zhaoxiaofeng44/robot_arm/README.md

# myArm — 3D打印肘关节机构 + 三节手指机构 + 整手机构（单指反根验证版）

仿人手臂/手指的双关节直线驱动机构：一台贴臂圆柱直线电机通过一根刚性连杆驱动一个转动关节。
所有关节均为**外购可拆肩螺栓（塞打螺丝）+ 平垫 + 尼龙自锁螺母**，全机一套内六角扳手即可反复拆装。

## 三个模型

| 模型 | 文件 | 构型 |
|---|---|---|
| **肘关节机构 v5** | `arm_mechanism_3d.html` | 上臂(300)固定 + 前臂(250)绕 O 转动 0–120°，电机 A=(28,213)，BD 连杆 85mm，行程 59.393mm |
| **掌+三节手指** | `finger_mechanism_3d.html` | **三个上述单元串联**：掌(300,固定,载电机0) →[关节0/MCP]→ P1 近节(300,载电机1) →[关节1/PIP]→ P2 中节(300,载电机2) →[关节2/DIP]→ P3 远节(250+指尖)；三个关节逐项同方案，安全包络 90°/90°/70° |
| **整手机构** | `hand_mechanism_3d.html` | **五指整手 = 15 个屈曲单元 + 掌fold对掌副**：五指各 3 屈曲关节（拇指与四指逐件同构）；掌骨板A 在拇指/食指之间分成两半——固定半（食指侧）+ 转动半 `thumbPalmFlap`（载拇指桥与整个拇指），掌侧锚定 1 台横向直线电机经 85mm BD 连杆折叠转动半，把拇指扫向掌心/食指侧（−12°..+5°）；四指另有指根展开/并拢副（±5°）；机构平面互相平行（指距 70mm）；**反根装配**、1:1 机构级概念尺度；15 屈曲电机 + 5 横向电机 / 20 连杆 / 100 打印件 + 1 掌fold转动半 |

浏览器打开 HTML 即可交互（滑杆调角度、播放动画、切换视图/标签/轨迹）。

## v8 扩展（第三个关节：掌指关节 + 掌的联动）

按「关节方式和现有两节一样」把关节数从 2 增到 3，插入点在最根部（掌 ↔ 近节）：

| 项 | 改动前 | 改动后 |
|---|---|---|
| 链条 | 掌件(P1 兼基节) ─O1─ P2 ─O2─ P3 | **掌(固定,载电机0) ─O0─ P1(载电机1) ─O1─ P2(载电机2) ─O2─ P3** |
| 单元 | 2 个（同构） | **3 个（同构）**：P1 与 P2 逐件同几何，打印件可互换 |
| 原有件 | 原 P1 = 基节；原 P2 = 中节 | 原 P1 → **掌段**（前缀 palm/m0/t0，肩螺栓 o0）：本体/指根方块/掌骨法兰/电机/叉耳逐件原样，仅去掉近端被驱动接口（袖套+毂+D侧板，掌为固定根不需要）；原 P2 → **P1 近节**（前缀 p1/m1/t1，肩螺栓 o1） |
| 新增件 | — | **P2 中节 = 原 P2 逐件同几何**（前缀 p2/m2/t2，肩螺栓 o2） |
| 实现 | 两段各自手写 | 抽出通用构造 buildDrivenPhalanx(parent,pfx,segLen,mPfx,tPfx)，P1/P2 各调一次；三个单元的运动学完全独立 |
| 运动学 | getJoints(a1,a2) | getJoints(a0,a1,a2)：P1 绕 O0、P2 绕 O1（相对 P1）、P3 绕 O2，逐级复合到世界系；闭合误差仍 4.3e-14mm |
| UI | 2 滑杆 | **3 滑杆**（θ0 MCP / θ1 PIP / θ2 DIP）+ 预设 0/0/0、45/45/35、90/90/70 + 三关节同比联动 |
| 臂展 | 掌→指尖 864mm | **1164mm**（多一节 300mm 指节；掌段长度由电机+连杆布局决定，与单元同长） |

**新增安全行程包络 90°/90°/70°**：三个关节各自能到 120°，但同时在末端大角度卷曲时指尖会卷回掌段躯体（真实手指同样卷不进掌心）。用 5° 三维网格（0..120° 全组合，15625 姿态）扫出边界后取安全盒，滑杆与演示动画均限制在包络内。

## v7 修正（连接物理性 + 校验器可信度）

本版把「连接是否物理成立」做成可独立审计的项（`verify_connections.cjs`，arm / finger / hand 三件分别出报告），
并修掉四处**会骗过校验**的问题：

| # | 问题 | 修正 |
|---|---|---|
| 1 | 电机前法兰画成 Ø38 圆盘，4×M4 孔却放在 r=20.6（**完全落在盘外**）→ earcut 生成自交碎片、工具通道射线被幽灵面挡住 | 三件模型统一改为 **38×37×4 方形法兰板**（4×Ø4.4 完整在板内 + 中心 Ø10 推杆孔）→ 肘·可拆装性恢复 **50/50** |
| 2 | `verify_finger.cjs` 把 2D 凸包点当 3D 用（`p[2]` 恒为 `undefined`）→ 投影全为 NaN，**碰撞检测与间距测量整体失效**（旧报告的"0 碰撞"是假通过） | 改为 `(p[2]\|\|0)`，与 `.verification/geom2d.cjs` 一致 |
| 3 | 投影修好后暴露真问题：P2 远端躯体一直伸到 O2，插进 P3 的 Ø20 袖套/毂（**实体重叠 127mm²**） | P2 远端躯体止于 `-300+13`，与手版对称让位（叉耳继续承担关节连接） |
| 4 | 手版反根链：P3 多出一套叉耳、P3 袖套被搬去 P1（落在 O1）、t2 连杆组被搬进 `p2Body` 后仍按世界坐标摆位（D 眼环漂移 ~1.5mm 扫入 P3 腰身） | 删重复叉耳、袖套留在 P3、连杆组挂世界系 |
| 5 | 两个校验器把**嵌套电机**判成所在指节（手版组名 `motor2Fixed`、手指版顺序在 phalanx 之后）→ 推杆/缸体同轴滑动副、电机前法兰与安装板的设计接触被当成"非配合零间距" | 分类器统一为「先电机后指节」+ 前缀匹配；安装板按 `p*FlangePlate` 命名匹配 |

## 核心设计（v5）

- **BD 连杆 = 等宽长条 100×15×8mm**（R7.5 圆弧端，孔壁 3.2mm）——不再有环眼凸台；
- **全部关节可拆**：O 用 Ø10×26、B 用 Ø8×18、D 用 Ø8×20 肩螺栓 + 自锁螺母，取代 v4 的永久镦铆钉；
- **B 叉头**为独立件：开放双耳 + M6 螺母沉龛夹持桥（螺母坐底板顶面、围壁防转），推杆端部螺纹旋入即完成连接；**拉力靠螺纹副+防转**、压力由底板承担；
- **D 叉耳**为贴前臂侧面的双侧板（位于连杆 z 带之外），消除 v4 跨连杆桥板的实体干涉；
- **电机安装**：前法兰承推（法兰 y[137,141] 顶面 **面接触**安装板底 y=141，4×M4 自下向上）+ 后部 300° 开口抱箍（独立件，**双侧耳板 z=±7..11**，2×M4 贯穿臂身），卸 4 颗螺栓即可轴向抽出电机；
- **轴向浮动 1.0mm/侧**，所有孔轴沿 Z（= 打印方向），抽销后连杆/轴套沿 Z 滑出；
- 手指版机械结构零改动：**同一机构实例化三次**（掌 + 三节指骨），每个被驱动段的近端是上一单元的前臂接口、远端是本单元下级关节的上臂接口，电机安装臂逐级向指尖一侧前移。

## 一键校验

```bash
node verify_all.cjs          # 完整模式（肘版碰撞 0.05° 步进，数分钟）
node verify_all.cjs --quick  # 快速自查（0.5° 步进）
```

当前结果：

| 校验 | 结果 |
|---|---|
| 肘·运动学与全行程碰撞（0.05°、2401 姿态、104 网格 3450 对） | 碰撞 **0**，非配合连续下限 **+0.651mm** |
| 肘·可拆装性 `verify_serviceability.cjs` | **50/50** |
| 肘·3D打印适配性 `verify_print_geometry.cjs` | **28/28** |
| 肘·STL 完整性 `check_stl.cjs` | 0 问题文件 |
| 手指·三关节碰撞与闭合 `verify_finger.cjs` | 安全包络内 2° 三维网格 76176 姿态 + 三关节各自 0.05° 细扫：碰撞 **0**（2912 候选对），非配合连续下限 **+0.738mm**（最小间隙 1.000mm），闭合误差 **4.3e-14mm**，可拆装/互换 **54/54** |
| 手指·打印与拆装 `verify_finger_print.cjs` | **148/148** |
| 整手·五指 15 单元碰撞与闭合 `verify_hand.cjs`（**反根装配**） | **扩展拇指为 3 关节后需重跑**：15 关节 0.05° 细扫 + 每指安全包络 5° 三维网格 + 整手抓握/极值/随机姿态；预期闭合误差仍为 1e-13mm 量级、肩螺栓 45 组、可拆装/互换 **100/100**（含 5 台展开/并拢副）；五指指尖 y 同位（拇指与四指同长） |
| 整手·展开/并拢副（新增第 6 自由度×5 指） | 铰链枢轴 = 掌骨安装件底面 **y=289mm**；**电机本体装到手指上**（随指根摆）：机体 Ø36×80、轴线指侧 z=+30、y∈[198,278]，推杆下端 B（y≈−96）经**水平外伸臂**把 85mm 连杆带到 **x=+30 机构平面**（电机体 x±18、手指 x≤13 之外，连杆全程不穿电机体）；连杆另一端拉**掌骨头固定 D 锚**：+x 叉耳→conn 悬臂→吊耳→Ø8 D 销（x∈[24,36]、y=−11、z=30；φ=0 时连杆竖直、力臂 30mm）；闭合 `|BD| ≡ 85.000mm`（φ=−12…12° 恒等，闭式二次解）；实体干涉 45 项全清；quick 复跑 **0 碰撞 / 最小间隙 1.000mm**、展开副逐指 12 项全绿、可拆装互换 **95/95** |
| 展开副连接物理性 `verify_spread.cjs` | 逐指 **12 项 / 全机 60 项全绿**：Ø10 铰链销轴线沿 x 且与叉耳孔 L/R + 毂孔三心同轴（Δ=0.00mm）、Ø8 D 销与**掌侧 D 双耳** + 连杆 D 端环同轴、B 销（外伸臂末端）与连杆 B 端环同轴、掌侧 D 锚链连续（叉耳→conn→臂→吊耳兜住 D 销）、φ=±12° 全程 `\|BD\| ≡ 85.000mm`（偏差 0.00e-6mm）、推杆不顶死 |
| 整手·100+1 打印件出档 `export_hand_stl.cjs` + `check_stl.cjs` | **101 件**（五指 5×19 + 骨架 6：掌板A分固定半+拇指转动半）按类型出 **17 个 STL**，最大件 208mm（适配 220mm 床），13 项外购 BOM |
| 连接物理性 `verify_connections_all.cjs`（arm / finger / 整手五指） | 三个目标、**整手逐指 5 条链**均「**全部连接物理上成立**」：销轴真穿孔 / 闭环与锚点距恒为 85mm / 无死点 / 抱箍双侧耳板 / 拼接螺栓通孔 / 螺母落位 / **掌骨板孔位与指根法兰 4×Ø4.2 + 4×Ø9 逐孔对位**（整手特有） |

## 文件索引

**模型与文档**
- `arm_mechanism_3d.html` / `finger_mechanism_3d.html` / `hand_mechanism_3d.html` — 可交互 3D 模型（唯一几何真源，校验器从中提取）
- `arm_design_spec.md` / `3d_print_optimization.md` — 肘版设计说明与打印优化
- `finger_design_spec.md` — 手指构型（掌+三关节）、关节衔接、**安全行程包络**、打印件清单、校验结论
- `hand_design_spec.md` — **五指整手**构型（**反根装配** + **掌fold拇指对掌**：掌板A分半+掌侧横向电机折叠）、15 个屈曲关节 + 5 个横向电机、掌体骨架接口与螺钉避让、安全包络、101 件打印清单、尺度与设计取舍
- `assembly_guide.md` / `finger_assembly_guide.md` / `hand_assembly_guide.md` — 装配/拆解顺序、力矩表、打印注意

**校验器**
| 文件 | 作用 |
|---|---|
| `verify_all.cjs` | 一键跑全部校验并输出总表 |
| `verify_near_joint.cjs` | 肘版运动学闭合 + 全行程碰撞扫描（配合区=孔半径+0.6mm） |
| `verify_serviceability.cjs` | 肘版工具/抽销通道、轴向浮动、等宽长条、无永久连接 |
| `verify_print_geometry.cjs` | 肘版孔/倒角/壁厚/连通性/幅面 |
| `verify_finger.cjs` | 手指三关节闭合 + 三关节细扫 + 安全包络内三维网格碰撞扫描（含三单元互换性） |
| `verify_finger_print.cjs` | 手指 STL 幅面/落地/关键孔 + 三单元可互换 + 拆装通道 |
| `verify_hand.cjs` | **整手五指 15 单元**闭合/行程/传动角 + 逐关节 0.05° 细扫（按**反根**链条取逐关节运动子树算间隙允差）+ 每指安全包络 5° 三维网格 + 整手姿态（等比抓握/单指极值/随机 400 组）碰撞扫描（2.5D 判据 + 3D 实体求交复核）+ 骨架—指根螺钉避让 + 可拆装/互换性动态统计（含反根链条父子关系） |
| `verify_connections_all.cjs` / `verify_connections.cjs` | **连接物理性审计**：逐关节检查「谁绕谁转」「谁跟着谁动」「缺件/重复件/销轴是否真穿过两件」，arm / finger / hand 三件分别出报告 |
| `check_stl.cjs` | STL 可切片性（法线/退化三角面等） |

**出档与预览**
- `export_print_stl.cjs` → `stl/`（肘版 7 打印件 + 11 项外购 BOM）
- `export_finger_stl.cjs` → `stl_finger/`（手指 19 打印件 + 12 项外购 BOM）
- `export_hand_stl.cjs` → `stl_hand/`（整手 **100 打印件**按类型出 16 个 STL + 13 项外购 BOM；同规格件几何逐件相同，故按类型出档并标注数量）
- `render_print_preview.cjs` / `render_finger_preview.cjs` / `render_hand_preview.cjs` → `preview/`（软件渲染多视角 PNG，无 GPU 依赖）
- `arm_near_joint_params.json` / `finger_verify_report.json` / `finger_print_report.json` / `serviceability_report.json` / `hand_verify_report.json` — 校验报告
- `connections_verify_report_{arm,finger,hand}.txt`（+ `connections_audit_*.log` 逐条审计流水）— `verify_connections.cjs` 三件各自的连接物理性报告

## 打印与选型

- 工艺：FDM 0.4mm 喷嘴、层高 0.2mm；孔轴全部沿 Z 竖直免支撑；关节/连杆 100% 填充，臂身 25–40%。
- 材料：指节/叉头/抱箍 PETG 或 PLA+；连杆 PETG/PA-CF；紧固件外购 304 不锈钢。
- 幅面：最大打印件 45° 斜排 ≤ 220mm（手指版最差件 palm_proximal / p1_distal / p2_distal）。
- **执行器选型**：需缸体 ≤80mm、行程 ≥60mm 的紧凑型直线推杆电机（肘版 1 台，手指版 3 台）；整手版按 0.5× 换算为 **Ø20×40mm、行程 ≥30mm、带位置反馈，共 10 只**。
- 连杆为名义刚性概念设计：5kg@250mm 时峰值拉力约 618N，实物需按实际工况重做强度/屈曲/疲劳校核。

## 五指整手的安全行程（目标设计；当前单指模型未启用）

10 只 Ø20×40 电机 + 5 根长指无法在 0–120° 全交叉积上做到零接触，因此整手声明并校验了一个**安全行程包络**：

| 指 | 上限 | 原因 |
|---|---|---|
| 食指 / 中指 / 小指 | **120°** | 全程无干涉 |
| 无名指 | **70°** | 再大时 t2 连杆摆到掌体指根座（首次接触 68°） |
| 拇指 | **45°** | 再大时 P3 远节扫入中指/无名指近节区（首次接触 48°） |

> **上表是旧「0.5× × Z 分层」五指方案的逐指约束，已被现行平行布局取代**：现版五指机构平面平行、间距 70mm（零件 z 向半宽 ≤18mm，相邻指间隙 ≥34mm），`verify_hand.cjs` 三维扫描证实**指间无需额外限位**，五指统一 90°/90°/70°。详见 `hand_design_spec.md`「安全行程包络」。

## 局域网访问（手机 / 平板 / 其它电脑看 3D 模型）

页面是纯静态 HTML + 本地 `vendor/`，不需要联网 CDN，直接用 HTTP 静态服务发布即可：

```bash
./serve_lan.sh status   # 查看状态与局域网地址
./serve_lan.sh start    # 启动（默认端口 8123，绑定 0.0.0.0）
./serve_lan.sh stop     # 停止
```

服务由 macOS launchd 用户代理 `com.myarm.robotarm.http` 托管（`~/Library/LaunchAgents/`），
登录后自动启动、进程掉线自动拉起，不依赖任何终端窗口；日志 `/tmp/myarm-http-8123.log`。

访问地址：`http://<本机局域网IP>:8123/`（当前为 `http://192.168.1.20:8123/`），
三个页面分别是 `/arm_mechanism_3d.html`、`/finger_mechanism_3d.html`、`/hand_mechanism_3d.html`。
换端口/换目录改 plist 里 `ProgramArguments` 后 `./serve_lan.sh start` 重启即可。

> 说明：肘版、手指版、整手版均为 **1:1 机构级几何模型**（`P.scale` 只影响场景显示，不影响 mm 参数）。整手是把同一肘关节单元串成 5 指（五指各 3 关节 = 15 单元）的开放桁架概念模型，不是人体尺度可穿戴假肢；校验脚本不含绝对尺寸假设，整体等比缩放机构参数即可换尺度。
