zhaoxiaofeng44/robot_arm/hand_design_spec.md

# 五指整手机构（`hand_mechanism_3d.html`）— 五指×3 = 15 个同构关节单元

> 唯一几何真源 = `hand_mechanism_3d.html`；本文数值全部实测自模型与 `hand_verify_report.json`。
> 整手 = 五指（各 3 关节）= **15 个「直线电机 + BD 长条连杆」关节单元**，
> 单元几何与肘版 v5 / 手指版 v7 **逐件相同**（同一套参数化代码），只多出掌体骨架与五指布局。
> **本轮改动**：拇指由 2 关节扩为 3 关节（新增中节 P2 与 PIP 关节），与其他手指逐件同构，
> 使拇指能像四指一样向掌心卷曲完成对捏；并在拇指根部新增横向对掌电机，把拇指拉向掌心/食指侧完成对捏。

## 构型

| 手指 | key | 关节数 | 基节 z (mm) | 段长 (mm) | 安全包络 |
|---|---|---|---|---|---|
| 食指 | `index` | 3 | −90 | 掌段300 + 300 + 300 + 末节250 | 90° / 90° / 70° |
| 中指 | `middle` | 3 | −20 | 同上 | 90° / 90° / 70° |
| 无名指 | `ring` | 3 | +50 | 同上 | 90° / 90° / 70° |
| 小指 | `pinky` | 3 | +120 | 同上 | 90° / 90° / 70° |
| 拇指 | `thumb` | 3 | −220 | 掌段300 + 300 + 300 + 末节250 | 90° / 90° / 70° |

- **尺度 = 1:1 与手指版同尺寸**（`P.scale=0.35`，mm 参数原样）：整手伸直全长 1250mm，五指同长（拇指 1250mm），
  指尖 y≈−864mm（全五指），腕板顶 y=352mm；这不是人体尺度，而是**机构级概念模型**（见文末「设计取舍」）。
- **布局（反根装配，本轮）**：每个指头都**把「指尖那一端」接到手掌** —— 接掌固定段 = 原末端段 Pn，
  它固定不动，其远端面外 26mm 挂掌骨安装法兰（法兰面 y=326 与掌骨板共面，孔位/让位孔与旧版逐点相同）；
  自由端 = 原指根端的**掌段**，带 Ø24 圆头 + 防滑抓握垫 —— 这就是**现在的指尖**
  （指尖 y≈−864 全五指，与旧版四指同位）。五指机构平面共面（`fan=spin=0`），MCP 关节 O0 随自由端摆动。
  掌骨板 66(x)×10(y) 横跨 z∈[−253,153]（406mm），指距 `HAND.spacing=70mm`。
- **五个机构平面互相平行**（`fan=0, spin=0`）：五指同为 XY 平面机构，整手是「五片平行机构 + 一片掌骨板」的开放桁架。
- 每关节单元 = 1 台 Ø36×80 圆柱直线电机 + 1 条 BD 等宽长条连杆（100×15×8）+ 1 组可拆肩螺栓副；
  整手合计 **15 台电机 / 15 条连杆 / 45 组肩螺栓**（O、B、D 各 15 组）。

## 关节衔接（15 个关节逐项相同，与肘版 v5 一致）

| 关节 | 销轴 | 配合 | 轴向浮动 |
|---|---|---|---|
| O（转动副） | Ø10 h9 肩螺栓 + 平垫 + M8 尼龙自锁螺母 | 叉耳内档 16 − 袖套 14 | 1mm/侧 |
| D（连杆端） | Ø8 h9×20 肩螺栓（含 1mm 凸台）+ 平垫 + M6 自锁螺母 | 耳内档 10 − 连杆 8 | 1mm/侧 |
| B（推杆端） | Ø8 h9×18 肩螺栓，M6 螺母沉入 B 叉头沉龛 | 同上 | 1mm/侧 |

运动归属（**反根：每节电机驱动自身**）：**电机 k 固定在段 k 上**，推杆 B 端经 BD 长条连杆把
**段 k 绕它自己的远端关节 Ok 转动** —— 与单指版 v7 的「反根」装配同一套关系：
链条 `groups = [掌段, P1, …, Pn]` 中 **Pn 是接掌固定段**（远端挂掌骨安装法兰 + 指根方块），
**掌段是自由末端**（载电机 0，带指尖圆头/防滑垫）；段 j 经一层关节组挂在段 j+1 上，
每帧 `joints[j].rotation.z = −θj`（五指 n=3）。
**相对转角与正向完全相同**，只是父段换到远端侧；整链再绕 Z 镜像 180° 落到掌面另一侧
（镜像面 y=M，纯旋转 det=+1、不产生镜像件），故闭合/行程/传动角方程无需重推。

## 运动学（每单元独立，与肘版/手指版完全一致）

- 以各自关节为原点：A=(28, 213)（电机轴心）；D=(14cosθ+31sinθ, 14sinθ−31cosθ)；
  BD 中心距 `tendonLinkLen=85mm`；单关节行程 `strokeMax=59.393mm`；`s_extended=136.7mm`；
- 三个关节各自独立一套 A/B/D（相对自身关节），角度→行程用 `angleToStroke`，行程→角度用二分反解；
- 传动角在安全包络内 33.8°–89.7°（`verify_hand.cjs` 实测）。

## 掌体骨架（5 个打印件 / 13 个网格）

| 件 | 尺寸 | 作用 |
|---|---|---|
| `palmPlateA` | 66×10×(z −150…−55) | 掌骨板A·**固定半**：食指指根接口 + 顶部拼接条/腕块螺栓孔；分缝 z=−150 装掌fold铰链 |
| `thumbPalmFlap` | 66×10×(z −253…−150) | 拇指掌板·**转动半**：拇指指根接口 + 拇指桥；掌侧横向电机折叠，带动整个拇指对掌 |
| `palmPlateB` | 66×10×(z −55…153) | 掌骨板B：中指 + 无名指 + 小指指根接口 |
| `palmSpliceTop` | 66×6×(z −80…−30) | 顶部拼接条：4×M5 **自下而上**穿板旋入条体，把 A/B 拉成一体 |
| `wristBlock` |  80×32×(z −140…58)，含 4×Ø14×6 凸台 | 腕拼接块：4×M5 旋入掌骨板 + Ø40 走线孔 + 4×Ø9 腕接口 |
| `thumbBridge` | 66×10×(z −252…−145)，含 4×Ø14×10 凸台 | 拇指桥：2×M5 旋入板A + 4×M5 锁住拇指法兰 |

**指根接口**（反根后挂在**末端段 Pn 的远端面外 26mm**，位置与旧版逐点相同；每指一组，随 spin 滚转，本设计 spin=0）：
4×Ø4.2（掌骨板侧 M5 螺纹底孔，与法兰外圈 4×Ø5.5 对位，孔距 44×44）
+ 4×Ø9（让开指根方块顶面的 M4 螺栓头，与 `rootBoltXZ` ±8/±7 同心）
+ Ø9 中心走线孔。法兰 M5 自法兰下方往上旋入板内，M4 螺栓头正好落进 Ø9 让位孔。

**分缝与紧固件避让**：掌骨板在 z=−55 断开（198/208mm，均小于 220mm 打印床）。该分缝落在
「无指根法兰」的 z 空档 (−62…−48) 内；骨架全部紧固件都布置在这类空档：
拼接条 4×M5（z=−58/−52）、腕块 4×M5（z=−135 落在宽空档 −192…−118、z=+15 落在空档 8…22）、
拇指桥 2×M5（z=−165）。因此**没有任何骨架螺钉或螺母落在指根法兰足迹内**，可用套筒从下方装配。

## 安全行程包络（`verify_hand.cjs` 三维姿态扫描确定，本轮）

五指 90°/90°/70° —— 与手指版一致：五指机构平面间距 70mm，
各指零件 z 向半宽 ≤18mm，相邻指间隙 ≥34mm；扫描证实**在 1:1 平行布局下五指互不干涉**，指间无需额外限位。
相对旧「0.5× × Z 分层 ±40/±13.3mm」的五指方案，本版取消了分层与分指角，改为平行共面布局。

## 校验（`node verify_hand.cjs`，本轮结果见 `hand_verify_report.json`）

- 逐关节细扫（STEP=0.05°，各关节独立 + 其余归零）：求**连续间隙下限**（扣除步长允差）；
- 每指安全包络内三维网格（GRID=5°）：单指自干涉 + 与骨架/邻指干涉；
- 整手姿态：五指等比抓握 u=0→1（11 档）/ 单指极值 / 拇指-食指组合 / 400 组随机姿态；
- 2.5D（XY 投影 + z 区间）判据 + **3D 实体求交复核**（用于任何自转手指的跨件配对）；
- 配合区半径 = 销轴孔半径 + 0.6mm（O: 5.9mm；B/D: 4.9mm），区内重叠视为销轴设计配合；
- 闭合误差（B–D 中心距 vs 连杆长）、行程一致性、传动角；
- 可拆装性与互换性（数量动态统计，15 单元 × 3 关节 × 5 件紧固件齐套）：无铆接、**反根链条父子关系**
  （Pn(固定·接掌) → 关节组 n−1 → P{n−1} → … → 关节组 0 → 掌段(自由·指尖)）、
  以及**剥掉指名前缀后逐件比对局部顶点集**（拇指 P1/P2/P3 ≡ 四指 P1/P2/P3；近节 P1 ≡ 中节 P2 等）。

### 本轮实测结果（`node verify_hand.cjs` 完整模式，STEP=0.05° / GRID=5°）

> ⚠️ 拇指扩为 3 关节后，本表数值需要重新运行 `node verify_hand.cjs`（完整模式）回填；
> 下表保留上次 14 单元构型的测量值供参考。结构性数量已更新：15 关节 / 45 组肩螺栓 / 100 打印件。

| 项 | 结果（14 单元旧构型） |
|---|---|
| 扫描姿态 | **45584**（14 关节细扫 + 5 指包络网格 + 整手抓握/极值/随机 400 组；逐关节按**反根**运动子树取允差） |
| 候选配对 | **14679**（其中配合区配对 2963，按 5.9 / 4.9mm 半径归属销轴）；2.5D 判据被 3D 实体求交否决 **0** |
| 配合区之外碰撞 | **0** |
| 非配合最小间隙 | **1.000mm**（掌段 D 端拼接垫/本体 与 电机0 前法兰的既有 1mm 设计间隙） |
| 连续间隙下限 | **+0.192mm**（= 1.000 − 0.808 步长允差；反根后最大运动半径 926mm 落在食指 O2） |
| 闭合误差 \|BD\|−85 | **8.5e-14 mm** |
| 行程一致性 | 最大偏差 **2.53mm**（13 单元，全行程） |
| 传动角范围 | **33.8° – 89.7°** |
| 可拆装性 / 互换性 | **85/85** |
| 连接物理性（逐指 5 条链） | 全部成立：销轴真穿孔、锚点距恒 85mm、无死点、掌骨板孔位逐孔对位（反根装配后法兰—板接口逐孔复核） |
| STL 出档（旧构型） | 95 打印件 → 16 个 STL，问题文件 **0**；新构型为 **100 打印件 → 16 个 STL** |

## 打印件与出档（`node export_hand_stl.cjs` → `stl_hand/`）

**101 个打印件** = 五指 5×19 + 掌体骨架 6（掌板A固定半 + 拇指掌板转动半 + 掌板B + 顶部拼接条 + 腕块 + 拇指桥；掌fold对掌副另含 1 台掌侧横向电机与铰链件）。
由于同规格件几何逐件相同，按类型输出 **17 个 STL**，每个文件在 `index.json` 中标注打印数量与用处：

| STL | 数量 | 说明 |
|---|---|---|
| `finger_palm_proximal` / `finger_palm_distal` | 5 / 5 | 掌段两件（自由端：含 Ø24 圆头+半球垫+电机0安装板 / 含叉耳） |
| `finger_phalanx_proximal` / `finger_phalanx_distal` | 10 / 10 | 近节≡中节（五指各 2，共 10 节，同件） |
| `finger_terminal_proximal` / `finger_terminal_distal` | 5 / 5 | 末节（五指 P3 同件；**接掌固定段**，远端段含指根方块） |
| `finger_motor_collar` / `finger_b_clevis` / `finger_bd_link` | 15 / 15 / 15 | 每屈曲关节一套，全手通用 |
| `finger_palm_mount` / `finger_grip_pad` | 5 / 5 | 掌骨法兰（挂末端段远端）/ 指尖抓握垫（随掌段自由端） |
| `chassis_palmPlateA`（固定半） / `chassis_thumbFlap`（拇指转动半） / `palmPlateB` / `palmSpliceTop` / `wristBlock` / `thumbBridge` | 各 1 | 掌体骨架 6 件（掌fold：固定半+转动半经 Ø10 铰链 + 掌侧横向电机相连） |

外购标准件 13 项（45 组肩螺栓 + 自锁螺母/平垫 + 抱箍/法兰/拼接/骨架螺钉），见 `index.json` 的 `purchased_parts_bom`。
所有 STL 已按打印姿态落地（销轴孔轴 = Z 竖直，z=0 落床），最大件 208mm，全部适配 220mm 打印床。

## 预览图（`preview/hand_*.png`，`node render_hand_preview.cjs` 重新生成）

伸直等轴 / **指距（沿 +x，五指并列、70mm 间距、五指掌骨法兰共面）** / **单指机构平面正视（沿 +z，只留食指，
看「电机—推杆—BD 连杆—销轴」共面关系）** / 抓握 u=0.6 / 满握 u=1.0 / 拇指-食指捏合 / 掌体骨架单独 /
掌指关节特写 / 指尖抓握垫特写 / 腕接口特写，共 10 张。

取景朝向有自检：模型长轴 = y（掌骨板/腕在 +y，指尖朝 −y），所有主视图以 **+y 为画面“上”**，
脚本逐张断言「掌骨板上沿 screenY < 中指尖 screenY」并打印，确保**接掌固定端在上、指尖在下**
（抓握 u=0.6 与满握 u=1.0 两图例外：自由端按设计卷向掌侧，故单独标注）。

## 设计取舍（重要，勿再走回头路）

1. **尺度诚实**：1:1 下整手 1250mm 长、406mm 宽的掌骨板 —— 这是**开放桁架式概念模型**，用来把
   「同一肘关节单元能否串成多指手」验证干净，而不是可戴在手上的假肢。旧文档「10 台电机放不进人手掌」
   的结论在 1:1 条件下不再适用（本设计根本不试图塞进手掌）。
2. **拇指对掌 = 掌fold（掌板分半），不做整指 spin 滚转**：曾采用 `spin=−30°` 让拇指屈曲平面与四指成 30°，
   三维扫描证实末节屈曲约 36° 即扫入食指机构平面 → 已回退 `spin=0`；也曾把横向副装在拇指根部（指根毂铰链），
   用户确认改为**掌板分半**方案：掌骨板A 在拇指/食指之间（z=−150）分成固定半与转动半 `thumbPalmFlap`，
   转动半载拇指桥 + 指根法兰 + 整个拇指，掌侧锚定横向直线电机（x=40 机构平面）经 85mm BD 连杆拉曲柄，
   绕掌板厚度中线（y=331）的 Ø10 铰链折叠 −12°..+5°，拇指随之扫向掌心/食指侧；屈曲关节仍为 3 个，与其他手指同构。
3. **骨架是平板不是掌骨**：掌骨板 + 拼接条 + 腕块 + 拇指桥仅提供「五指共面安装基准 + 腕接口」，
   不含腕骨关节、不含走线槽（仅有 Ø9 走线孔）、不含蒙皮/限位挡块。
4. **手指版关系**：`finger_mechanism_3d.html`（单指三关节，v7 反根）仍是关节单元的设计母本；整手的关节、拼接、
   电机、指尖几何与其**逐件相同**，因此两个模型的校验器（`verify_finger.cjs` 与 `verify_hand.cjs`）结论可互相印证。
   整手本轮同样改为**反根**装配：端点归属（谁接掌、谁当指尖）与单指版 v7 一致，
   段内相对几何、电机驱动关系、闭合/行程/传动角逐项相同，故校验中只有**运动件归属**随之改写
   （逐关节运动子树、链条父子行）。
   `verify_connections.cjs` 的 hand 目标同样覆盖整手连接物理性。

---

## 展开/并拢副（第 15–19 台直线电机，每指 1 台，绕 x 轴外展/内收）

**为什么加在这里**：外展/内收（分指/并指）在解剖上对应掌指关节的侧向摆动，枢轴必须落在
"手指与手掌的交界"。反根装配后这个交界就是**指根方块（24×22×17）+ 56×56 掌骨法兰**与
**接掌段 Pn 段体**之间的那道缝 —— 因此新增铰链的轴线就取这条缝，且 `y = 289mm`（= 毂心）。

**必须同步改的一件事**：方块经 4×M4 锁在法兰上、法兰经 4×M5 锁在掌骨板上（孔组一字未动），
物理上不能随指根摆 —— 于是把这整组**从转动链搬到固定侧**（`MountAsm` 挂到 `<指>_root`，
世界位姿用矩阵分解原地保持），方块厚度 20→17（底面抬到 y=303）给摆动让位。

| 件 | 位置/尺寸 | 作用 |
|---|---|---|
| 叉耳 ×2 | x=±10.5、4 厚、y∈[275,305] | 固定侧铰链座（与方块一体，随安装件不动） |
| Ø10 肩螺栓 | 轴线沿 x，过叉耳 + 毂 | 铰链销（与 15 个关节同规格肩螺栓） |
| 毂 | Ø22×13、Ø10 孔，R11 | 转动侧，与接掌段同一打印件（固连） |
| **掌侧 D 锚**（conn+悬臂+吊耳） | conn x∈[11.5,13.5]/y∈[−4,4]/z∈[9,33]；臂 x∈[12,26]/y∈[−3,4]/z=30；吊耳 x∈[24,36]/y∈[−11,−3]/z=30 | **固定锚**：从 +x 叉耳越头顶到 x=24–36 的悬臂+吊耳，兜住 Ø8 D 销（整条在电机体 x≤18 之外/之上，随指根摆动最坏余量 ≥3.2mm） |
| D 双耳 + Ø8 销 | x∈[24,36]、y=−11、z=30（沿 x） | 与 BD 连杆 D 端环配合（同型件）——**锚在手掌侧、固定** |
| 电机（**装在手指上**） | Ø36×80，轴线沿 y，落在指根局部 **(x=0, z=+30)**，机身 y∈[198,278]（随指根摆） | 与外展关节同原理的"电机在可动件上"，另一端拉固定锚 |
| 抱箍 2×M4 + 安装板 4×M4 | 安装板 y∈[148,156] | 电机固定 |
| **B 外伸臂** | 横梁 x∈[−2,38]、y≈−96（推杆下端）、z=30 ±3，末端 B 双耳 + Ø8 B 销（x∈[24,36]） | 推杆末端把连杆 B 端环带到 **x=+30 机构平面**（在电机体 x±18 与手指 x≤13 之外，连杆不穿任何件） |
| BD 连杆 | 85mm 同型件，机构平面 **x=+30** | 推杆（B，手指侧）→ 掌侧 D 锚（固定），与手指单元同一根连杆 |

**闭合关系（解析闭式，无需迭代）**：B 在指根局部系（推杆末端）为 `(0, t, 30)`，随指根绕 x 转 φ 后
`B(φ) = (t cosφ − 30 sinφ, t sinφ + 30 cosφ)`；D 锚固定在掌骨头局部 `(dY, dZ) = (−11, 30)`；
解 `|B(φ) − D| ≡ L = 85mm` 得 `t(φ)`（一元二次闭式，取展开支；φ=0 时 t = −96）⇒ 恒等闭合（φ=±12° 实测偏差 0.00e-6 mm）。
力臂 = 铰链到连杆作用线的距离 ≈ 30mm（φ=0 连杆竖直、过轴线 z=30）；φ=±12° 推杆只用 ±5.4mm（59mm 全行程的 9%），
故后续可直换成 Ø20×40 小型电机。

**安全包络（实测，`verify_hand.cjs` 同判据的三维扫描）**
- 对称扇开（index +u / middle 0 / ring −u / pinky −2u / thumb +2u）：**u ≤ 12°，间隙全程 > 0**（各指互相远离）。
- 单指单独摆动：**≤ 1.5°**（指距 70mm，Ø36 电机相邻间隙 34mm；2° 即接触）。
- 预设按钮「分开」取 u=6°（最外指 12°），「并拢」取 u=0.75°，均在包络内。

**新增件数**：电机 +5（共 19）、BD 连杆 +5（共 19）、肩螺栓组 +10（Ø10 铰链 ×5 + Ø8 D 销 ×5，共 52 组）、
掌侧 D 锚（conn/悬臂/吊耳 ×5，随叉耳/安装件同件打印）、B 外伸臂（横梁+双耳 ×5，随推杆/毂同件打印）——取消原吊架/指根 D 叉耳，
故 **STL 仍为 100 件 / 16 个文件**（拇指扩为 3 关节后打印件 +5：中节近/远段 + 电机2抱箍 + B叉头 + 连杆；全部与四指同规格件互换）。

**机构平面偏移（x=+30）的必要性**：若坚持与原方案同面（x=0，与电机轴线共面），推杆末端 B 到指外 D 锚的直连杆
必然横穿 Ø36 电机实体（电机体 x±18 包住整条直线段），且随指根摆动时电机扫过 x∈[−18,18]/z∈[12,48] 会撞任何 z≥12 的固定件。
因此把连杆机构平面整体偏到 x=+30：B 端经推杆下端的**水平外伸臂**送到 x=30（横梁在电机体下方 y≈−96，不穿电机），
D 锚经叉耳→悬臂→吊耳送到 x=24..36（在电机体 x≤18 之外，随摆最坏余量 ≥3.2mm）；x 坐标不受绕 x 摆影响，全程净空恒定。

**校验**：`verify_hand.cjs` 新增逐指 2 行（展开副齐套、枢轴位置）+ 全机 0 碰撞（quick 1745 网格 / 8039 姿态 / 0 碰撞 / 最小间隙 1.000mm）、实体干涉 45 项全清、
可拆装互换 **95/95**；`verify_all.cjs --quick` **10/10 PASS**。
