zhaoxiaofeng44/robot_arm/finger_design_spec.md

# 掌 + 三节手指机构（finger_mechanism_3d.html）— 三个肘关节单元的串联设计

> **设计原则：机械结构不变、第三个关节与已有两节用同一套关节方案。** 手指 = 掌（固定基节）+ 三个 v5 可拆肘关节单元串联；每个单元的几何（叉耳/袖套/长条连杆/电机安装/全部紧固件）与已验证的 `arm_mechanism_3d.html` 完全一致，仅按单元实例化（前缀 m0/m1/m2、palm/p1/p2/p3 命名）。**P1 与 P2 段逐件同几何（同长同构）**，连同连杆/抱箍/叉头/紧固件全部通用可互换。

## 构型

```
掌(300, 固定基节) ─[关节0/MCP]─ P1 近节(300) ─[关节1/PIP]─ P2 中节(300) ─[关节2/DIP]─ P3 远节(250+指尖)
电机0·安装板·叉耳      袖套+D侧板 │ 电机1·安装板·叉耳   袖套+D侧板 │ 电机2·安装板·叉耳   袖套+D侧板 │ 指尖圆头
(单元0的上臂)        (单元0的前臂) (单元1的上臂)     (单元1的前臂) (单元2的上臂)      (单元2的前臂)
        └─ 顶端 4×M5 掌骨安装法兰接真实手掌（外圈 Ø5.5 对掌侧）
```

- **掌 + 三节指骨、三个关节、三台电机**：电机k 安装在本单元的**上级段**上并随其运动，推杆经 BD 连杆驱动下一级段绕 Ok 转动——单元0：掌载电机0 驱动 P1（掌指关节 MCP）；单元1：P1 载电机1 驱动 P2（近指关节 PIP）；单元2：P2 载电机2 驱动 P3（远指关节 DIP）。电机安装臂逐级向指尖一侧前移。
- **三个单元逐件同构**：单元1 与单元2 的两段（p1/p2）几何**完全相同**（同长 300、同拼接缝 −170、同远端让位 −300+13），只有命名前缀不同 → 任一打印件可互换；单元0 的上级段就是掌段（另加指根方块 + 掌骨安装法兰）。
- **P1/P2 是拼接关键件**：其近端 = 上一单元的接前臂接口（Ø20×14 袖套 + 毂 + D 侧板叉耳 + Ø8×20 销，含 ±5.5 收窄腰身让开连杆扫掠）；其远端 = 本单元下级关节的接上臂接口（叉耳 + 电机安装板 + 抱箍螺栓孔）。两套接口在同一打印件的两端，互不干扰。**远端躯体止于 −300+13**，避开下一级 Ø20 袖套/毂（v7：否则整块躯体插进轴套 127mm²），关节连接由叉耳承担。
- **P3 远节**：只有被动接口（袖套 + D 侧板），末端为 Ø24 圆柱 + 半球指尖垫；不携带电机。

## 关节衔接（三个关节逐项相同，与肘版一致）

| 接口 | 堆叠 | 浮动 | 紧固 |
|---|---|---|---|
| 关节0/1/2 转动副 | 叉耳5 + **1.0** + 袖套14 + **1.0** + 叉耳5 = 26 | 1.0mm/侧 | 3×Ø10×26 肩螺栓 + 平垫 + M8 自锁螺母 |
| 关节0/1/2 连杆副（B） | 叉耳板4 + **1.0** + 连杆8 + **1.0** + 叉耳板4 = 18 | 1.0mm/侧 | 3×Ø8×18 肩螺栓 + 平垫 + M6 自锁螺母 |
| 关节0/1/2 连杆副（D） | 板4+凸台1+**1.0**+连杆8+**1.0**+凸台1+板4 = 20 | 1.0mm/侧 | 3×Ø8×20 肩螺栓 + 平垫 + M6 自锁螺母 |
| 推杆↔叉头 | M6 螺纹旋入沉龛螺母：螺母坐底板顶面[+2,+7]、四周围壁包住六角面防转（**拉力**由螺纹副+防转传递，**压力**由底板承担） | — | M6 螺母 ×3 |
| 掌部安装 | 指根方块顶面 y=320 ↔ 56×56×6 法兰板：内圈 4×M4 穿板旋入方块 Ø3.4 底孔；外圈 4×Ø5.5 对掌侧 | — | 4×M4×16 + 4×M5×16 |

装配方向全部沿 Z：抽销 → 连杆/指节沿 Z 滑出。三个单元的零件同名同规格（连杆、袖套、叉头、抱箍、紧固件全部通用备件）。

## 电机在各级段上的布局（逐级相同）

关节k 位于本单元上级段局部 y = 0（掌）/ −300（P1）/ −300（P2）；A=(28,213) 相对自身关节、缸体 y[137,217]、前端面 y=137、安装板 [141,149]、后抱箍 [175,217]（耳板螺栓孔位 y=184 / 209 开在本段跟部）。拼接缝：掌段 y=140、P1/P2 段 y=−170、P3 y=−125——P1/P2 的拼接凸台与电机抱箍（局部 −125..−83）之间留 15mm，与近端 D 侧板区（0..−46）相距 94mm。

## 运动学

三个单元各自独立、几何相同：每单元 A=(28,213) 相对自身关节、BD=85、D=(14,−31)、行程 59.393mm、0～120°（机构能力）。总自由度 3（θ0 MCP、θ1 PIP、θ2 DIP），由三台电机独立控制，**运动学零改动**：复用同一套 `angleToStroke/D(θ)/B(θ)` 解算器三次。`getJoints(a0,a1,a2)` 输出三个单元全部关节中心（含世界系复合），闭合误差 < 4.3e-14 mm（`verify_finger.cjs`）。

## 安全行程包络 90°/90°/70°（本轮确定）

三个关节各自可以到 120°，但**同时**大角度卷曲时指尖会卷回掌段躯体（`p3BodyDistal`/`p3FingerTip` 撞 `palmBodyProximal`），这与真实手指无法卷进掌心是同一回事。用 5° 三维网格（0..120° 全组合，15625 姿态）扫出碰撞边界后取安全盒：

| 关节 | 机构能力 | 安全上限 | 依据 |
|---|---|---|---|
| θ0 掌指 MCP | 120° | **90°** | θ1/θ2 达上限时 90° 仍有 ≥5° 余量 |
| θ1 近指 PIP | 120° | **90°** | 受 θ0+θ2 组合限制（θ0=90、θ2=70 时上限≈95°） |
| θ2 远指 DIP | 120° | **70°** | 与人类 DIP 量程一致 |

包络内用 2° 三维网格（76176 姿态）+ 三关节各自 0.05° 细扫复核：**0 碰撞**、非配合面连续下限 **0.738mm**、最小非配合间隙 **1.000mm**。滑杆、预设按钮与演示动画均限制在该包络内。

## 校验（verify_finger.cjs，全绿）

- **闭合**：三个单元 |BD|−85 < 4.3e-14 mm（10 组姿态）。
- **碰撞扫描**：①θ0/θ1/θ2 各自 0.05° 细扫（其余归零）②安全包络内 2° 三维网格（46×46×36 = 76176 姿态）——**0 碰撞**；非配合连续下限 0.738mm（步长允差 0.262mm，按最远点半径 300mm 计算）。
- **配合区**：与肘版相同收紧到孔半径+0.6mm（O0/O1/O2=5.9、B/D=4.9mm）。
- **可拆装性/互换性 54/54**：无铆接、三单元 5 件套紧固件齐套（m0b/m1b/m2b、o0/o1/o2、p1d/p2d/p3d）、沉龛螺母×3、三电机三连杆齐套、掌骨法兰4×M4、轴向浮动 1.0mm/侧、**P1 与 P2 单元逐件同几何（可互换）**、链条父子关系与局部偏置正确。

## 打印件与出档（`node export_finger_stl.cjs` → `stl_finger/`）

**19 个打印件 + 12 项外购标准件**（三单元通用件可互换）：

| 打印件 | 打印姿态 | 尺寸(mm) |
|---|---|---|
| palm_proximal 掌·法兰端段（指根方块+电机0安装板） | 绕X翻转180° | 59×182×37 |
| palm_distal 掌·关节0段（叉耳） | 平躺 | 22×158.2×26 |
| p1_proximal 近节关节0端段（袖套+D侧板） | 绕X翻转180° | 32×188.2×20 |
| p1_distal 近节关节1段（叉耳+电机1安装板） | 平躺 | 58×159×37 |
| p2_proximal 中节关节1端段（袖套+D侧板，与近节同件） | 绕X翻转180° | 32×188.2×20 |
| p2_distal 中节关节2段（叉耳+电机2安装板，与近节同件） | 平躺 | 58×159×37 |
| p3_proximal 远节关节2端段（袖套+D侧板） | 绕X翻转180° | 32×143.2×20 |
| p3_distal 远节指尖段 | 平躺 | 24×153×28 |
| motor0/1/2_collar 抱箍 ×3 | 绕X转90°（孔轴竖直） | 51.2×42.4×42 |
| b_clevis_0/1/2 推杆叉头 ×3 | 平躺 | 18×24.5×18 |
| link_0/1/2 长条连杆 ×3 | 平躺（长轴已摆正） | **15×100×8**（腹板 3×Ø6 减重孔） |
| palm_mount 掌骨安装法兰 | 板面落床（rotX90） | 56×56×6 |
| grip_pad 指尖防滑抓握垫 | 绕X翻转180° | 22×25.5×5.6 |

- 全部与肘版同工艺（孔轴沿 Z、平躺/翻转打印、抱箍孔轴竖直）；STL 已落地 z=0。
- 幅面：最差 palm_proximal / p1_distal / p2_distal 45°斜排 ≤220mm。
- 外购件：Ø10×26 肩螺栓×3、Ø8×18×3、Ø8×20×3、M6 沉龛螺母×3、M8/M6 自锁螺母 3/6、M4×22×6、M4×16×16、M4×36×6、M5×16×4。

## v6 手指完善

- **掌部安装法兰**（`palm_mount` 独立打印件）：56×56×6 R8 圆角方板，**板底坐在指根方块顶面 y=320（零间隙）**；内圈 4×M4×16 穿板旋入方块 Ø3.4 底孔，外圈 4×Ø5.5 与手掌球窝对接，Ø9 中心孔走线——手指与手掌的连接从方块假想件变为真实可装接口。
- **指尖防滑抓握垫**（`grip_pad` 独立打印件）：远节掌侧 22×18 垫板 + 3 条横向防滑棱，可换 TPU95A 柔性版。
- **BD 连杆减重**：连杆腹板各开 3×Ø6 减重通孔（孔边距端孔壁 4.9mm、距杆侧 4.5mm），等宽长条外形与配合尺寸零变化。

## v7 连接物理性修正

用独立审计脚本 `verify_connections.cjs` 逐件复核图上是否真的有连接，修正 5 类**物理上不成立**的连接（此前碰撞/打印校验收不到）：

| # | 症状（修正前） | 修正 |
|---|---|---|
| 1 | 电机前法兰与安装板**悬空 2mm**、螺钉头也夹空 2mm | 法兰移到 y[137,141]、安装板移到 y[141,149] → **面接触**；螺钉头顶住法兰底面 |
| 2 | 抱箍只有 **+z 单侧**耳板，M4×22 光杆 22 vs 实际夹持 18 → 另一侧螺母悬空锁不住 | 每根螺栓补 **−z 镜像耳板**（z=±7..11），夹持=4+14+4=22 = 光杆长 |
| 3 | 拼接 M4 螺栓**穿过臂身实体**（本体没开孔） | 各段本体在拼接处开 2×Ø4.4 通孔 |
| 4 | 沉龛里 M6 螺母**陷进底板 2mm**；龛内档比螺母对角 11.55 还小 | 螺母坐底板顶面；龛内档改 X±5.4 / Z±6.2、围壁完整包住六角面防转 |
| 5 | `palm_mount` 悬空 5mm，4×M5 全部落在指根方块轮廓之外 → 掌侧连接不存在 | 法兰板落到方块顶面；方块开 4×Ø3.4 底孔，加 4×M4×16 真正把法兰拧在掌段上；M5 改为沿 Y 的掌侧接口 |

## v8 第三关节（掌指关节）扩展（本轮）

按**与现有两节完全相同的关节方案**把关节数从 2 增到 3，插入点在最根部（掌 ↔ 近节）：

| 项 | 改动前 | 改动后 |
|---|---|---|
| 链条 | 掌件(P1 兼基节) ─O1─ P2 ─O2─ P3 | **掌(固定,载电机0) ─O0─ P1(载电机1) ─O1─ P2(载电机2) ─O2─ P3** |
| 单元 | 2 个（几何同构） | **3 个（几何同构）**，P1 与 P2 逐件同几何 |
| 原 P1 | 基节：近端被驱动接口(袖套+毂+D侧板) + 本体 + 指根方块 + 掌骨法兰 + 电机1 + O1 叉耳 | 改名**掌段**（前缀 palm/m0/t0，肩螺栓改 o0）：本体/方块/法兰/电机/叉耳**逐件原样**；仅**去掉近端被驱动接口**（掌是固定根，不绕任何轴转，该接口由 P1 自己承担） |
| 原 P2 | 单元1 的被驱动段 | 改名 **P1 近节**（原样保留，前缀 p1/m1/t1，肩螺栓 o1） |
| P2 中节 | — | **新增**：与原 P2 逐件同几何（前缀 p2/m2/t2，肩螺栓 o2） |
| 运动学 | getJoints(a1,a2)、2 个旋转组 | `getJoints(a0,a1,a2)`、3 个旋转组（p1Group 绕 O0、p2Group 绕 O1、p3Group 绕 O2，逐级复合到世界系） |
| UI | 2 个滑杆 | **3 个滑杆**（θ0 MCP / θ1 PIP / θ2 DIP）+ 预设 0/0/0、45/45/35、90/90/70 + 三关节同比联动演示 |
| 臂展 | 掌→指尖 864mm | 掌→指尖 **1164mm**（多一节 300mm 指节；掌段长度由电机+连杆布局决定，与单元同长）|

实现方式：把被驱动段抽成 `buildDrivenPhalanx(parent,pfx,segLen,mPfx,tPfx)`（近端袖套+D侧板、远端叉耳+安装板+电机+连杆+肩螺栓），P1/P2 各调一次；固定基节（掌）沿用原 P1 代码。三段各自的电机/连杆/肩螺栓命名与所在段绑定，因此每段的运动学完全独立——**关节方式与现有两节逐项相同**。

## 打印/拆装综合校验（`verify_finger_print.cjs`，**148/148 通过**）

- **幅面与姿态**：19 件全部落地、45°斜排 ≤220mm。
- **关键孔（三个单元各一套）**：关节0/1/2 叉耳 Ø10.6 通孔+孔径实测+壁厚；三轴套 Ø10.6 通孔+孔径+45°倒角+壁厚；D0/D1/D2 凸台、B0/B1/B2 叉耳板 Ø8.6 通孔+壁厚；连杆两端孔通孔+45°倒角+壁厚。
- **等宽长条**：t0/t1/t2 杆身=端环=15.00mm。
- **可互换性**：p1≡p2、t1≡t2、m1≡m2 的段体/轴套/叉耳/安装板/连杆/抱箍/侧板几何签名一致；palm 叉耳 ≡ p1 叉耳（原基节几何未变）。
- **拆装通道**：0°/45°/90° × 三单元共 27 项螺母侧工具通道全部畅通；三电机轴向抽出通道 Ø31 畅通。
- **无永久连接**：294 个实体网格中无铆接/胶接；三单元紧固件（含沉龛螺母）齐套。
- 装配顺序：掌段 + P1 拼接 → 装电机0 → 关节0 装配（P1 袖套入掌叉耳 + 连杆0 + 三销）→ P1 上装电机1 → 关节1 同法 → P2 上装电机2 → 关节2 同法 → 指尖。
- 选型：与肘版相同，需缸体 ≤80mm、行程 ≥60mm 的紧凑直线执行器 ×3。

## 预览图（preview/，`node render_finger_preview.cjs`）
## 预览图（preview/，`node render_finger_preview.cjs` 生成）

卷曲演示姿态 θ0/θ1/θ2 = 75°/75°/55°（安全包络内）。

| 文件 | 视角 | 说明 |
|---|---|---|
| finger_01_iso_curl.png | 等轴（右前上） | 卷曲态全貌 |
| finger_02_main_curl.png | 沿Z（销孔轴正对） | 卷曲形态主视图，看双剪耳片/铰链 |
| finger_03_iso2_curl.png | 等轴（左前上） | 另一侧全貌 |
| finger_04_joint0_mcp.png | 特写 | 关节0(MCP)：掌段叉耳 + P1 袖套 + 连杆0 |
| finger_05_joint1_pip.png | 特写 | 关节1(PIP)：P1 叉耳 + P2 袖套 |
| finger_06_joint2_tip.png | 特写 | 关节2(DIP)：P2 叉耳 + P3 袖套 + 指尖 |
| finger_07_link.png | 特写 | BD 等宽长条连杆 + B 叉头 + D 侧板 |
| finger_08_motor0_mount.png | 特写 | 电机0 安装（掌段）：法兰安装板 + 300° 开口抱箍 |
| finger_09_motor1_mount.png | 特写 | 电机1 安装（P1 段，随 P1 旋转） |
| finger_10_palm_mount.png | 特写 | 掌骨安装法兰：板面贴合/内圈4×M4/外圈4×Ø5.5/Ø9走线孔 |
| finger_11_grip_tip.png | 特写 | 指尖防滑抓握垫与 3 条防滑棱 |
| finger_12_straight_iso.png | 等轴 | 伸直态 θ0=θ1=θ2=0（掌至指尖 1164mm） |
| finger_13_envelope_iso.png | 等轴 | 安全包络极限 90°/90°/70° |
