zhaoxiaofeng44/robot_arm/arm_design_spec.md

# 手臂机构：可拆肩螺栓关节与等宽长条连杆（v5 可拆化重构版）

> **本轮（v5）主题：关键连接可拆解、逻辑成组件。** v4 的三处"单件肩铆钉"是永久连接（现场镦尾，不可拆）；v5 全部更换为**外购可拆肩螺栓（塞打螺丝）+ 平垫 + 尼龙自锁螺母**，并重构了三处关节与电机安装的几何，使每个组件可以**只用内六角扳手**反复装拆：
> - **BD 连杆 → 100×15×8mm 等宽长条**（v4 为 8×8 杆身 + Ø17 环眼的狗骨形），平躺打印，无环眼凸台；
> - **B 叉头**改为独立开放双耳 + 螺母沉龛夹持桥：电机推杆端部 M6 螺纹旋入沉龛内的 M6 螺母即完成叉头-推杆连接，B 销轴抽出后连杆**沿 Z 落入/滑出**；
> - **D 叉耳**改为贴在前臂侧面的双侧板（位于连杆 z 带 |z|≤4 之外），取消 v4 跨越连杆的桥板（v4 中桥板与连杆眼实体干涉）；
> - **电机**改为前法兰承推（安装板与上臂一体）+ 后部 300° 开口抱箍（独立件，2×M4 锁臂侧）：卸 4×M4 即可向上抽出电机；
> - **电机缸体 90 → 80mm**：v4 中屈臂 120° 时 B 点距电机前端面仅 10.77mm，任何"先避让连杆端部（R7.5）再连接推杆"的叉头都必然伸入电机内部——即 v4 的叉头桥只能长在连杆扫掠圆内（实体干涉的根因）。缩短缸体后该距离变为 24.77mm，叉头获得完整装拆空间。**行程（59.393mm）、A 点、BD=85、D(θ)、力曲线全部不变。**
>
> 自动校验：`verify_near_joint.cjs`（0.05° 步进 2401 姿态，0 碰撞，非配合连续下限 **0.59mm**，配合区半径收紧至孔半径+0.6mm）、`verify_serviceability.cjs`（**50/50**，工具通道/抽销通道/轴向浮动/等宽长条/无永久连接）、`verify_print_geometry.cjs`（**28/28**）、`check_stl.cjs`（0 问题文件）。

保持仿生映射和单自由度构型：上臂固定、前臂绕 O 轴转动 0～120°、直线电机平行上臂且回缩屈臂、仅一根 BD 刚性连杆传力。运动学零改动。

**结果：Ø36×80mm 圆柱电机，前端面 y=137mm（后端面越过行程基准 A 点 4mm），A=(28,213,0)mm，A–O=214.83mm；BD=85mm，D=(14,-31,0)mm；工作行程 59.393mm。0～120° 全行程名义包络无碰撞。最小传动角 30.19°，5kg 理想静态峰值拉力约 618N。推杆外露长度 24.77～84.16mm。**

## 结构方案

### O 肘关节（组件：上臂叉耳 / 前臂轴套 / Ø10×26 肩螺栓副）

- 上臂端**一体化叉耳**（耳座+叉桥+Ø20 凸台与臂身一体打印）不变，耳内档 16mm。
- 前臂根部**肘轴套** Ø20/Ø10.6×14mm（v4 为 Ø22×15）：Ø20 使等宽长条连杆在伸直位（θ=0）距轴套回转圆仍有 **1.4mm**（v4 的窄杆身 + Ø22 只有 0.9mm 裕度）；轴套内加 **Ø19 内毂**（与臂身熔合），轴套磨损后可整体沿 Z 抽出更换。
- 前臂顶端绕 O 开 **R5.4 半圆缺口**：Ø10 销轴直接贴臂身穿过，消除 v4 中销轴嵌入臂身端部 5mm 的隐性干涉。
- 紧固：**Ø10 h9×26 肩螺栓**（光杆穿满耳-浮动-轴套-浮动-耳 = 26mm），螺母侧平垫 + **M8 尼龙自锁螺母**。轴向每侧浮动 **1.0mm**（v4 为 0.5）。

### B 电机端关节（组件：rodClevis 独立打印件 / 长条连杆 B 端 / Ø8×18 肩螺栓副 / M6 沉龛螺母）

- 叉头为独立打印件：两块耳板（z=±5..9，完全在连杆 z 带之外）+ 夹持桥（B 点上方 y=9..16，距连杆端部 R7.5 扫掠圆 **≥1.5mm**）。v4 的桥板位于连杆眼内部，属实体干涉。
- **推杆连接**：电机推杆端部 M6 螺纹（外露段末 12mm）+ 沉龛内 **M6 六角螺母**（对边 10 / 对角 11.55；龛内档 10.8×12.4、围壁完整包住螺母六角面防转；螺母坐底板顶面 B+11..B+16，底板带 2 道加劲肋）。屈指（受拉）时靠**螺纹副 + 螺母防转**把拉力传给叉头，伸指（受压）时螺母底面直接压底板；拆时旋退螺母整体取下。
- 连杆 B 端沿 Z 落入两耳之间（耳内档 10，浮动 1.0mm/侧），**Ø8 h9×18 肩螺栓** + 平垫 + M6 自锁螺母锁紧。
- 桥顶 10mm 平面为打印桥接（切片器默认可桥），无需支撑。

### D 前臂端关节（组件：前臂上段（含双侧板叉耳一体打印）/ 长条连杆 D 端 / Ø8×20 肩螺栓副）

- 双侧板（z=±6..10，18×10mm）贴臂身侧面熔合，**完全在连杆 z 带之外**——连杆可在两板之间全行程扫掠零干涉；内侧各一只 **1mm 定位凸台**（Ø16）设定轴向浮动。
- 光杆堆叠 = 板4+凸台1+浮动1+连杆8+浮动1+凸台1+板4 = **20mm** → **Ø8 h9×20 肩螺栓**（B/D 光杆仅差 2mm，头部/螺母/垫圈通用）。
- 前臂杆身在该区收窄至 **±5.5mm**（y=0..−46），使连杆端部 R7.5 扫掠圆与臂身保持 **1.0mm**；跟部恢复 ±7 至拼接线。

### BD 机械连杆（组件：linkBD 单一打印件）

- **100×15×8mm 等宽长条**：中心距 85mm + 两端 R7.5 圆弧端；端部为 Ø15 环（外径=杆宽，轮廓无凸台），Ø8.6 通孔带 45°×1.0 导入倒角，孔壁 3.2mm。
- 平躺打印、100% 填充；拉伸 618N 应力约 5.2MPa，压缩屈曲安全系数 ≈2.5（PETG）。
- 等宽性由 `verify_serviceability.cjs` / `verify_print_geometry.cjs` 实测断言（杆身=端环=15.00mm）。

### 贴臂圆柱直线电机（组件：电机本体 / motorCollar 后抱箍 / 上臂近端段含安装板 / 4×M4 + 2×M4）

- **前法兰承推**：电机前端 Ø38 法兰占 y[137,141]，其顶面与**与上臂近端段一体**的安装板底面 y=141 **面接触**；4×M4 自下向上旋入（建议热熔黄铜螺母）。注意模型取值：法兰中心=y_flange+2、安装板中心=(y0+T/2)，这样法兰 137..141 / 板 141..149 / 螺钉头 133..137 三者才真正贴合。安装板含 Ø36.4 导向孔；宽板 x=9..47 避开拼接凸台（x=±8），颈部 z=±7 贴臂身。
- **后部开口抱箍**（独立打印件）：300° 包角、60° 开口朝臂侧、内径 Ø36.4（夹持间隙 0.2mm）、y=175..217，**±z 双侧耳板各 2 片（z=±7..11）**，2×M4×22 贯穿上臂侧面（y=184/209，避开拼接凸台 y≤170）：夹持 = 耳板4 + 臂身14 + 耳板4 = 22 = 光杆长，两侧都夹实。缸体**轴向装入**，不靠开口弹性撑开。
- 拆电机：卸 4×M4 → 上抽缸体穿过抱箍 → （可选）卸抱箍 2×M4。全过程不动臂身。
- 缸体缩短至 80mm 的代价：选型时须确认所购直线执行器**缸体长度 ≤80mm 且行程 ≥60mm**（紧凑型推杆电机常见规格）。

### 拼接（沿用 v4；v7 修正）

上臂 y=140、前臂 y=−125 处两段打印；搭接凸台长在臂身上，2×M4 竖向贯穿（孔轴沿 Z），自锁螺母紧固——v5 将 v4 的普通螺母统一为尼龙自锁螺母（防松且可拆）。**v7 修正：臂身本体补开 2×Ø4.4 通孔**（原来螺栓在 z=±7..15 处穿过实体，实物装不进去）；孔位由 ±5.0 收到 **±4.5**，使 Ø4.4 孔完整落在 ±7 半宽内（5.0 时孔壁切到侧边、三角化会吃掉半个孔）。

## 可拆装性（assembly 逻辑）

所有关节孔轴均沿 Z，因此**一套内六角扳手完成整机拆解**：
1. O/B/D 旋下自锁螺母 → 抽出肩螺栓；
2. BD 连杆沿 Z 从 B/D 双耳间滑出；前臂轴套沿 Z 从 O 叉内滑出；
3. B 叉头旋退沉龛内 M6 螺母后与推杆分离；
4. 电机：卸 4×M4 法兰螺栓上抽缸体；抱箍 2×M4 独立可拆；
5. 拼接凸台 6×M4 分段拆解臂身。

每个组件（叉耳、轴套、连杆、叉头、抱箍、两段臂身×4）均可独立更换。自动校验见 `verify_serviceability.cjs`（50/50）：三关节在 0°/60°/120° 三姿态下螺母扳手通道（Ø14–17）、抽销通道（Ø7.2–9.2）、电机抽出通道（Ø31）与法兰螺栓通道全部畅通。

## 载荷与校核边界

- 5kg @ 250mm 理想静态峰值连杆拉力 618N（未计自重/摩擦/冲击/效率）。
- 连杆拉应力 5.2MPa、销轴双剪 ≤12.4MPa、叉头螺母承推底板（带肋）弯曲应力约 30MPa——概念设计量级，实物需按工况重校。
- 未建真实螺纹、止推游隙与载荷变形；全配对名义包络核验不等于制造或承载认证。
