zhaoxiaofeng44/robot_arm/preview/browser_screenshot.png

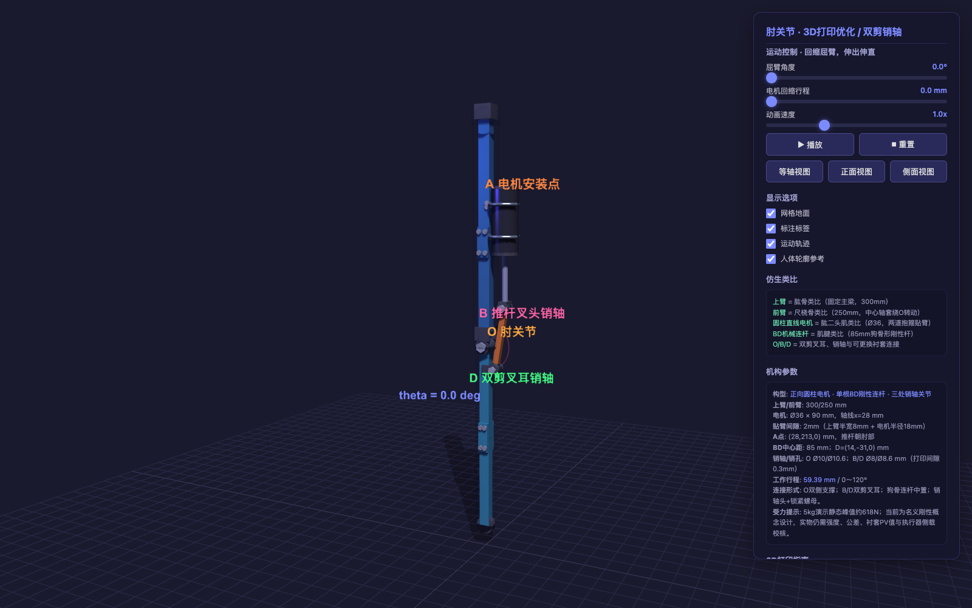
preview/browser_screenshot.png
