zhaoxiaofeng44/robot_arm/preview/finger_01_iso_curl.png

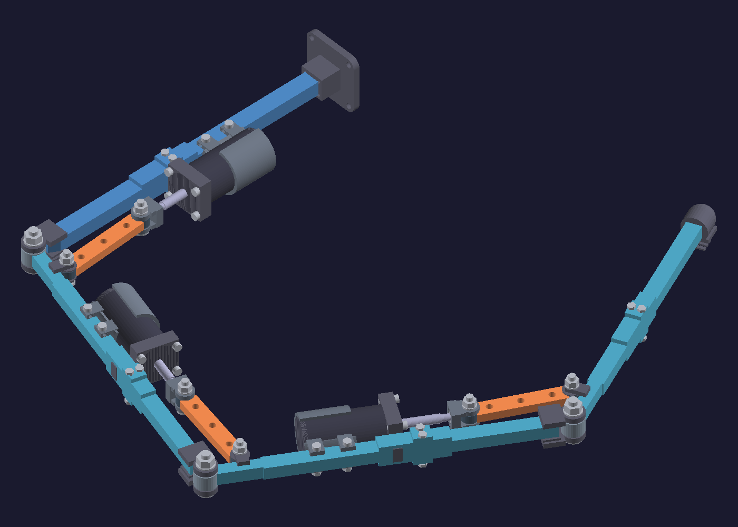
preview/finger_01_iso_curl.png
