zhaoxiaofeng44/robot_arm/preview/finger_02_main_curl.png

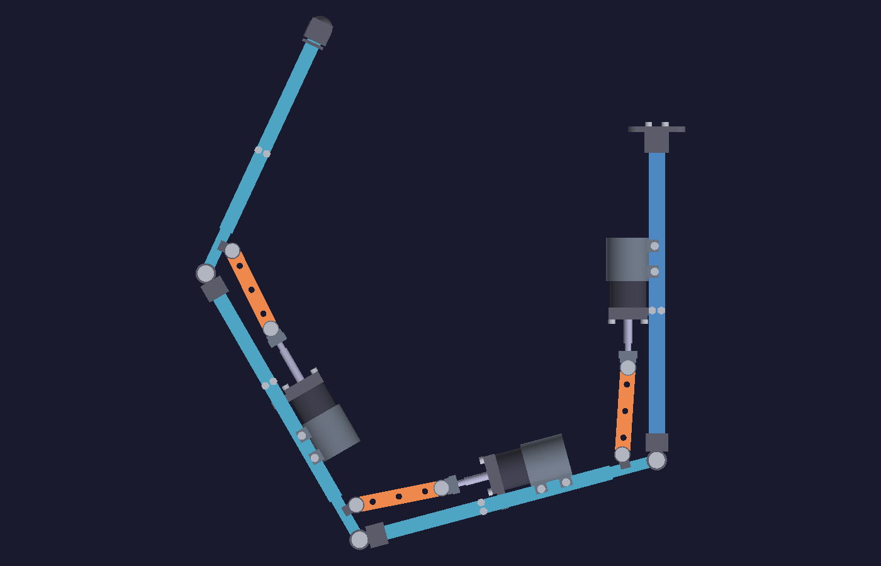
preview/finger_02_main_curl.png
