zhaoxiaofeng44/robot_arm/preview/finger_03_iso2_curl.png

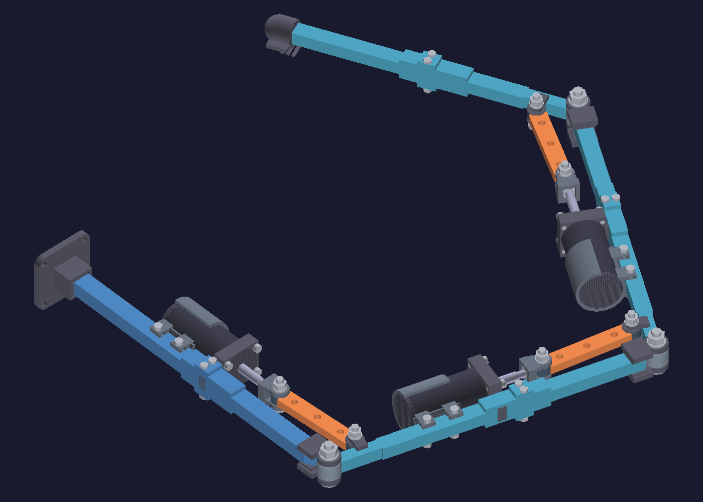
preview/finger_03_iso2_curl.png
