zhaoxiaofeng44/robot_arm/preview/finger_04_joint0_mcp.png

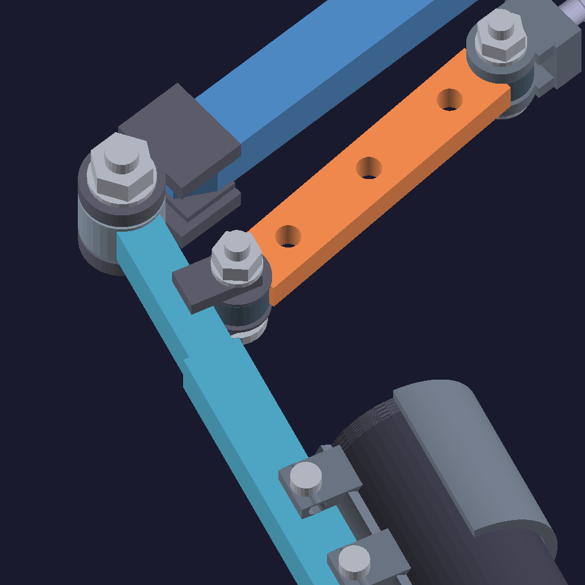
preview/finger_04_joint0_mcp.png
