zhaoxiaofeng44/robot_arm/preview/finger_04_joint1.png

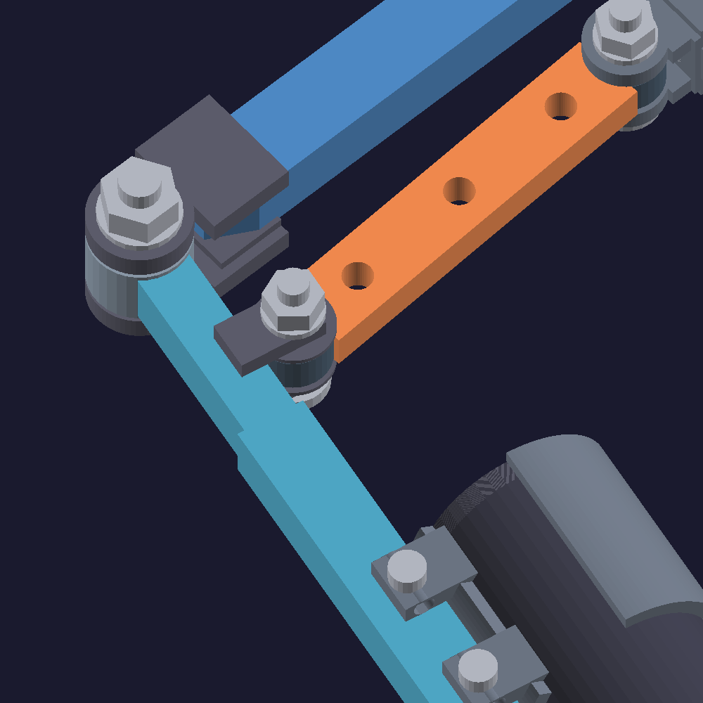
preview/finger_04_joint1.png
