zhaoxiaofeng44/robot_arm/preview/finger_05_joint1_pip.png

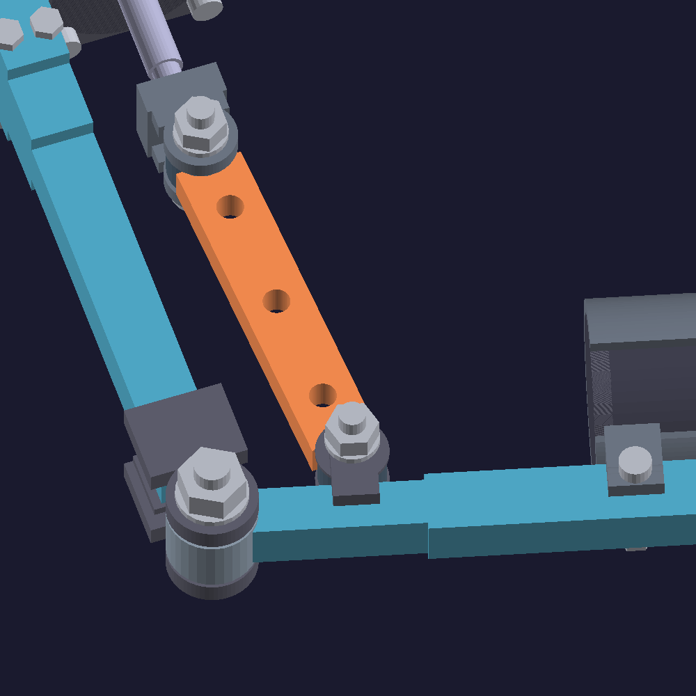
preview/finger_05_joint1_pip.png
