zhaoxiaofeng44/robot_arm/preview/finger_05_joint2_tip.png

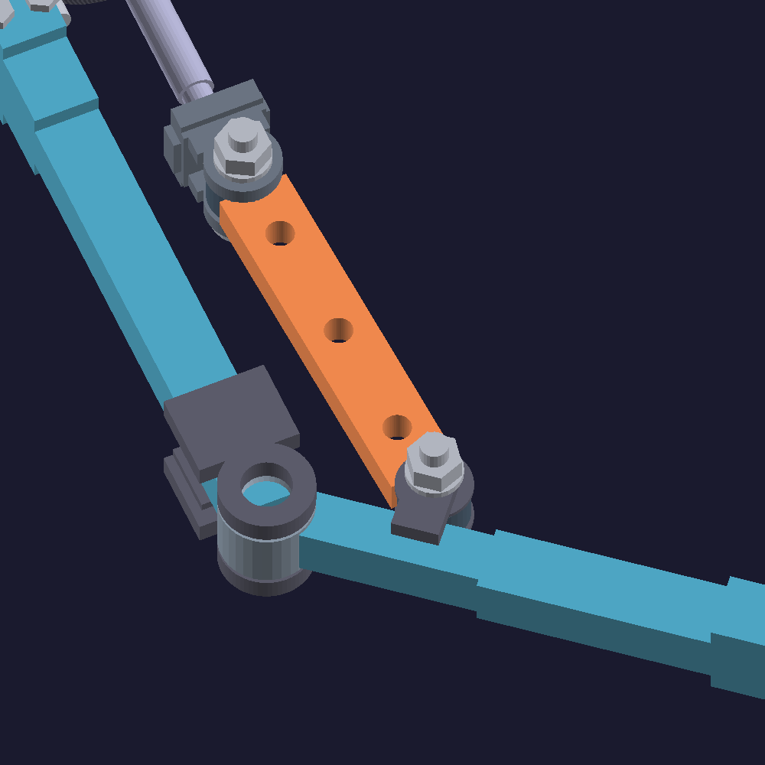
preview/finger_05_joint2_tip.png
