zhaoxiaofeng44/robot_arm/preview/finger_06_joint2_tip.png

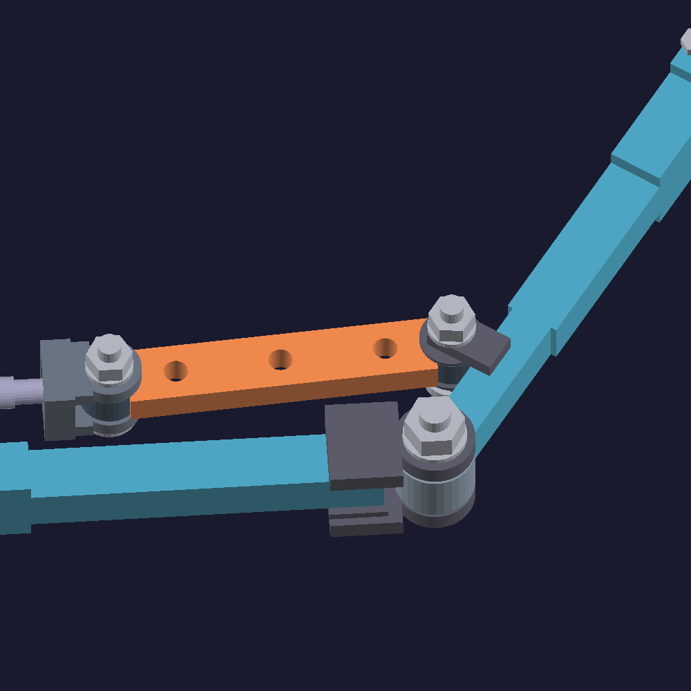
preview/finger_06_joint2_tip.png
