zhaoxiaofeng44/robot_arm/preview/finger_06_link.png

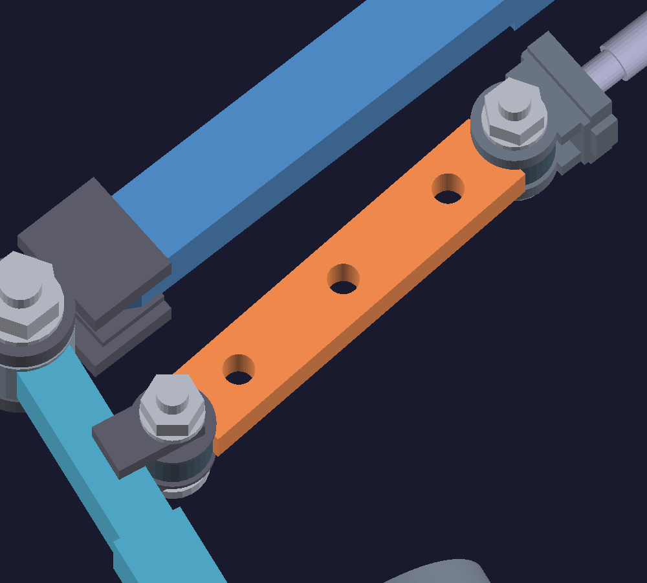
preview/finger_06_link.png
