zhaoxiaofeng44/robot_arm/preview/finger_07_motor_mount.png

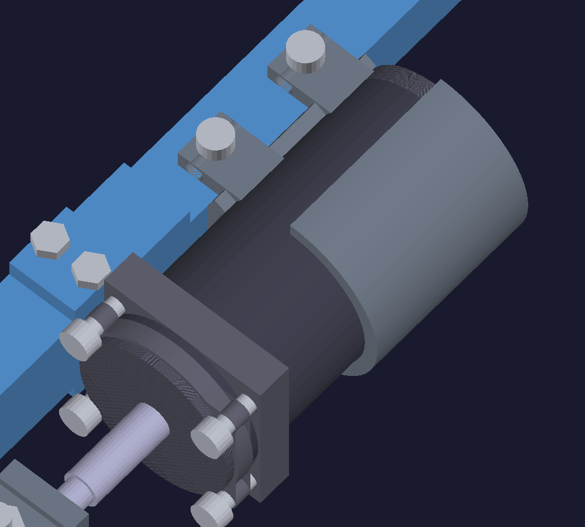
preview/finger_07_motor_mount.png
