zhaoxiaofeng44/robot_arm/preview/finger_08_motor2_mount.png

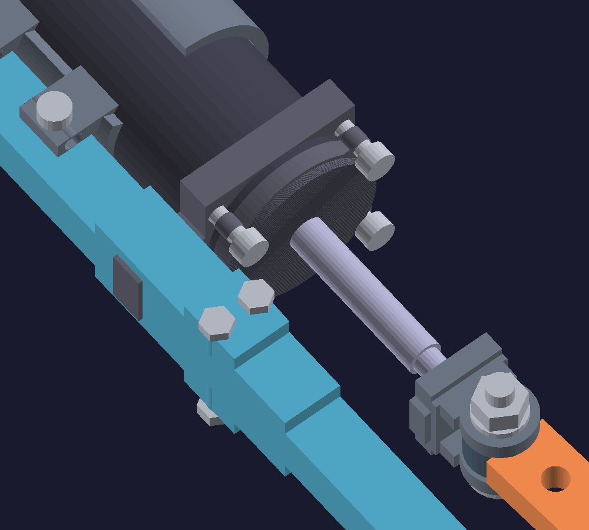
preview/finger_08_motor2_mount.png
