zhaoxiaofeng44/robot_arm/preview/finger_09_motor1_mount.png

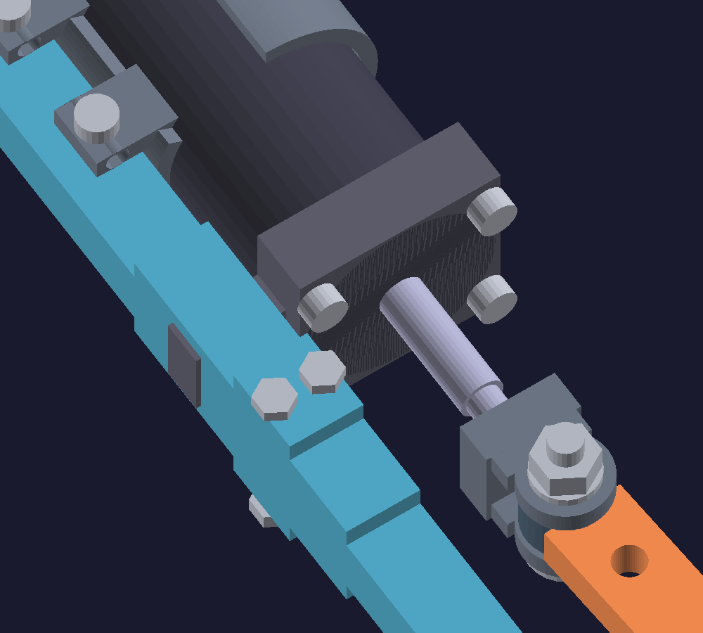
preview/finger_09_motor1_mount.png
