zhaoxiaofeng44/robot_arm/preview/finger_09_straight_iso.png

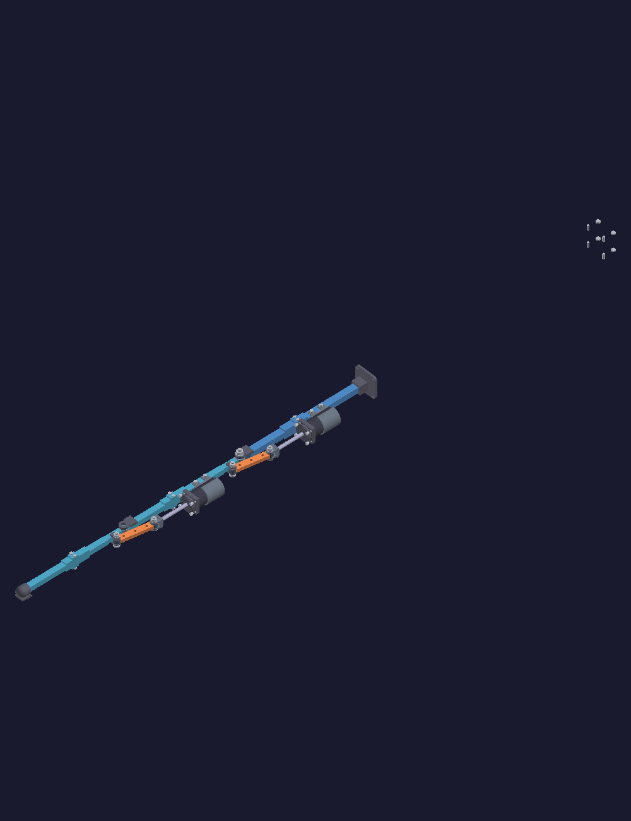
preview/finger_09_straight_iso.png
