zhaoxiaofeng44/robot_arm/preview/finger_10_fullflex_iso.png

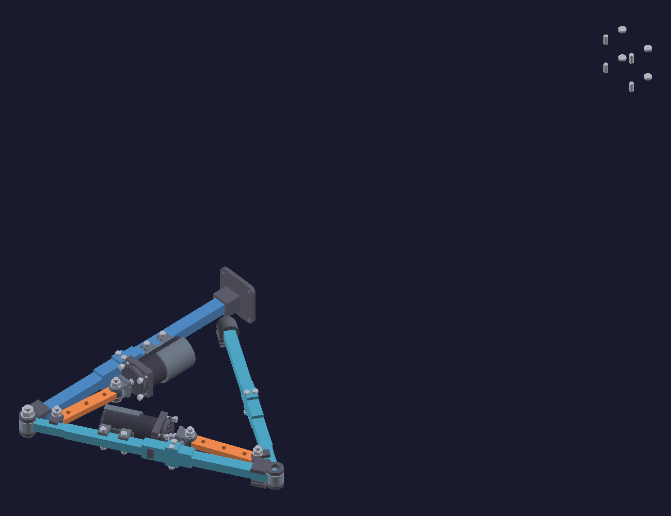
preview/finger_10_fullflex_iso.png
