zhaoxiaofeng44/robot_arm/preview/finger_10_palm_mount.png

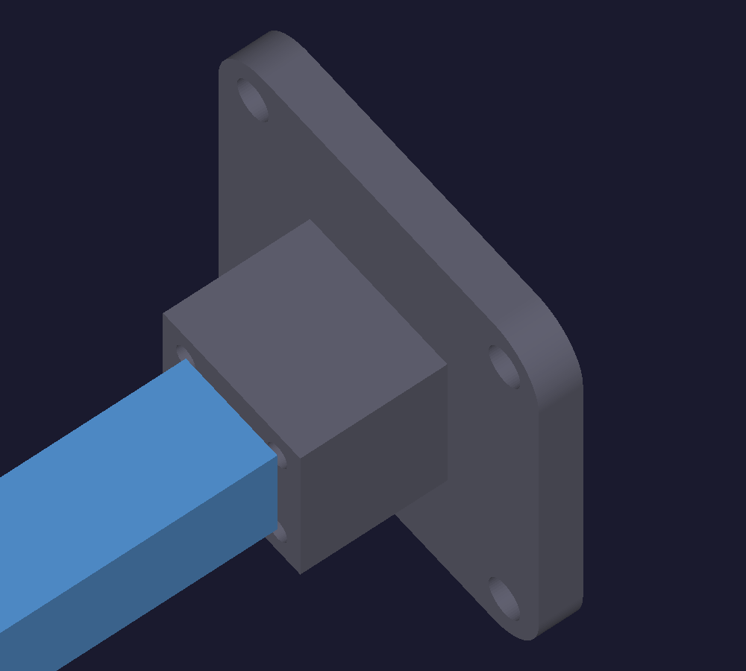
preview/finger_10_palm_mount.png
