zhaoxiaofeng44/robot_arm/preview/finger_11_grip_tip.png

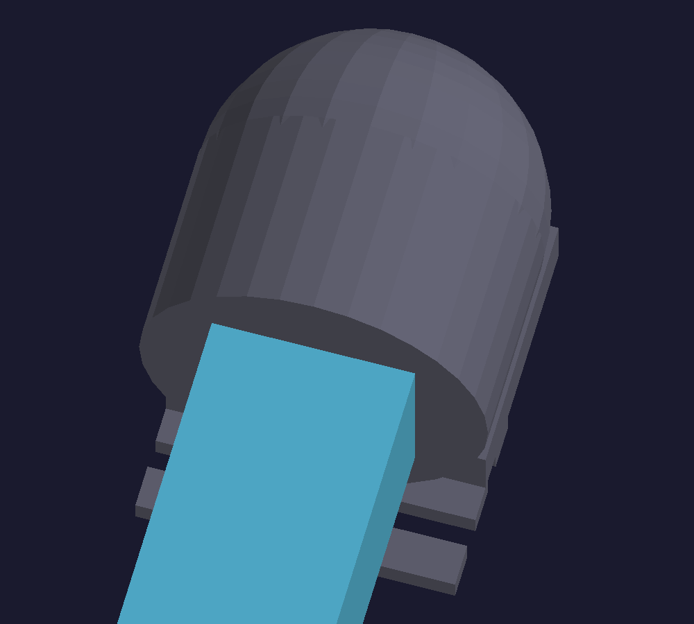
preview/finger_11_grip_tip.png
