zhaoxiaofeng44/robot_arm/preview/finger_12_grip_tip.png

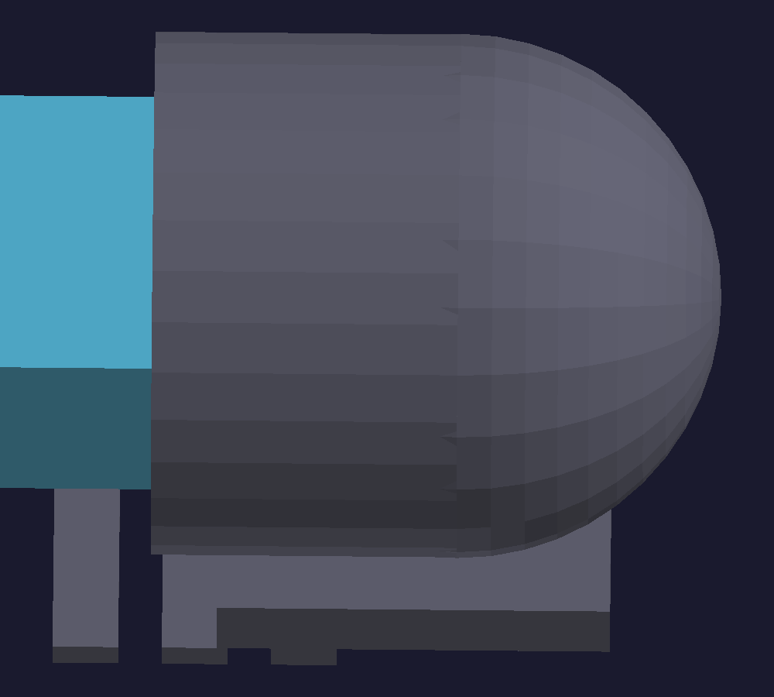
preview/finger_12_grip_tip.png
