zhaoxiaofeng44/robot_arm/preview/finger_12_straight_iso.png

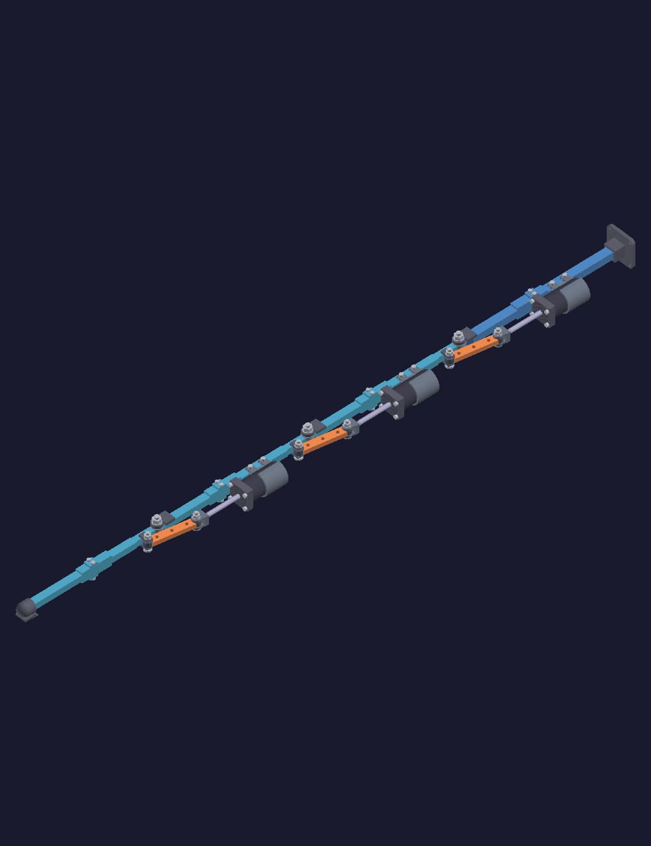
preview/finger_12_straight_iso.png
