zhaoxiaofeng44/robot_arm/preview/finger_13_envelope_iso.png

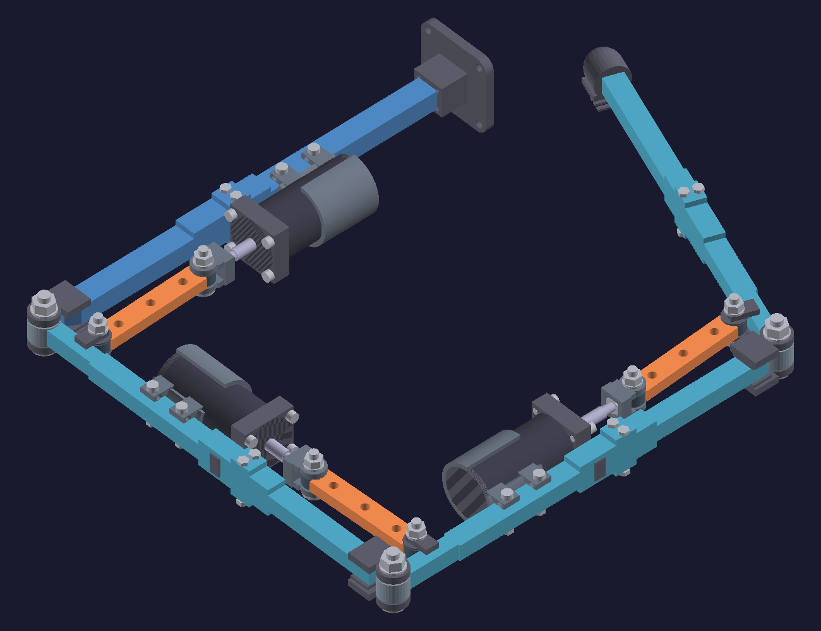
preview/finger_13_envelope_iso.png
