zhaoxiaofeng44/robot_arm/preview/FINGER_FINAL_RENDER_SHEET.png

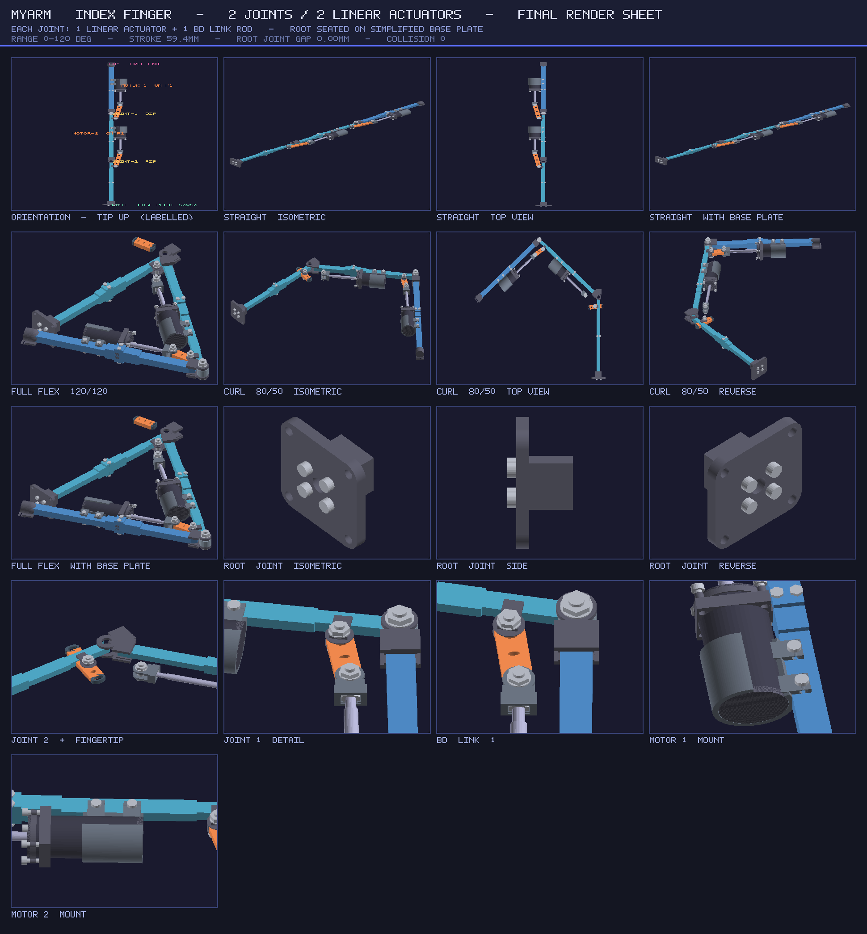
preview/FINGER_FINAL_RENDER_SHEET.png
