zhaoxiaofeng44/robot_arm/preview/finger_front.png

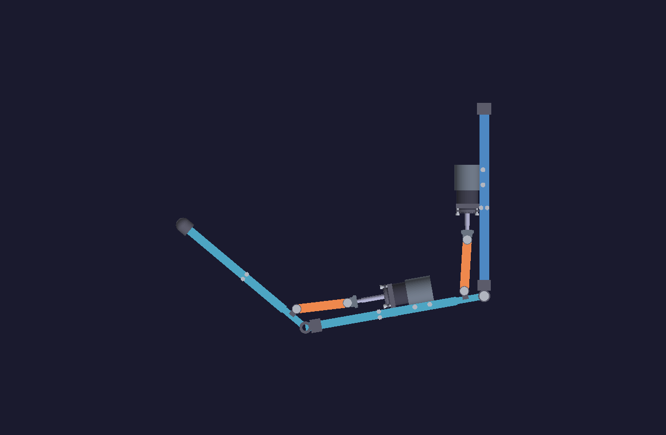
preview/finger_front.png
