zhaoxiaofeng44/robot_arm/preview/finger_iso.png

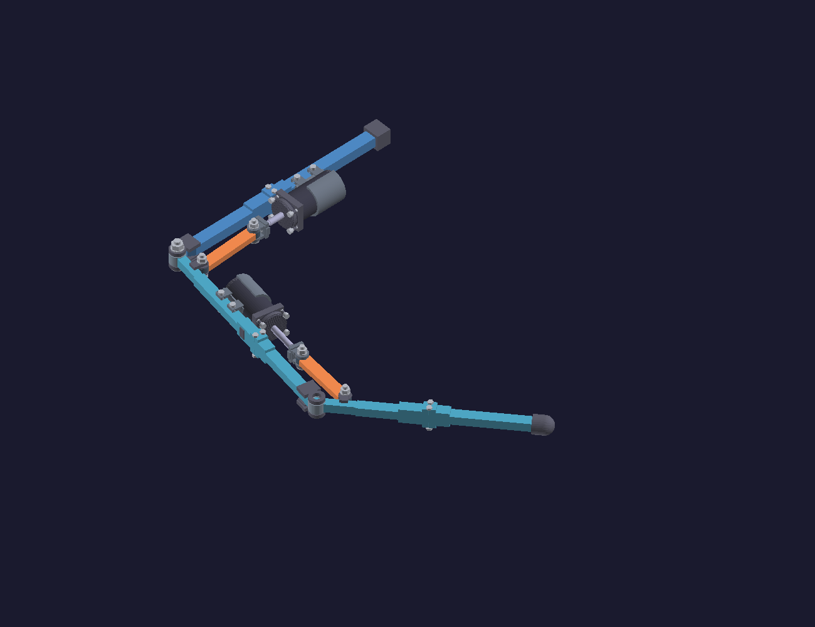
preview/finger_iso.png
