zhaoxiaofeng44/robot_arm/preview/finger_joint1.png

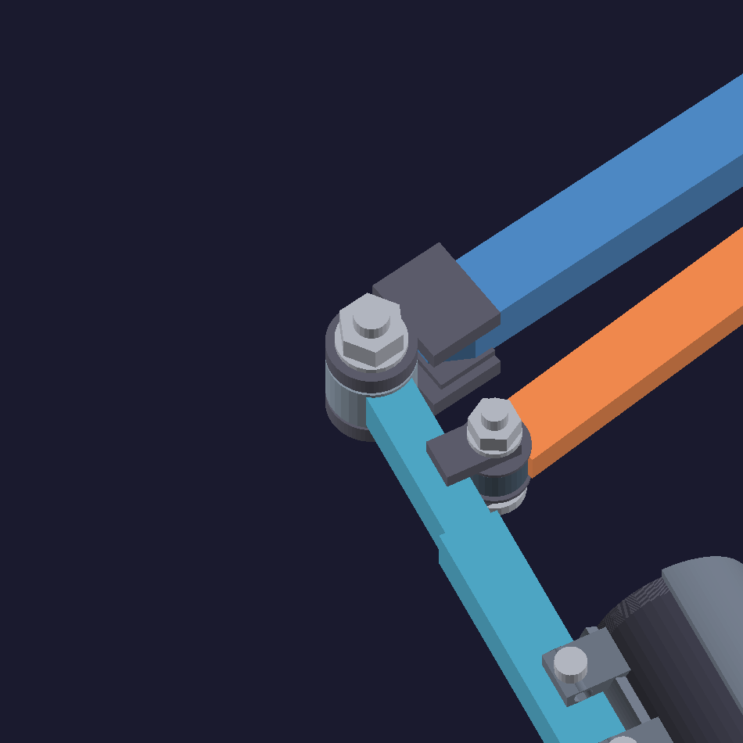
preview/finger_joint1.png
