zhaoxiaofeng44/robot_arm/preview/finger_joint2_tip.png

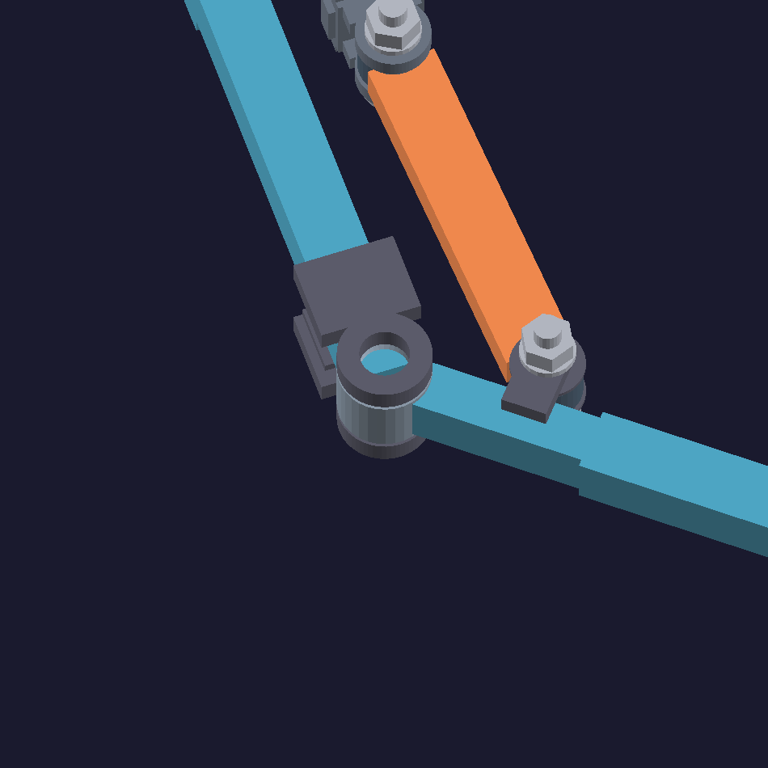
preview/finger_joint2_tip.png
