zhaoxiaofeng44/robot_arm/preview/finger_side.png

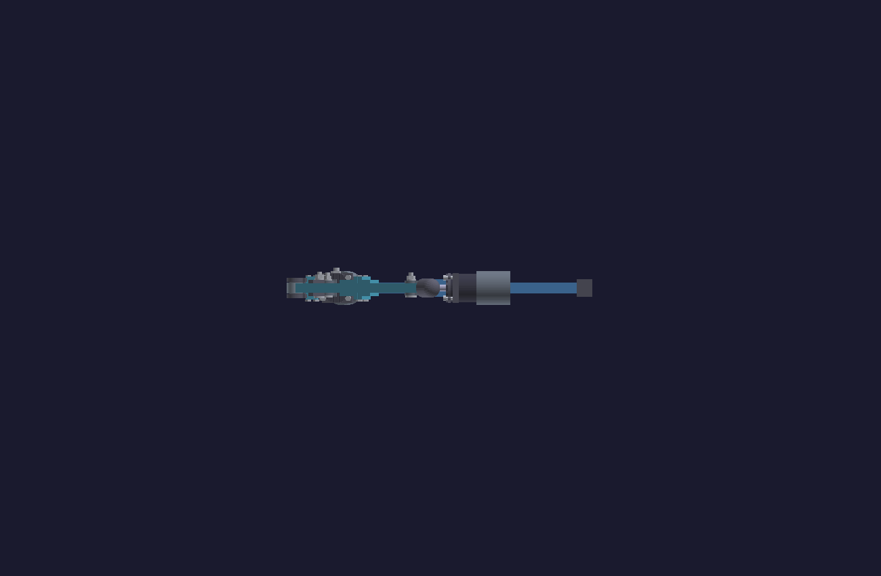
preview/finger_side.png
