zhaoxiaofeng44/robot_arm/preview/finger_top.png

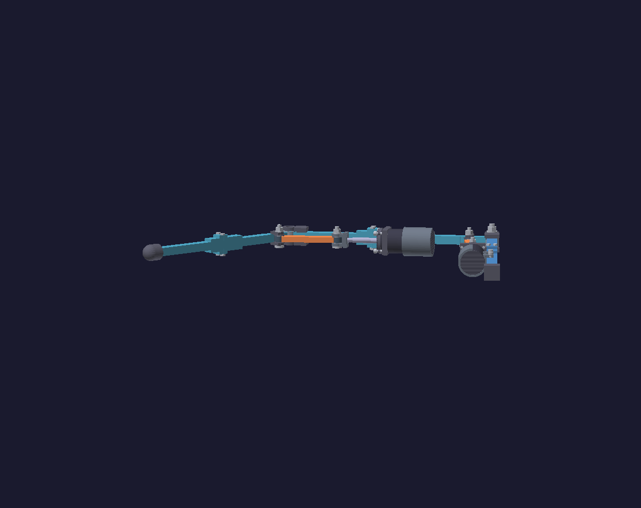
preview/finger_top.png
