zhaoxiaofeng44/robot_arm/preview/hand_00_orientation.png

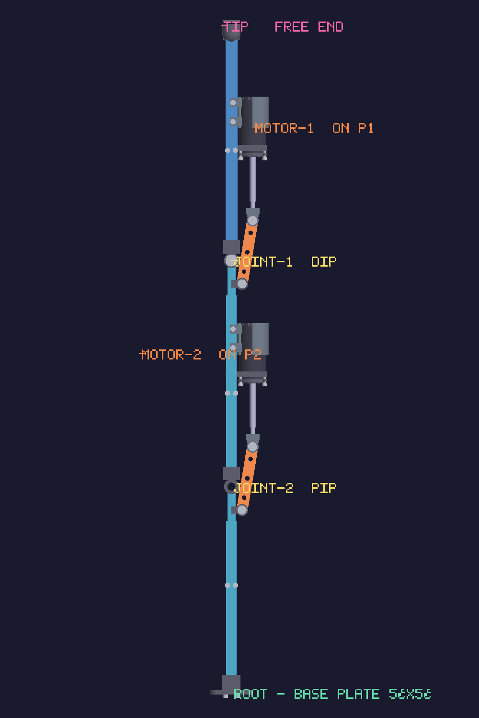
preview/hand_00_orientation.png
