zhaoxiaofeng44/robot_arm/preview/hand_01_iso_open.png

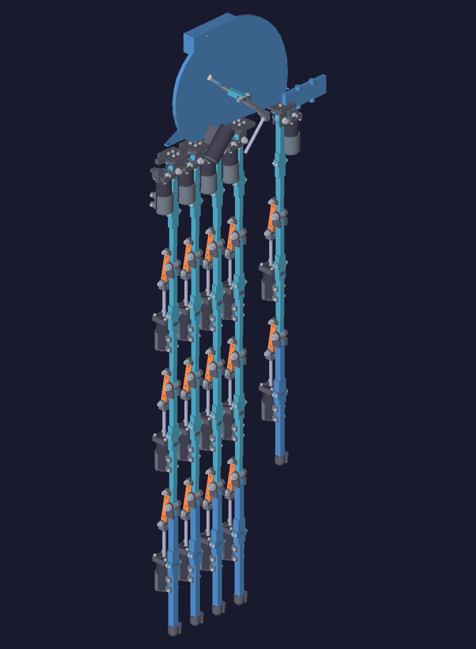
preview/hand_01_iso_open.png
