zhaoxiaofeng44/robot_arm/preview/hand_03_mechanism_plane.png

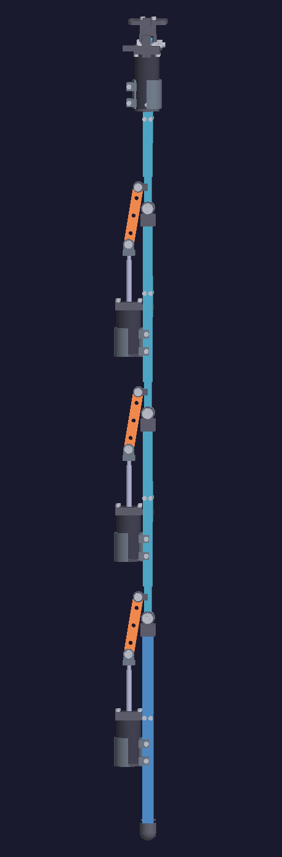
preview/hand_03_mechanism_plane.png
