zhaoxiaofeng44/robot_arm/preview/hand_03_side_planes.png

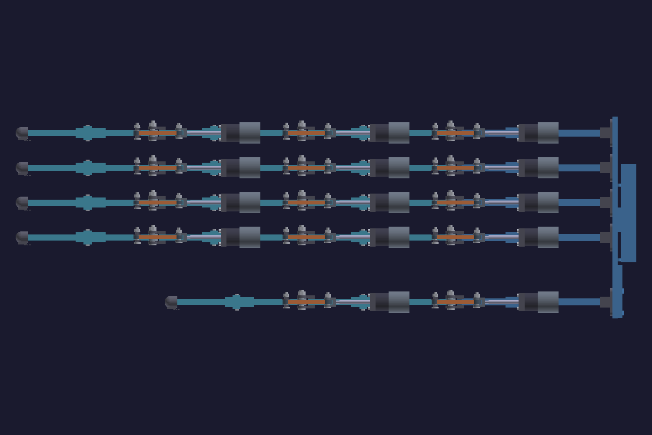
preview/hand_03_side_planes.png
