zhaoxiaofeng44/robot_arm/preview/hand_04_iso_grip.png

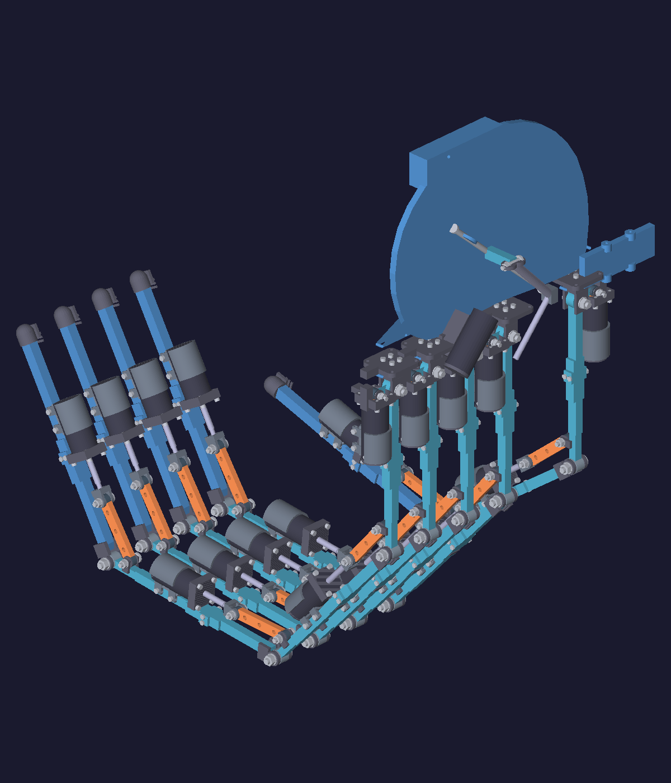
preview/hand_04_iso_grip.png
