zhaoxiaofeng44/robot_arm/preview/hand_04_root_iso.png

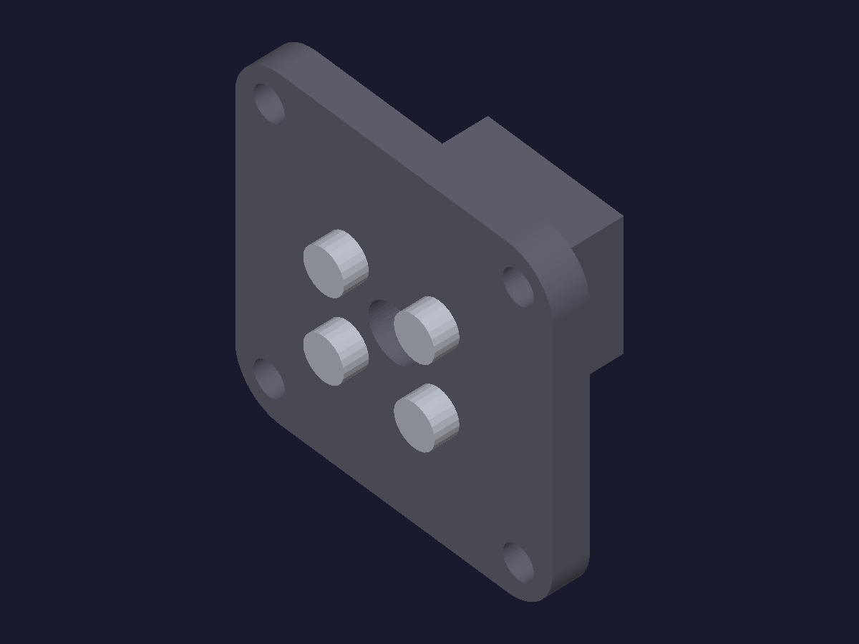
preview/hand_04_root_iso.png
