zhaoxiaofeng44/robot_arm/preview/hand_05_fist_iso.png

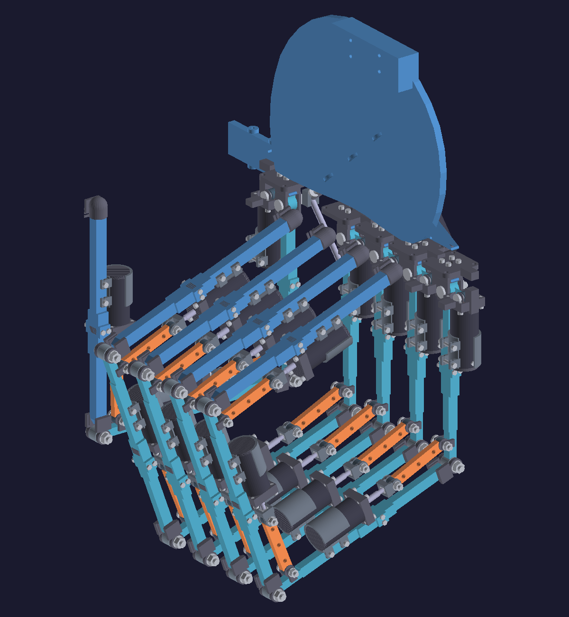
preview/hand_05_fist_iso.png
