zhaoxiaofeng44/robot_arm/preview/hand_05_root_side.png

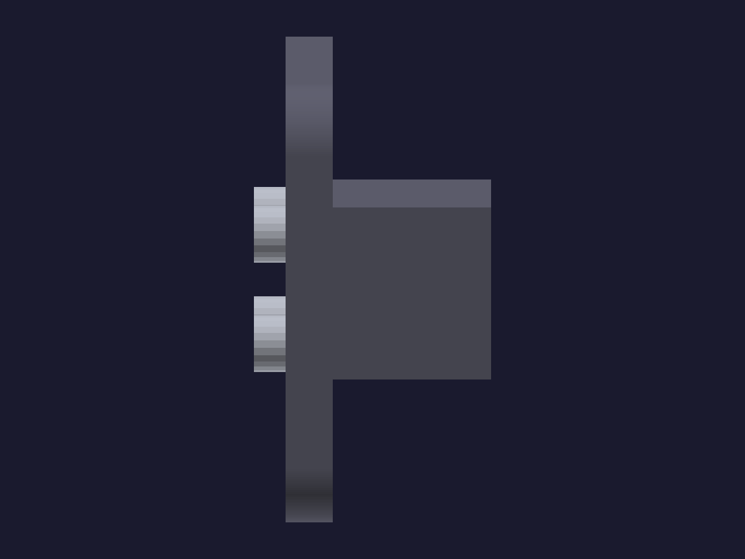
preview/hand_05_root_side.png
