zhaoxiaofeng44/robot_arm/preview/hand_06_pinch.png

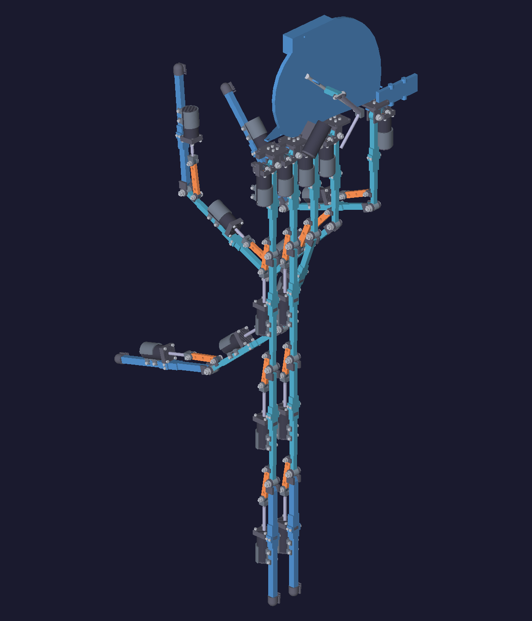
preview/hand_06_pinch.png
