zhaoxiaofeng44/robot_arm/preview/hand_06_root_iso2.png

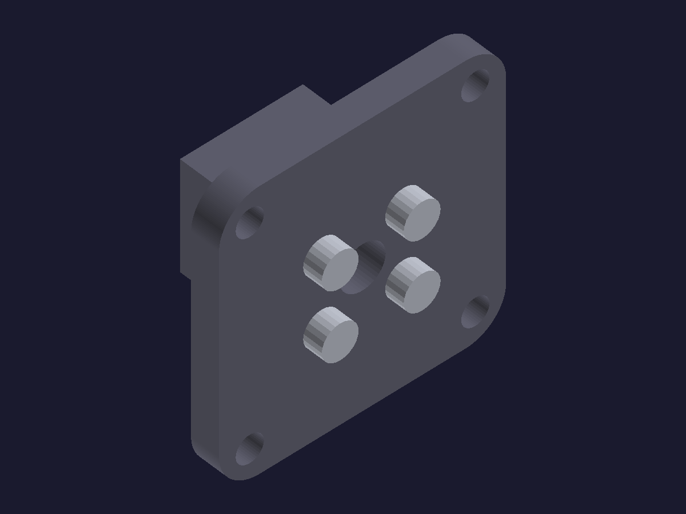
preview/hand_06_root_iso2.png
