zhaoxiaofeng44/robot_arm/preview/hand_07_chassis.png

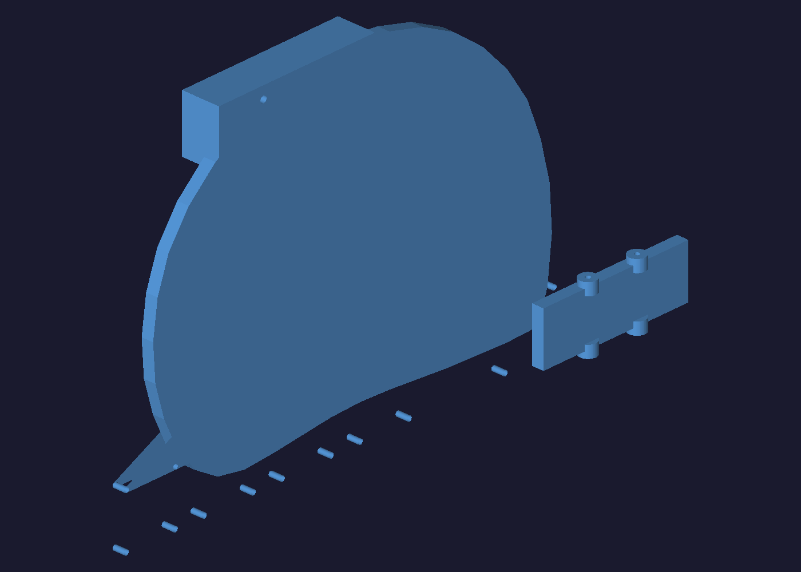
preview/hand_07_chassis.png
