zhaoxiaofeng44/robot_arm/preview/hand_07_curl_iso.png

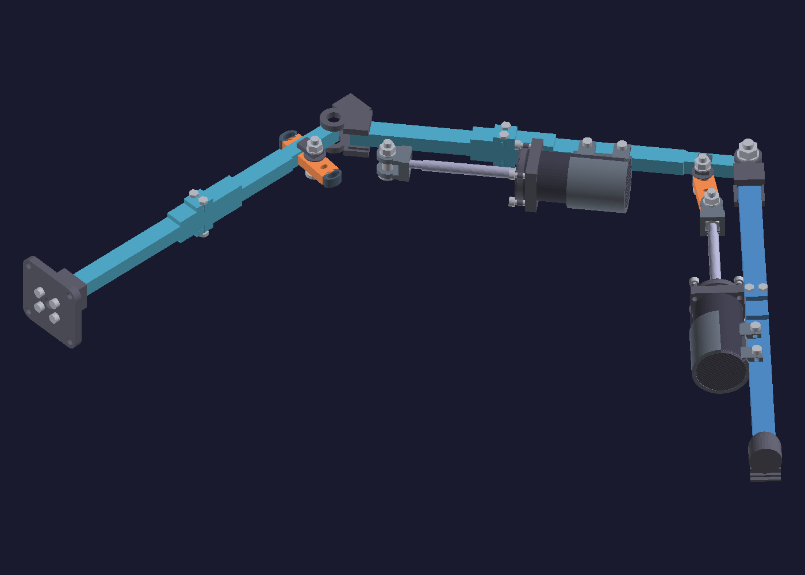
preview/hand_07_curl_iso.png
