zhaoxiaofeng44/robot_arm/preview/hand_08_curl_main.png

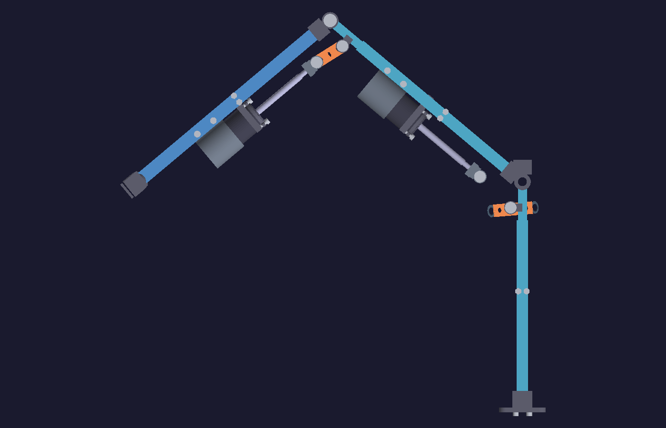
preview/hand_08_curl_main.png
