zhaoxiaofeng44/robot_arm/preview/hand_08_mcp_closeup.png

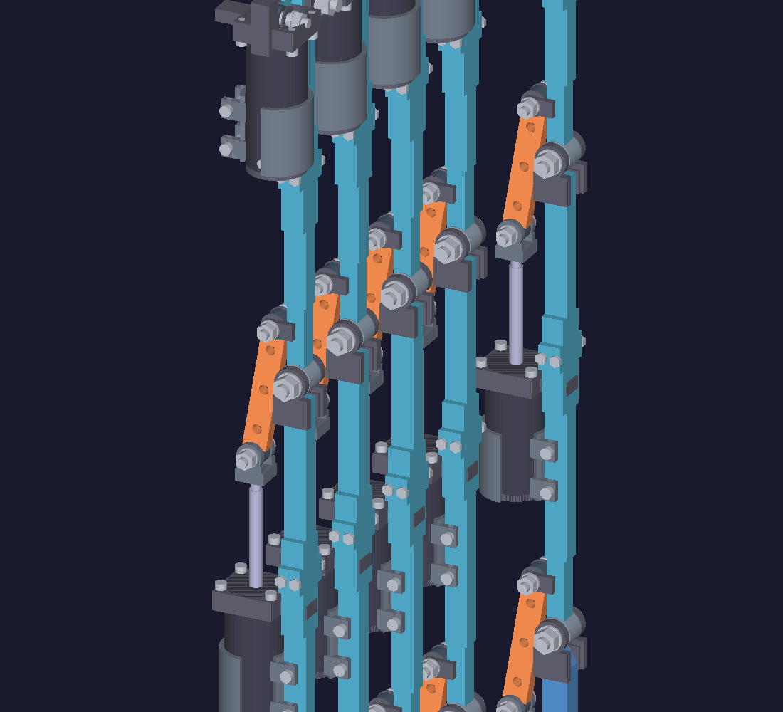
preview/hand_08_mcp_closeup.png
