zhaoxiaofeng44/robot_arm/preview/hand_09_curl_iso2.png

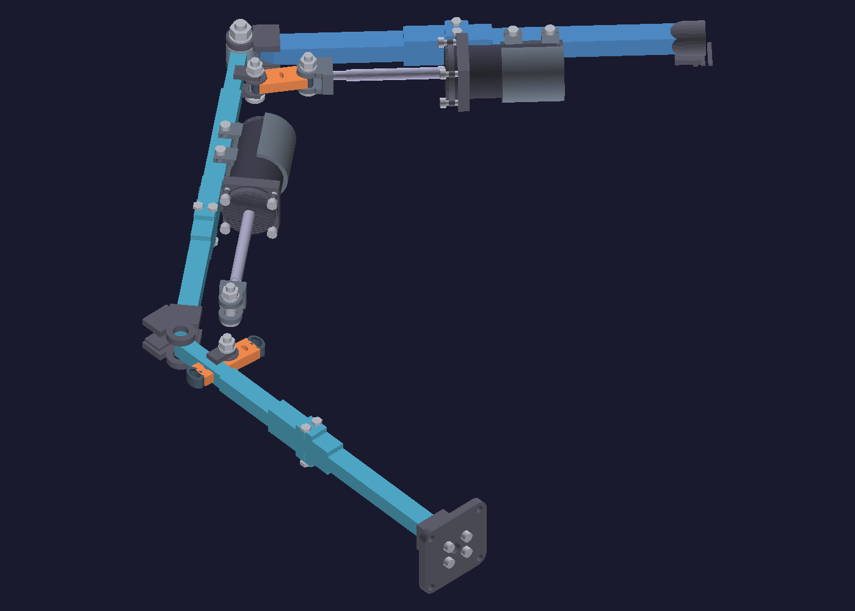
preview/hand_09_curl_iso2.png
