zhaoxiaofeng44/robot_arm/preview/hand_09_tips.png

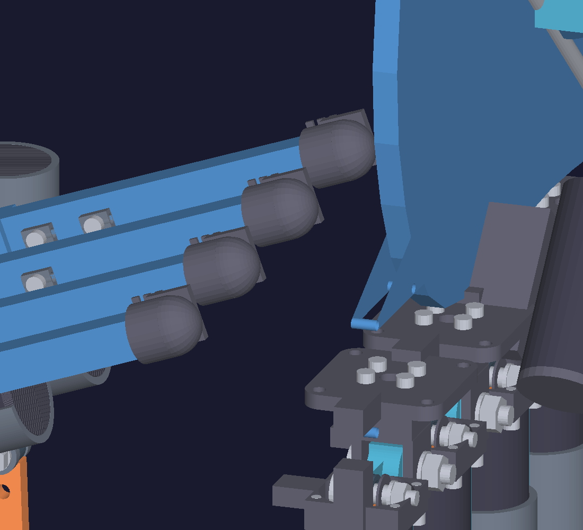
preview/hand_09_tips.png
