zhaoxiaofeng44/robot_arm/preview/hand_10_joint1.png

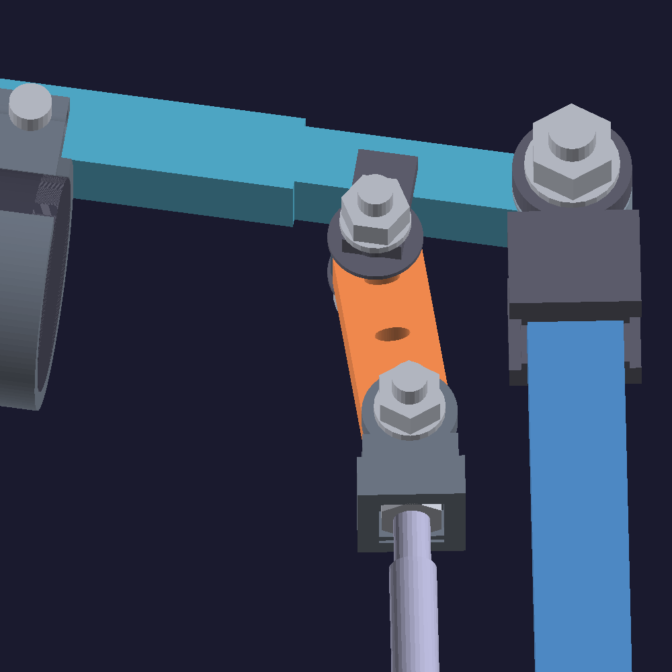
preview/hand_10_joint1.png
