zhaoxiaofeng44/robot_arm/preview/hand_10_wrist.png

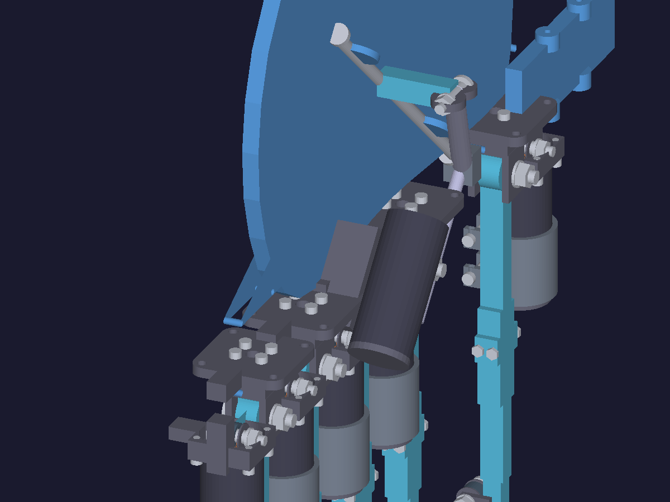
preview/hand_10_wrist.png
