zhaoxiaofeng44/robot_arm/preview/hand_11_joint2_tip.png

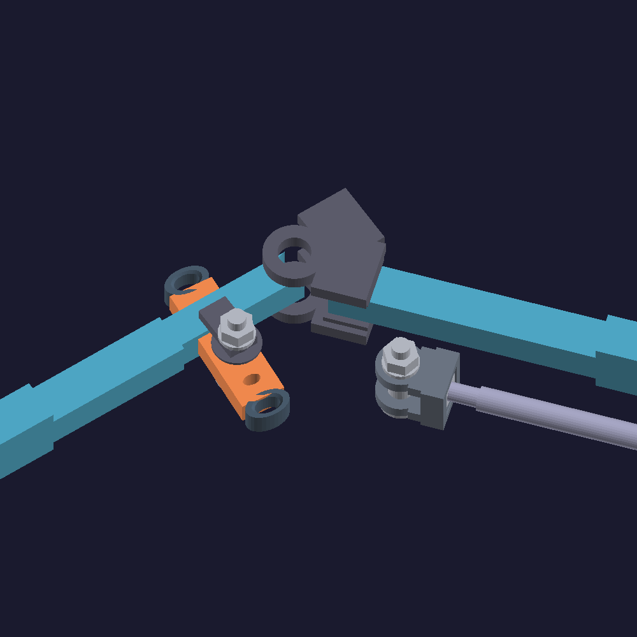
preview/hand_11_joint2_tip.png
