zhaoxiaofeng44/robot_arm/preview/hand_11_spread_hinge.png

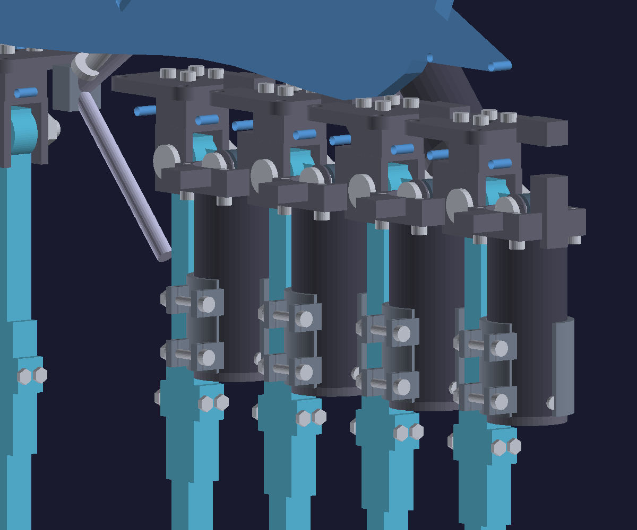
preview/hand_11_spread_hinge.png
