zhaoxiaofeng44/robot_arm/preview/hand_12_link1.png

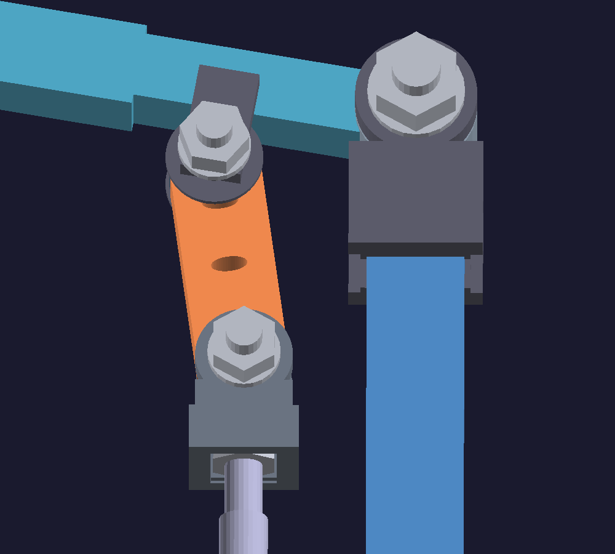
preview/hand_12_link1.png
