zhaoxiaofeng44/robot_arm/preview/hand_12b_bnut_pocket.png

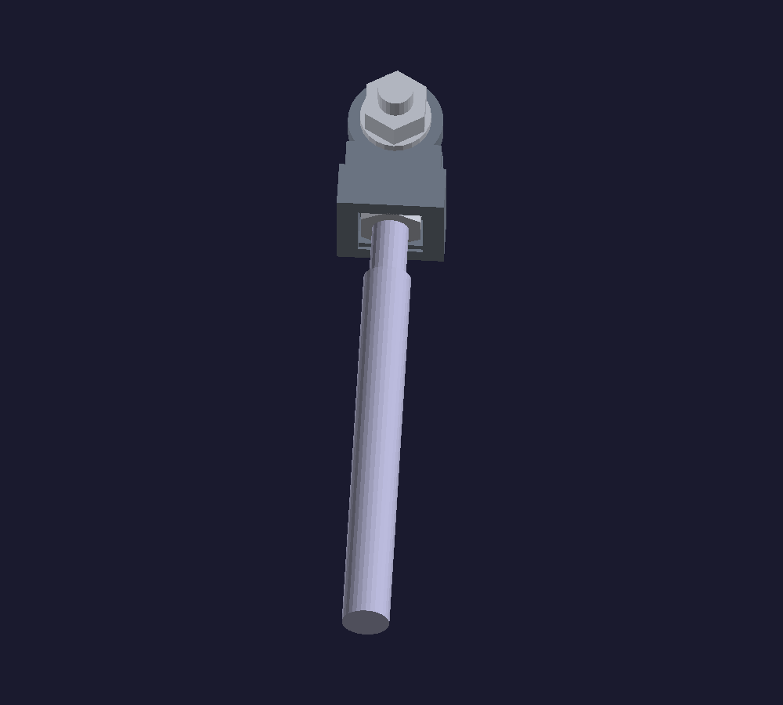
preview/hand_12b_bnut_pocket.png
