zhaoxiaofeng44/robot_arm/preview/hand_13_motor1_mount.png

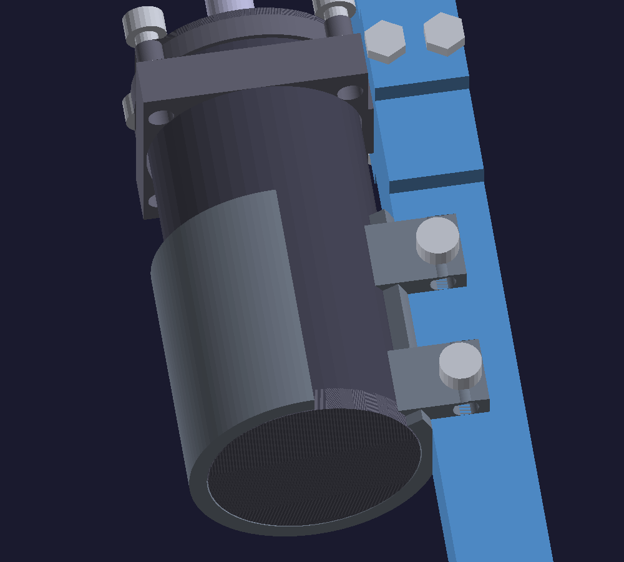
preview/hand_13_motor1_mount.png
