zhaoxiaofeng44/robot_arm/preview/hand_14_motor2_mount.png

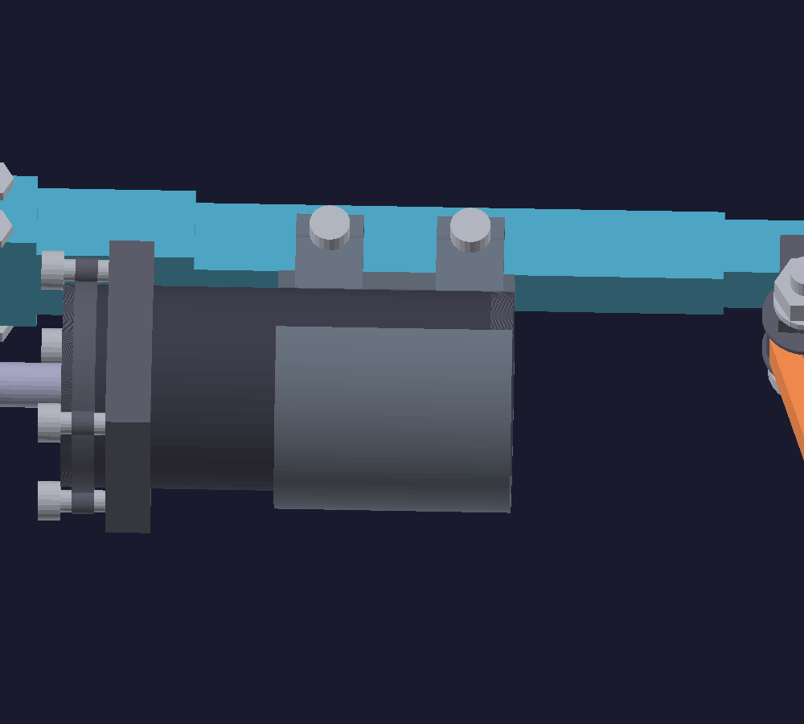
preview/hand_14_motor2_mount.png
