zhaoxiaofeng44/robot_arm/preview/hand_15_grip_tip.png

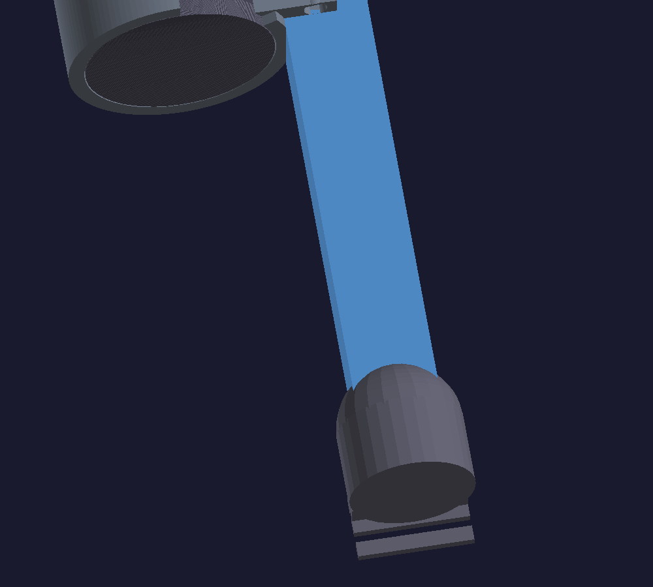
preview/hand_15_grip_tip.png
