zhaoxiaofeng44/robot_arm/preview/hand_16_fullflex_iso.png

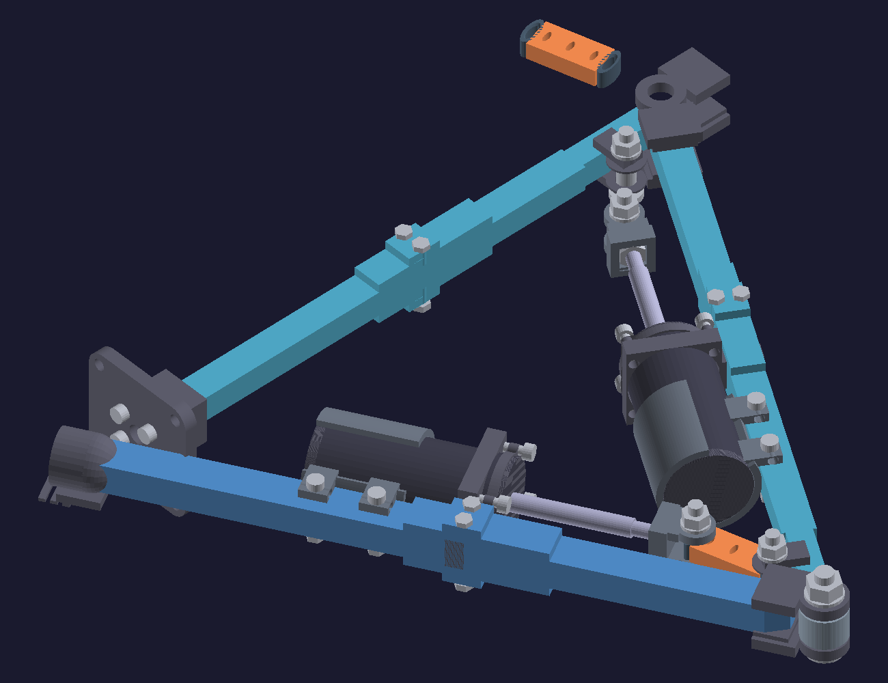
preview/hand_16_fullflex_iso.png
