zhaoxiaofeng44/robot_arm/preview/HAND_FINAL_RENDER_SHEET.png

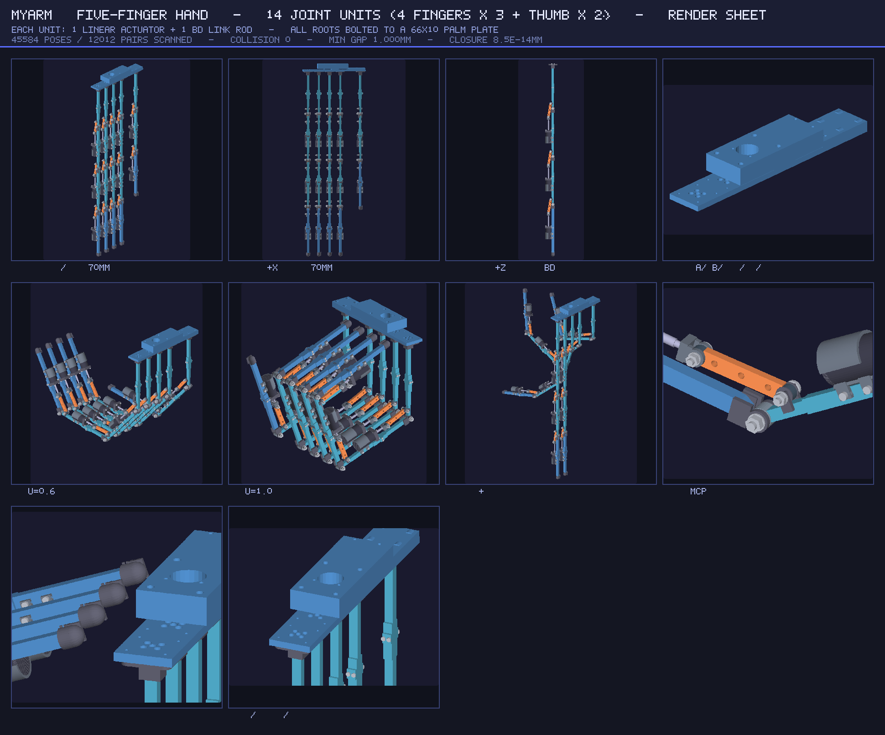
preview/HAND_FINAL_RENDER_SHEET.png
