zhaoxiaofeng44/robot_arm/stl/forearmProximal.stl

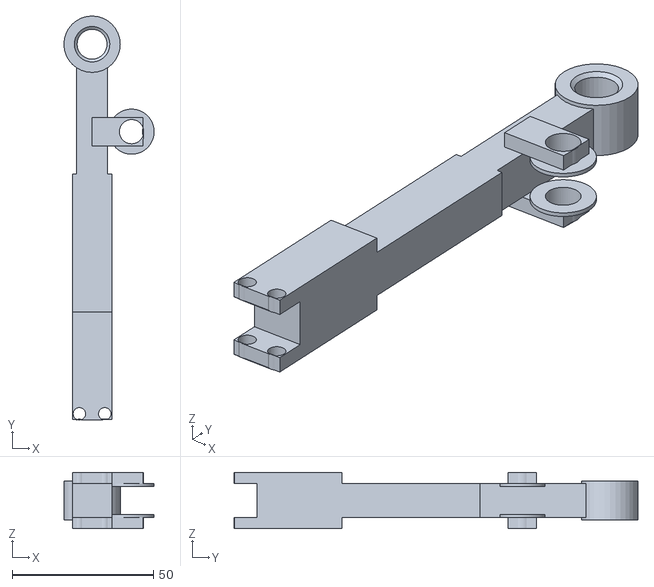
[picture p55: CAD file, 2026-10-10]
stl/forearmProximal.stl
32.0 x 143.2 x 20.0
