zhaoxiaofeng44/robot_arm/stl_finger/link_1.stl

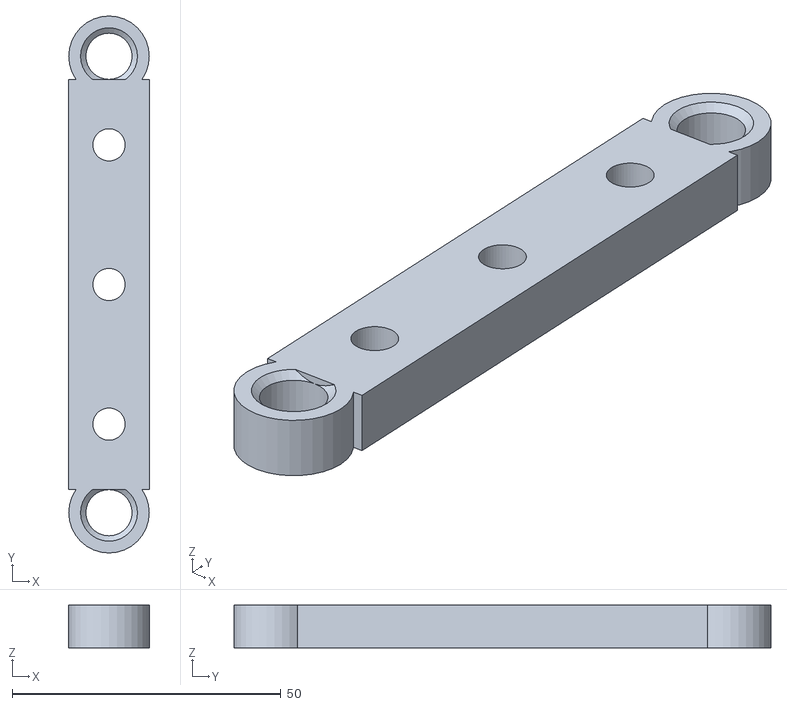
[picture p56: CAD file, 2026-10-11]
stl_finger/link_1.stl
15.0 x 100.0 x 8.00
