zhaoxiaofeng44/robot_arm/stl_hand/chassis_palmPlateA.stl

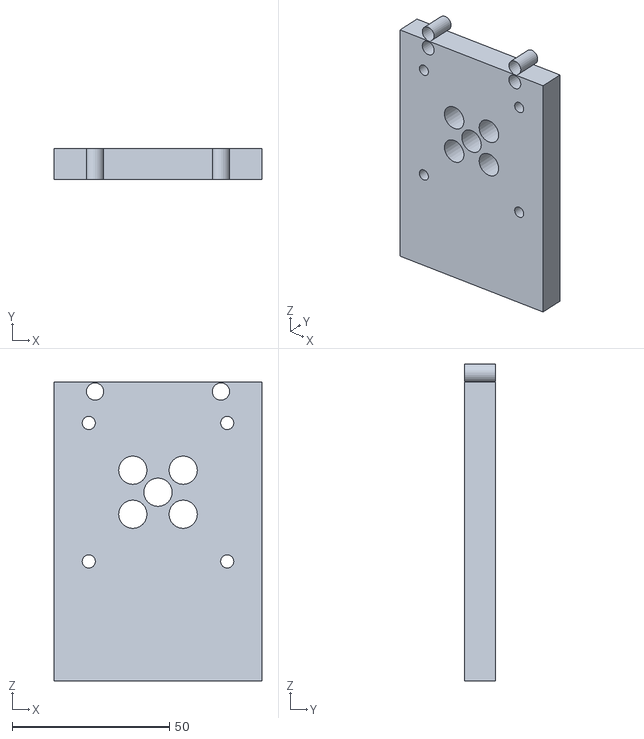
[picture p57: CAD file, 2026-11-07]
stl_hand/chassis_palmPlateA.stl
66.0 x 10.0 x 100.8
