zhaoxiaofeng44/robot_arm/stl/forearmDistal.stl

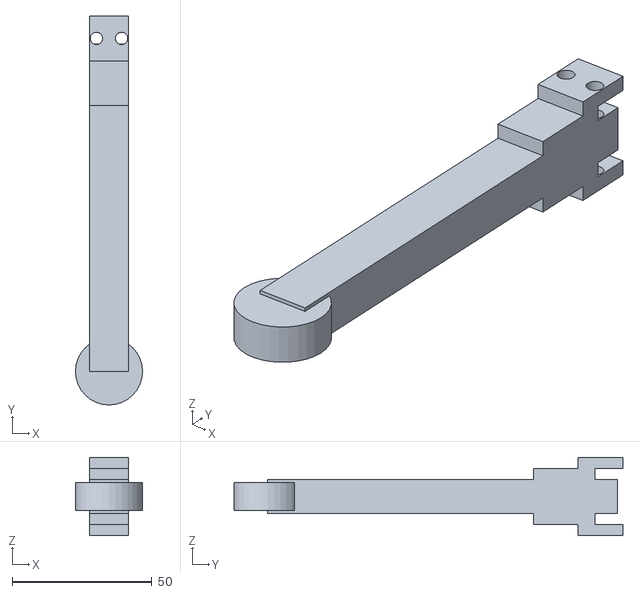
[picture p58: CAD file, 2026-10-10]
stl/forearmDistal.stl
24.0 x 139.0 x 28.0
