zhaoxiaofeng44/robot_arm/stl/rodClevis.stl

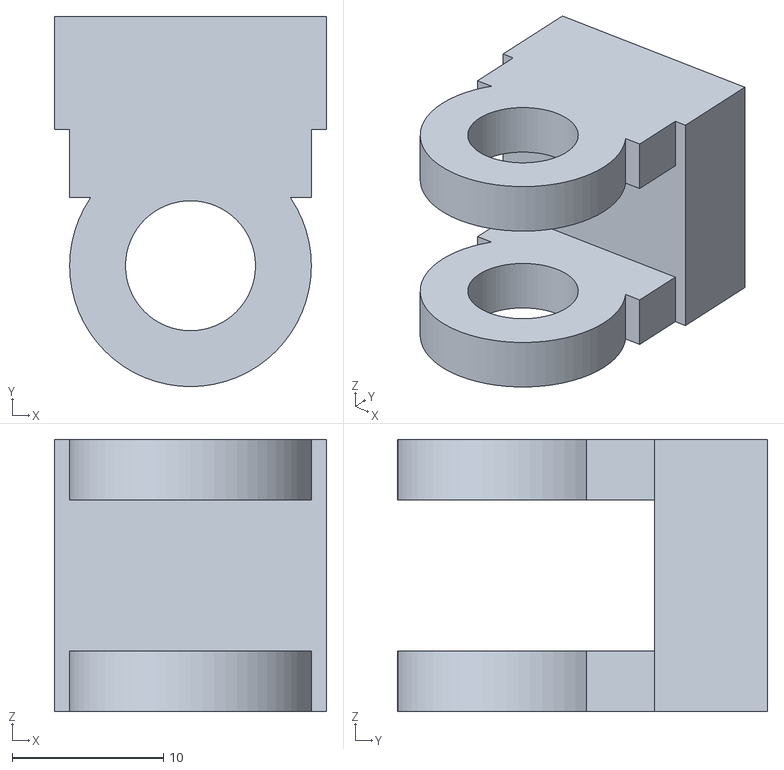
[picture p59: CAD file, 2026-10-10]
stl/rodClevis.stl
18.0 x 24.5 x 18.0
