zhaoxiaofeng44/robot_arm/stl_finger/motor0_collar.stl

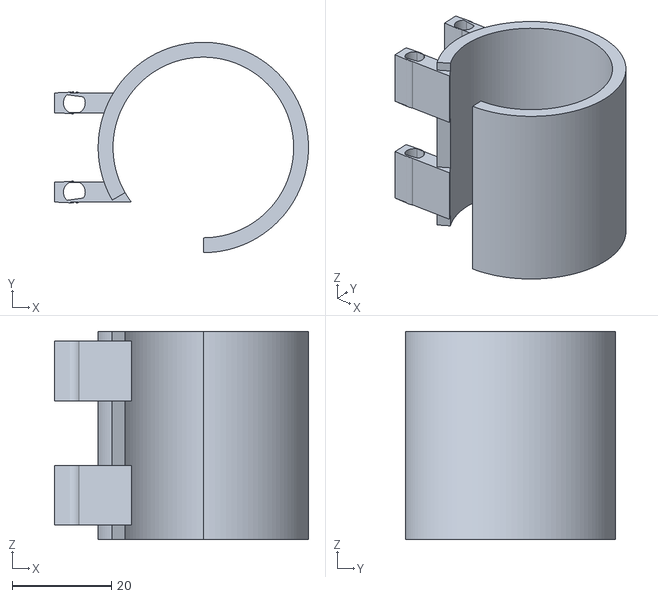
[picture p60: CAD file, 2026-10-11]
stl_finger/motor0_collar.stl
51.2 x 42.4 x 42.0
