zhaoxiaofeng44/robot_arm/stl_hand/chassis_thumbBridge.stl

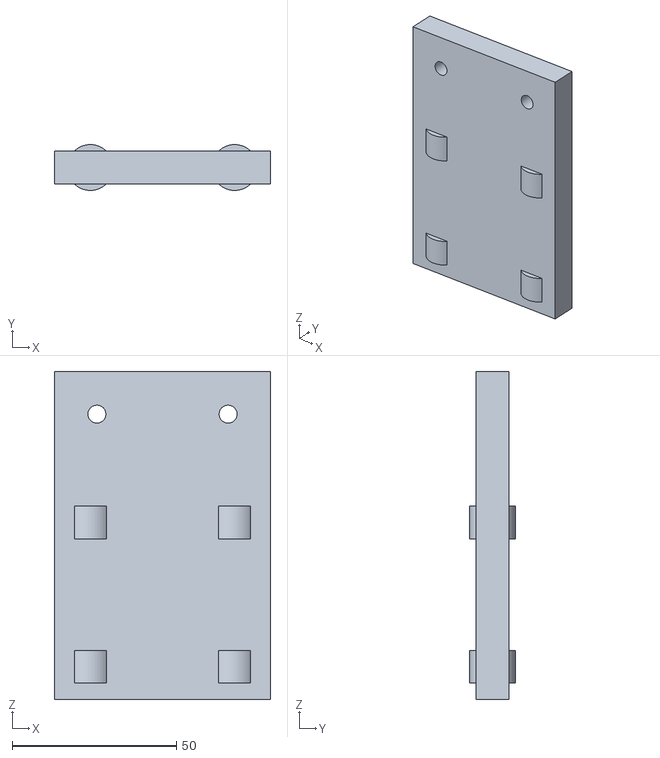
[picture p61: CAD file, 2026-11-07]
stl_hand/chassis_thumbBridge.stl
66.0 x 14.0 x 100.0
