zhaoxiaofeng44/robot_arm/stl/upperArmProximal.stl

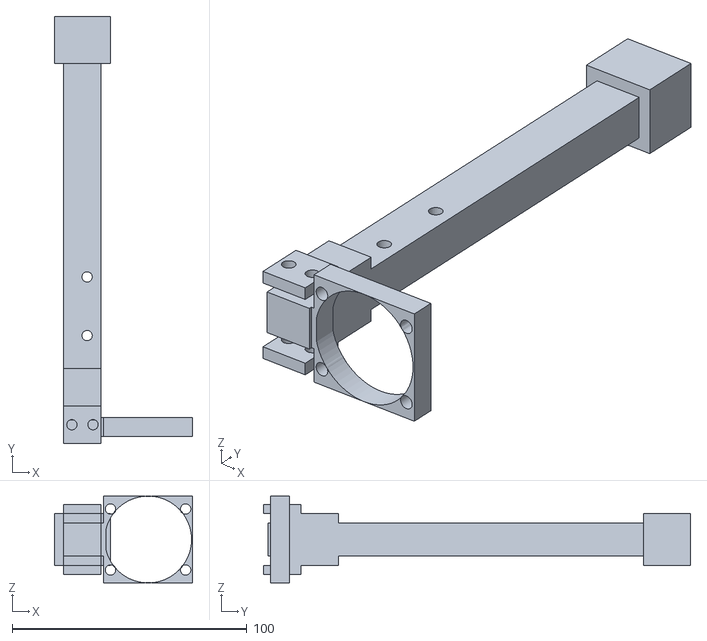
[picture p62: CAD file, 2026-10-10]
stl/upperArmProximal.stl
59.0 x 182.0 x 37.0
