zhaoxiaofeng44/robot_arm/stl_finger/p1_distal.stl

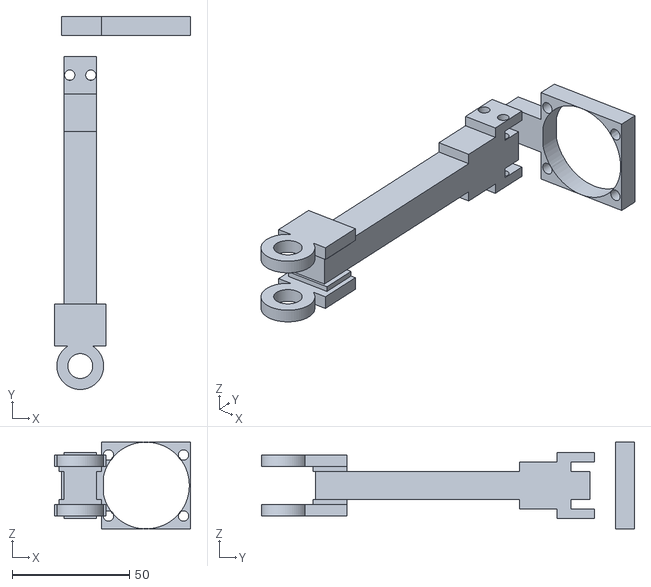
[picture p63: CAD file, 2026-10-11]
stl_finger/p1_distal.stl
58.0 x 159.0 x 37.0
