zhaoxiaofeng44/robot_arm/stl_hand/finger_terminal_distal.stl

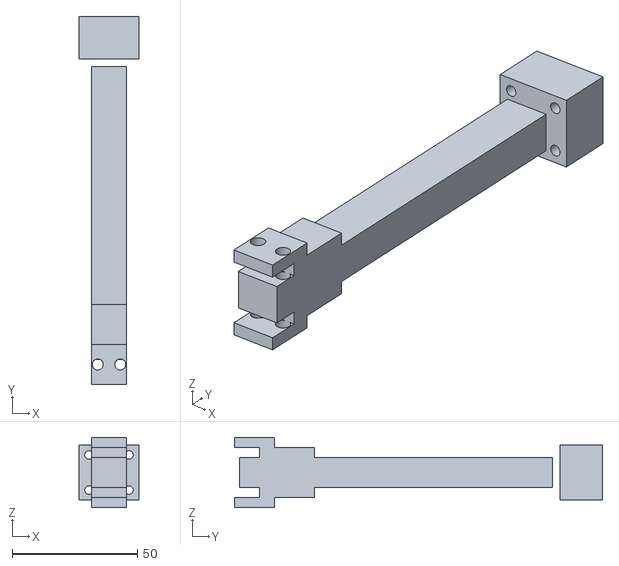
[picture p64: CAD file, 2026-10-19]
stl_hand/finger_terminal_distal.stl
24.0 x 147.0 x 28.0
