zhaoxiaofeng44/robot_arm/stl/upperArmDistal.stl

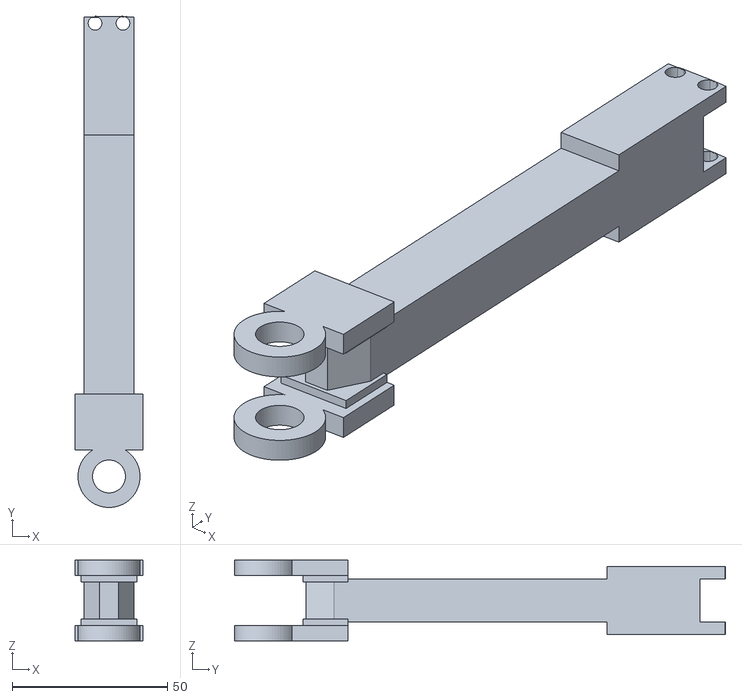
[picture p65: CAD file, 2026-10-10]
stl/upperArmDistal.stl
22.0 x 158.2 x 26.0
