zhaoxiaofeng44/robot_arm/stl_finger/palm_proximal.stl

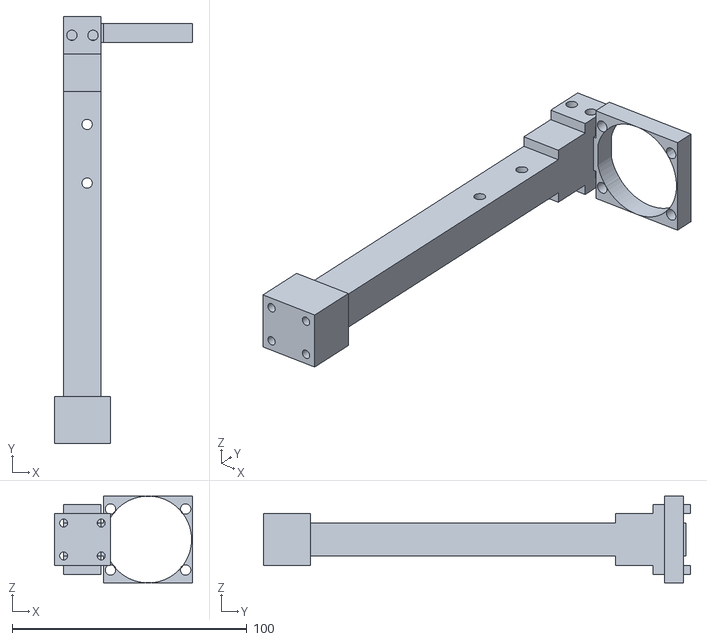
[picture p66: CAD file, 2026-10-11]
stl_finger/palm_proximal.stl
59.0 x 182.0 x 37.0
