zhaoxiaofeng44/robot_arm/stl_hand/finger_palm_proximal.stl

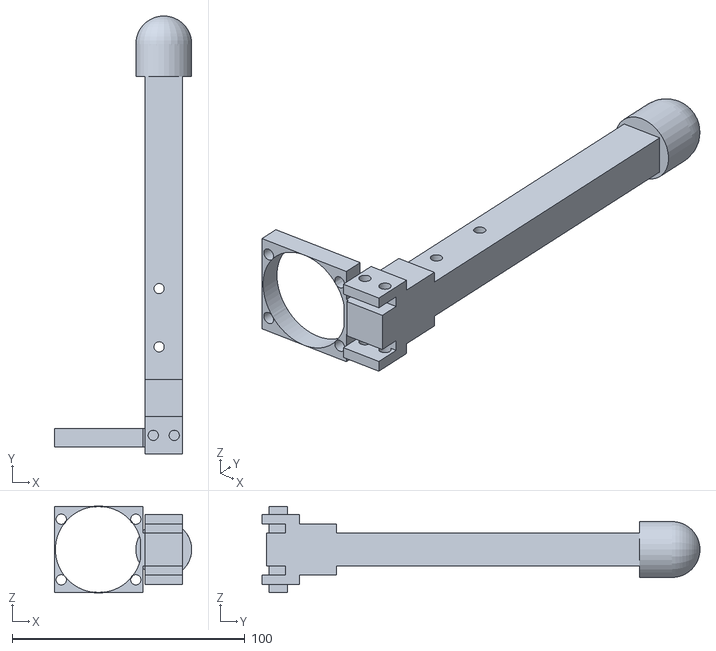
[picture p67: CAD file, 2026-10-11]
stl_hand/finger_palm_proximal.stl
59.0 x 188.0 x 37.0
