zhaoxiaofeng44/robot_arm/stl/motorCollar.stl

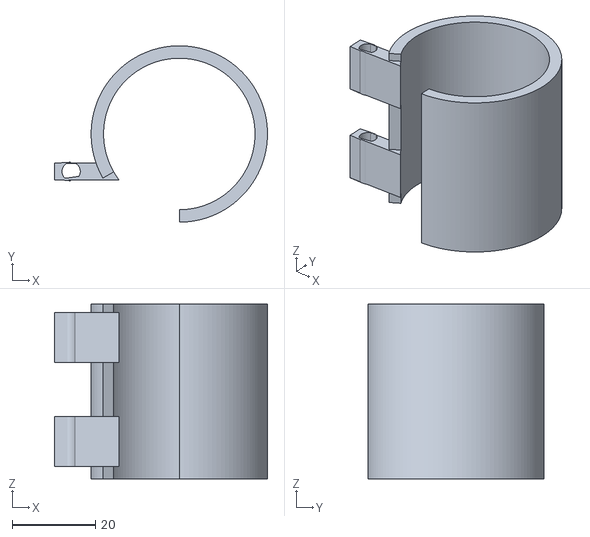
[picture p68: CAD file, 2026-10-01]
stl/motorCollar.stl
51.2 x 42.4 x 42.0
