zhaoxiaofeng44/robot_arm/stl/linkBD.stl

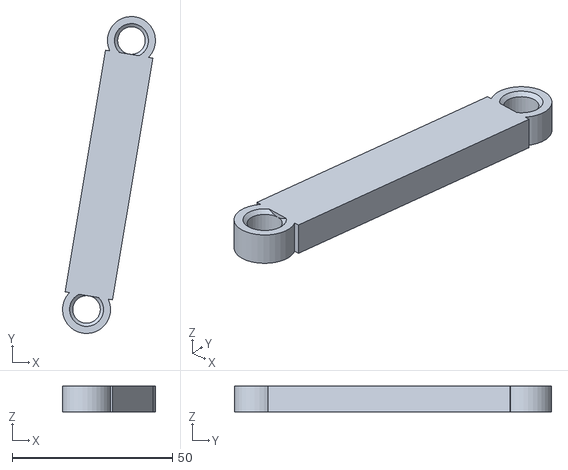
[picture p69: CAD file, 2026-10-01]
stl/linkBD.stl
29.0 x 98.8 x 8.00
