zhaoxiaofeng44/robot_arm/stl_finger/palm_mount.stl

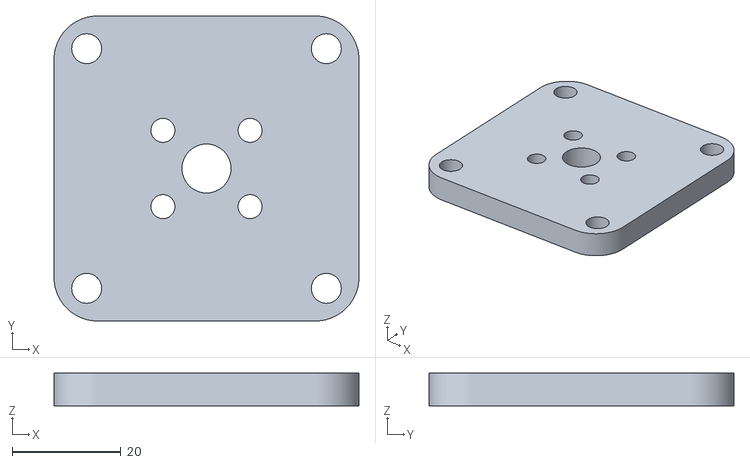
[picture p70: CAD file, 2026-10-10]
stl_finger/palm_mount.stl
56.0 x 56.0 x 6.00
