zhaoxiaofeng44/robot_arm/stl/rivetElbow.stl

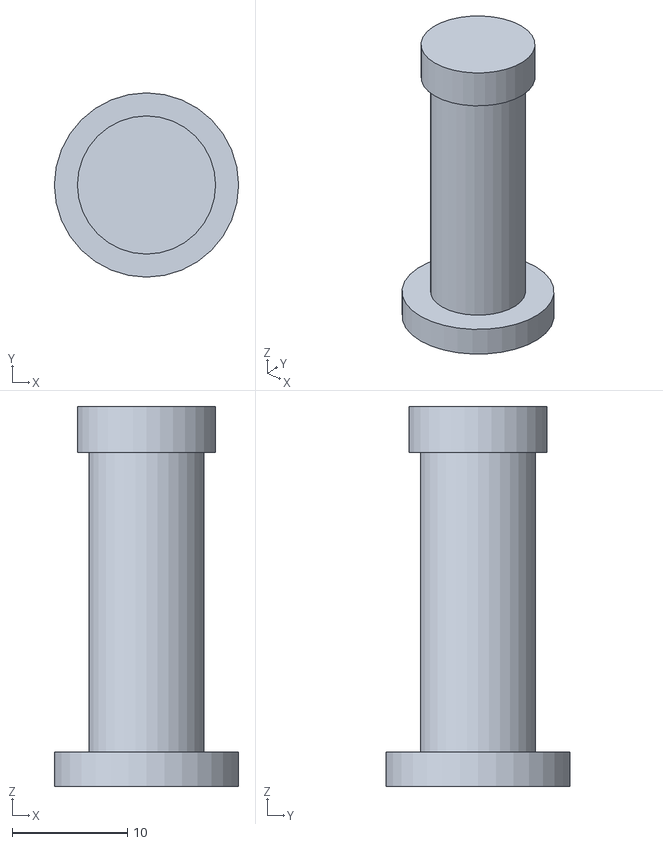
[picture p71: CAD file, 2026-09-30]
stl/rivetElbow.stl
16.0 x 16.0 x 33.0
