zhaoxiaofeng44/robot_arm/stl/rivetD.stl

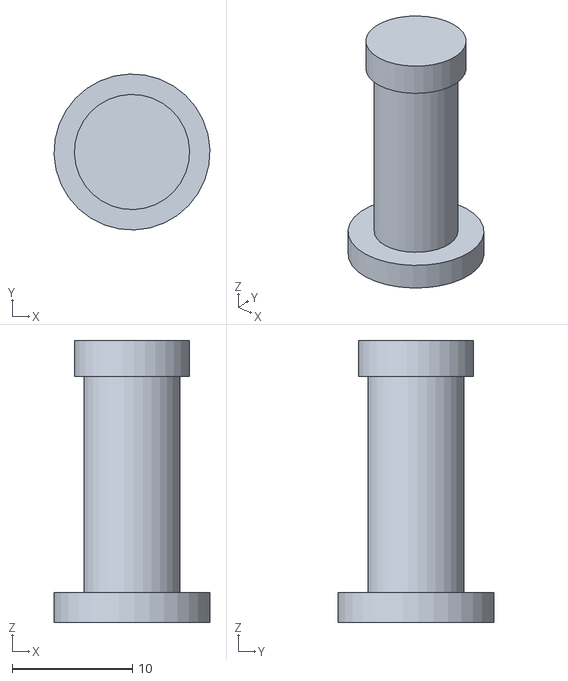
[picture p72: CAD file, 2026-09-30]
stl/rivetD.stl
13.0 x 13.0 x 23.5
