zhaoxiaofeng44/robot_arm/stl_finger/p2_proximal.stl

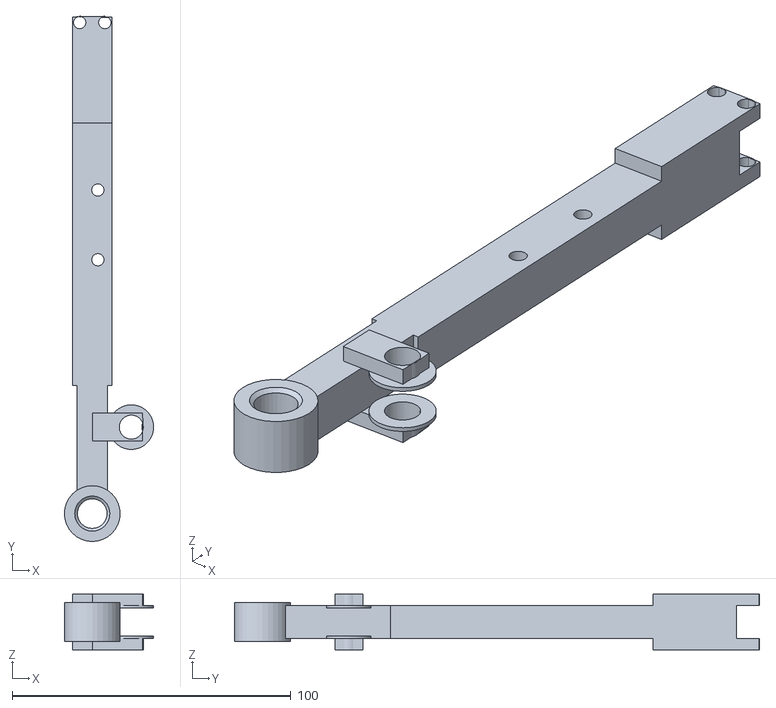
[picture p73: CAD file, 2026-10-10]
stl_finger/p2_proximal.stl
32.0 x 188.2 x 20.0
