zhaoxiaofeng44/robot_arm/stl/motorSaddle.stl

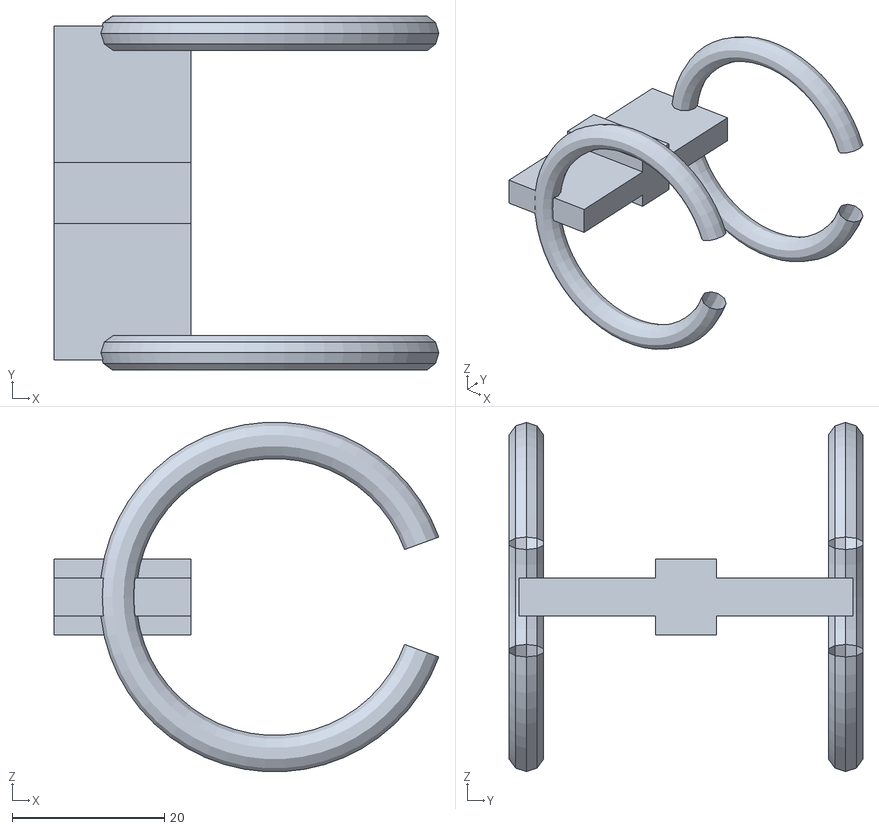
[picture p74: CAD file, 2026-09-30]
stl/motorSaddle.stl
50.6 x 46.6 x 45.9
