zhaoxiaofeng44/robot_arm/stl_finger/grip_pad.stl

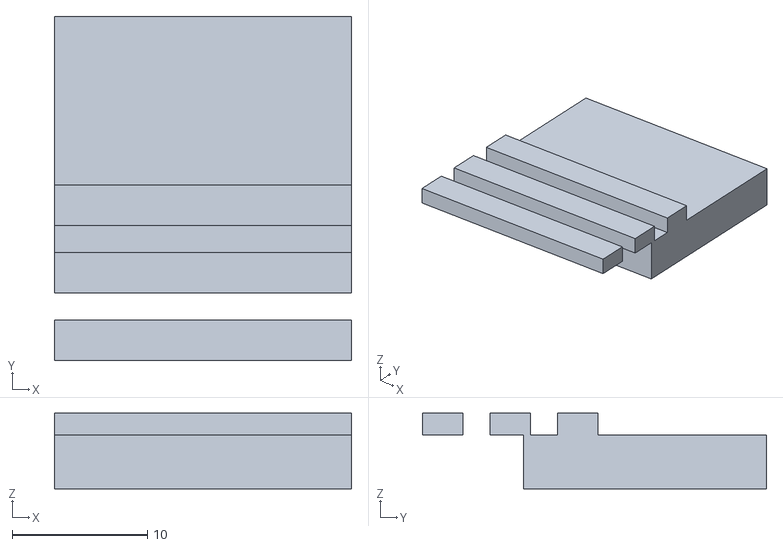
[picture p75: CAD file, 2026-10-02]
stl_finger/grip_pad.stl
22.0 x 25.5 x 5.60
