zhaoxiaofeng44/robot_arm/stl_hand/chassis_palmSpliceTop.stl

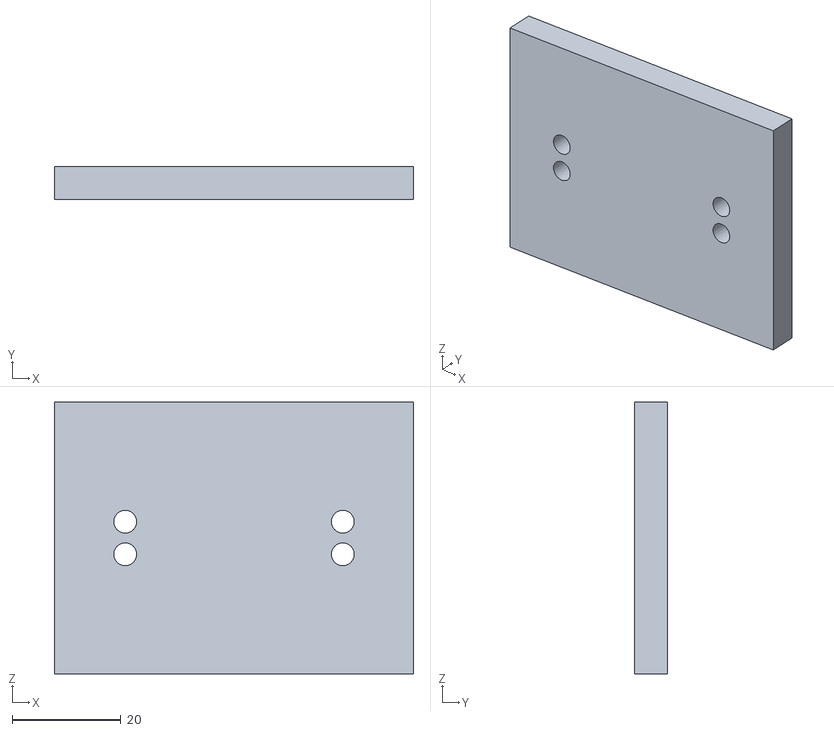
[picture p76: CAD file, 2026-10-11]
stl_hand/chassis_palmSpliceTop.stl
66.0 x 6.00 x 50.0
