zhaoxiaofeng44/robot_arm/stl_hand/chassis_palmPlateB.stl

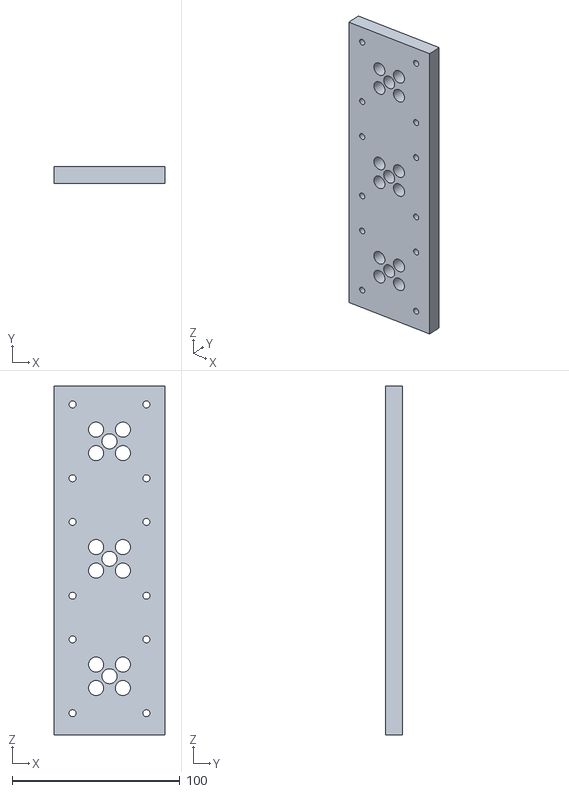
[picture p77: CAD file, 2026-10-11]
stl_hand/chassis_palmPlateB.stl
66.0 x 10.0 x 208.0
