zhaoxiaofeng44/robot_arm/stl_hand/chassis_wristBlock.stl

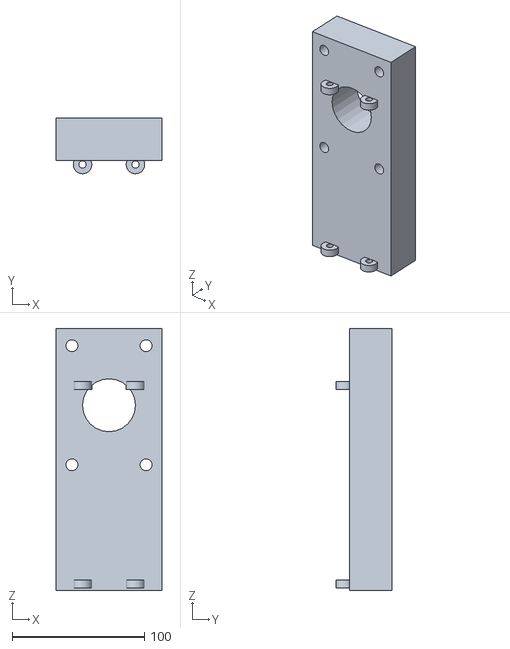
[picture p78: CAD file, 2026-10-11]
stl_hand/chassis_wristBlock.stl
80.0 x 42.0 x 198.0
