zhaoxiaofeng44/robot_arm/stl_hand/middle_motor2_collar.stl

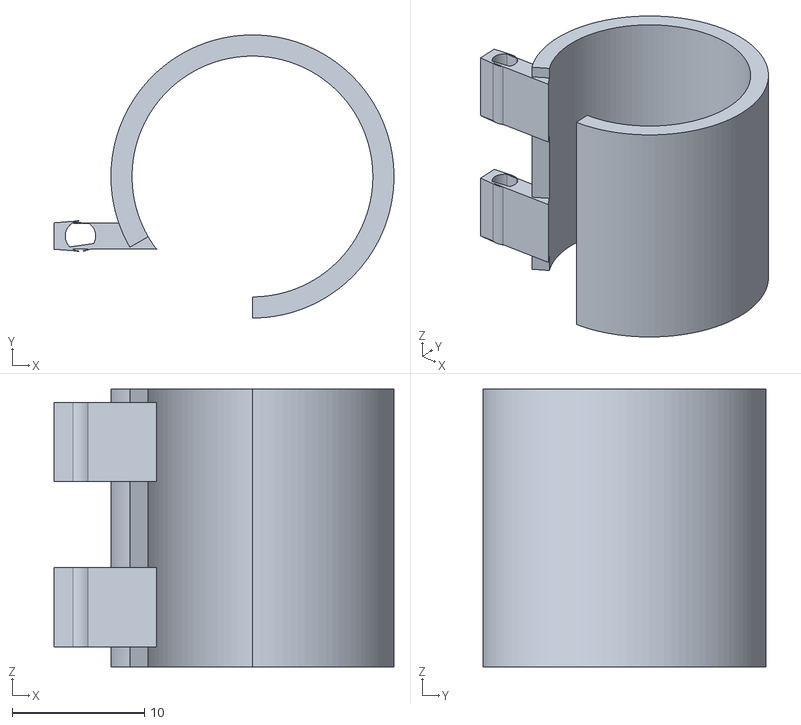
[picture p79: CAD file, 2026-10-10]
stl_hand/middle_motor2_collar.stl
25.7 x 21.4 x 21.0
