zhaoxiaofeng44/robot_arm/stl_hand/index_knuckle_seat.stl

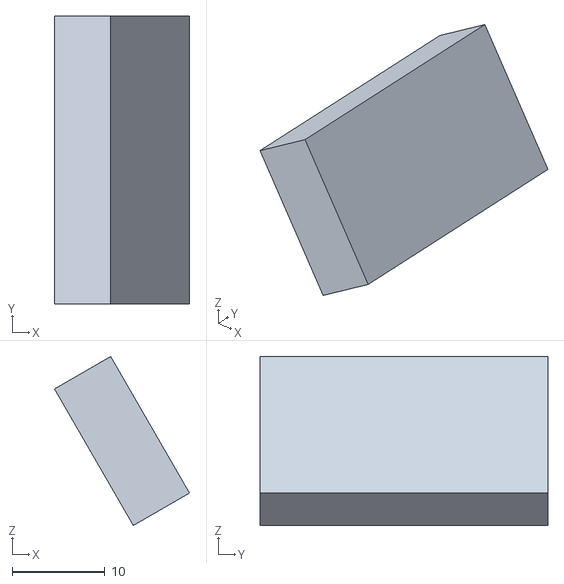
[picture p80: CAD file, 2026-10-10]
stl_hand/index_knuckle_seat.stl
14.6 x 31.0 x 18.2
