zhaoxiaofeng44/robot_arm/stl_hand/ring_b_clevis_1.stl

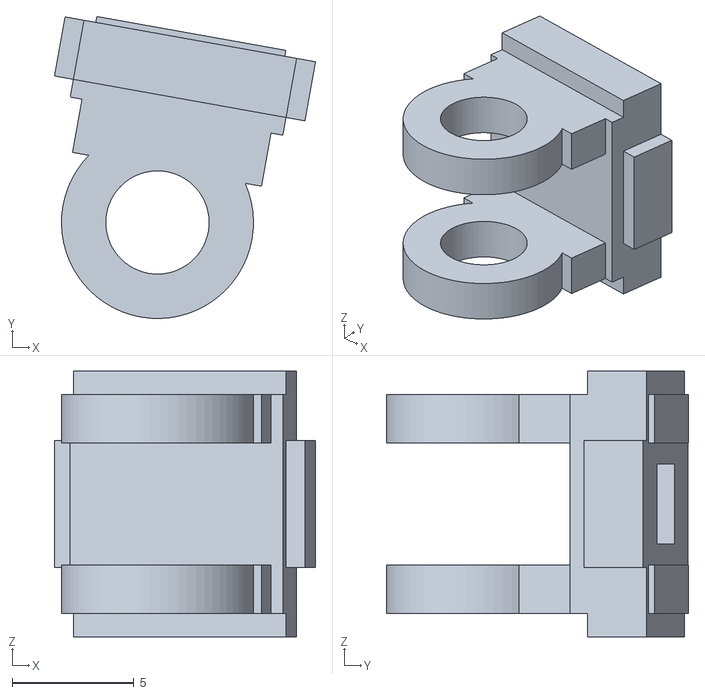
[picture p81: CAD file, 2026-10-10]
stl_hand/ring_b_clevis_1.stl
10.7 x 12.4 x 10.9
