zhaoxiaofeng44/robot_arm/stl_hand/thumb_p2_distal.stl

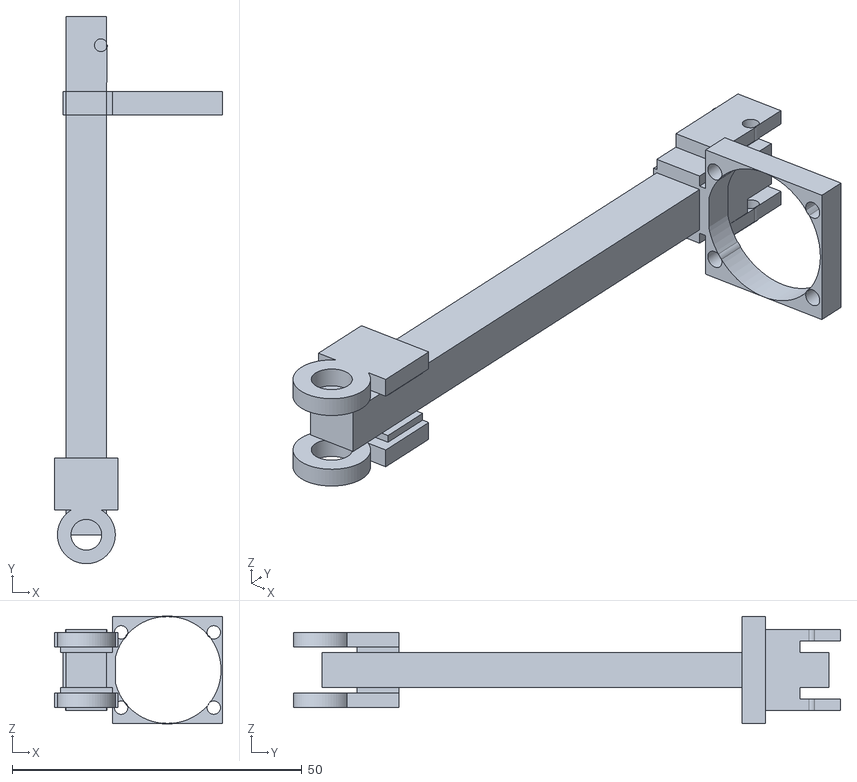
[picture p82: CAD file, 2026-10-10]
stl_hand/thumb_p2_distal.stl
29.0 x 94.5 x 18.5
