zhaoxiaofeng44/robot_arm/stl_hand/middle_rail_tie.stl

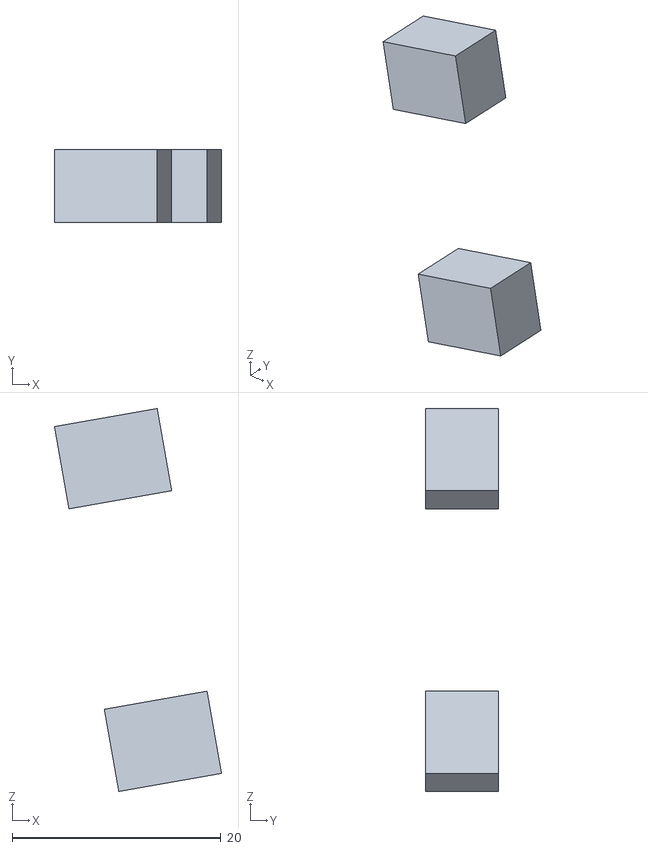
[picture p83: CAD file, 2026-10-10]
stl_hand/middle_rail_tie.stl
16.0 x 7.00 x 36.7
