zhaoxiaofeng44/robot_arm/stl_hand/thumb_knuckle_seat.stl

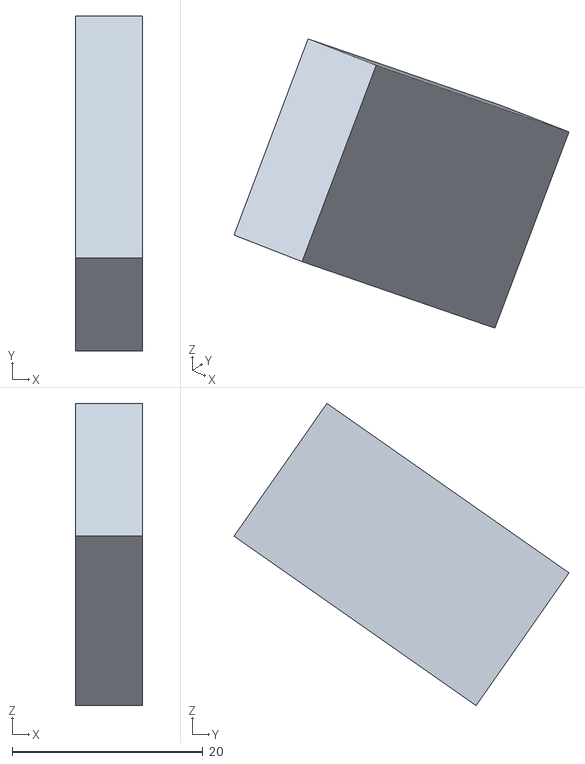
[picture p84: CAD file, 2026-10-10]
stl_hand/thumb_knuckle_seat.stl
7.00 x 35.1 x 31.7
