zhaoxiaofeng44/robot_arm/stl_hand/pinky_p2_distal.stl

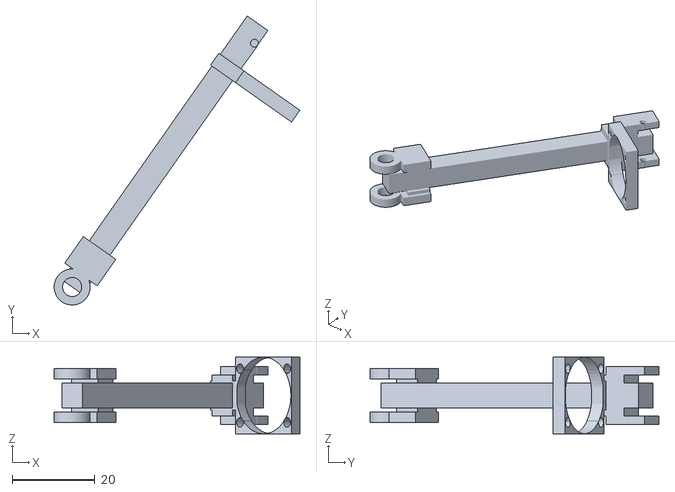
[picture p85: CAD file, 2026-10-10]
stl_hand/pinky_p2_distal.stl
59.3 x 69.8 x 18.5
