zhaoxiaofeng44/robot_arm/stl_hand/pinky_p3_proximal.stl

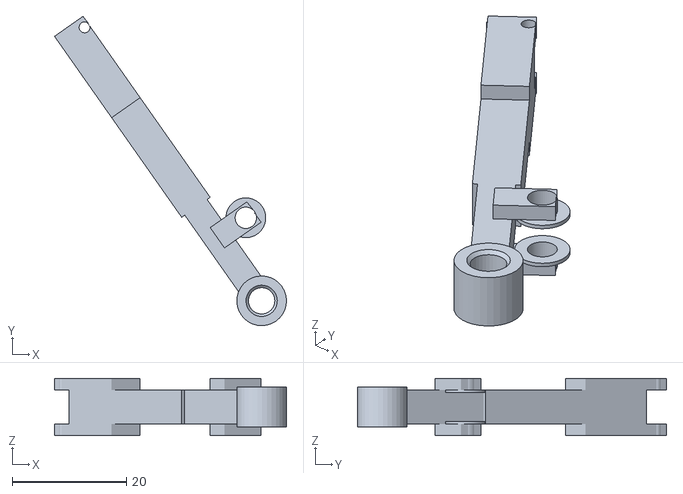
[picture p86: CAD file, 2026-10-10]
stl_hand/pinky_p3_proximal.stl
40.6 x 54.1 x 10.0
