zhaoxiaofeng44/robot_arm/stl_hand/thumb_rail_tie.stl

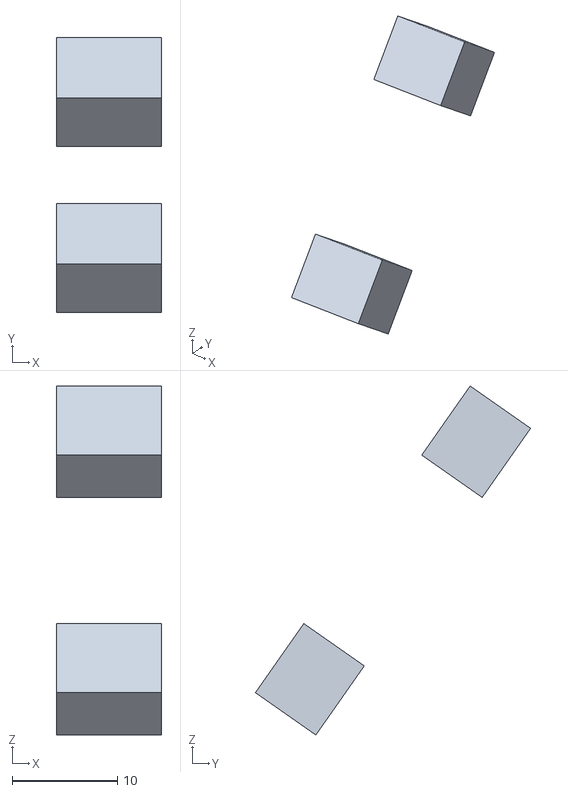
[picture p87: CAD file, 2026-10-10]
stl_hand/thumb_rail_tie.stl
10.0 x 26.1 x 33.1
