zhaoxiaofeng44/robot_arm/stl_hand/pinky_p1_proximal.stl

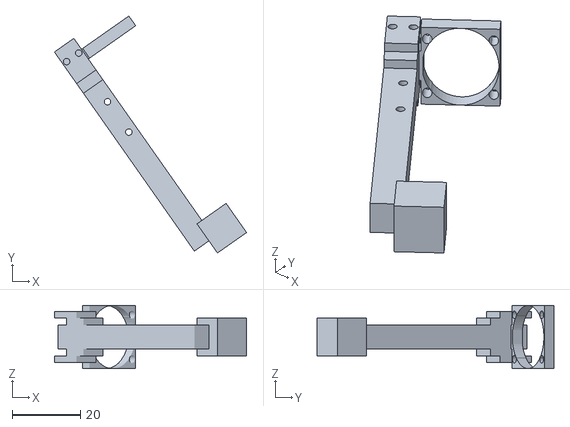
[picture p88: CAD file, 2026-10-10]
stl_hand/pinky_p1_proximal.stl
56.3 x 69.4 x 18.5
