zhaoxiaofeng44/robot_arm/stl_hand/middle_link_1.stl

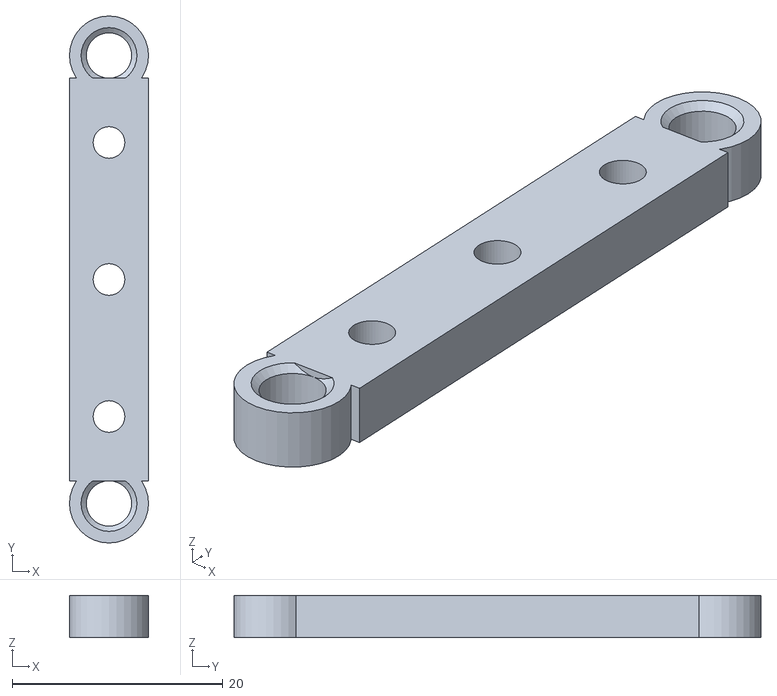
[picture p89: CAD file, 2026-10-10]
stl_hand/middle_link_1.stl
7.50 x 50.0 x 4.00
