zhaoxiaofeng44/robot_arm/stl_hand/pinky_link_1.stl

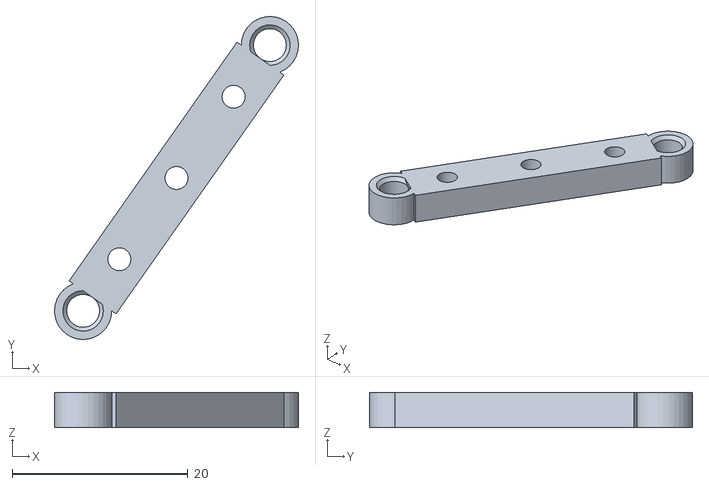
[picture p90: CAD file, 2026-10-10]
stl_hand/pinky_link_1.stl
27.8 x 36.8 x 4.00
