zhaoxiaofeng44/robot_arm/stl_hand/ring_knuckle_seat.stl

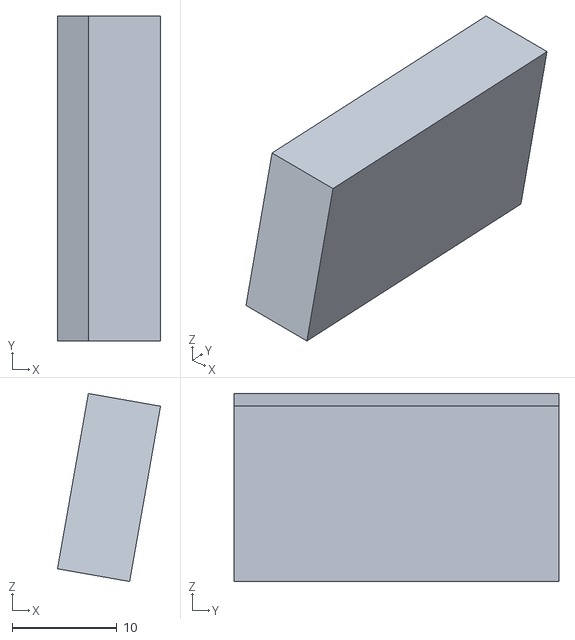
[picture p91: CAD file, 2026-10-10]
stl_hand/ring_knuckle_seat.stl
9.85 x 31.0 x 18.0
