zhaoxiaofeng44/robot_arm/stl_hand/wrist_flange.stl

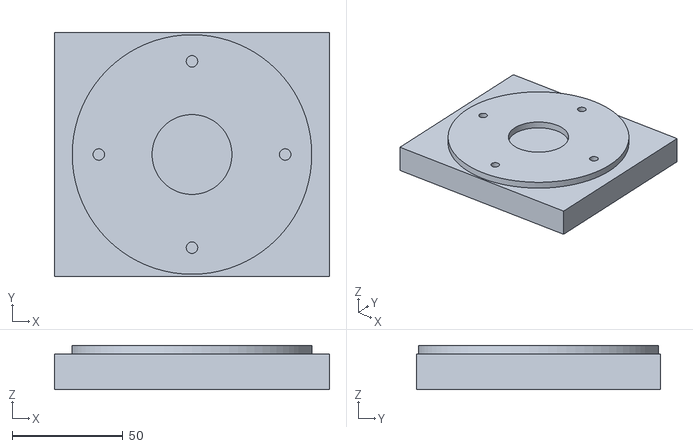
[picture p92: CAD file, 2026-10-10]
stl_hand/wrist_flange.stl
124.0 x 110.0 x 20.0
