zhaoxiaofeng44/robot_arm/stl_hand/palm_pad.stl

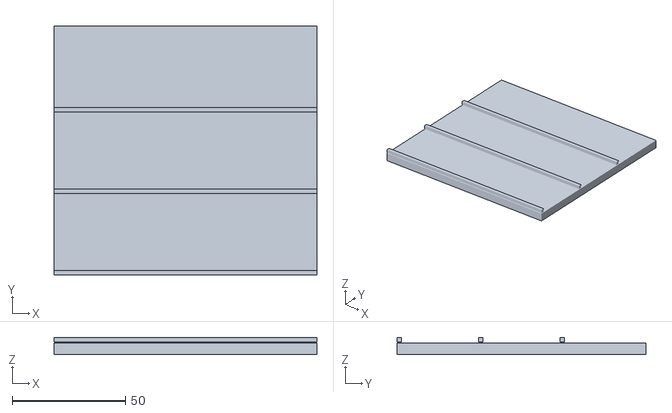
[picture p93: CAD file, 2026-10-10]
stl_hand/palm_pad.stl
116.0 x 110.0 x 7.50
