zhaoxiaofeng44/robot_arm/stl_hand/pinky_p3_distal.stl

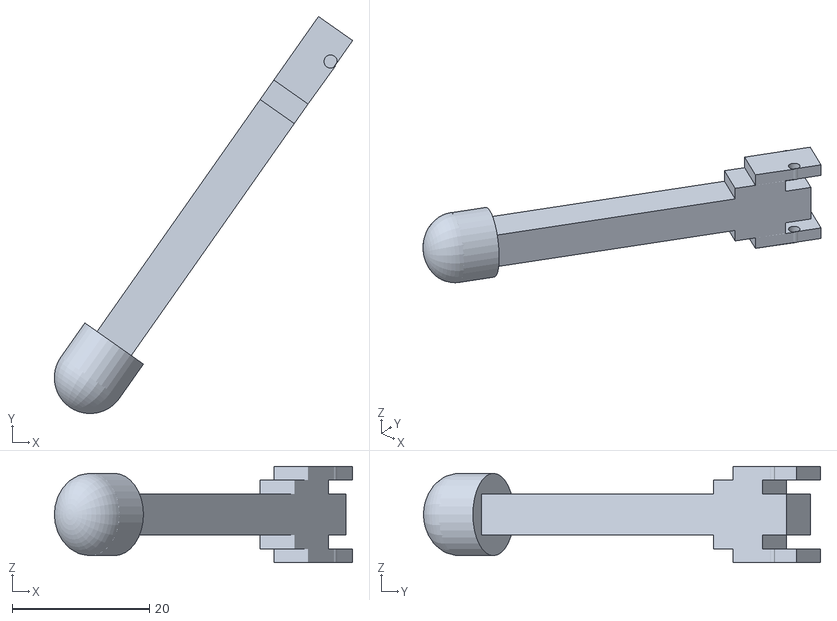
[picture p94: CAD file, 2026-10-10]
stl_hand/pinky_p3_distal.stl
43.5 x 57.8 x 14.0
