zhaoxiaofeng44/robot_arm/stl_hand/ring_p1_fork.stl

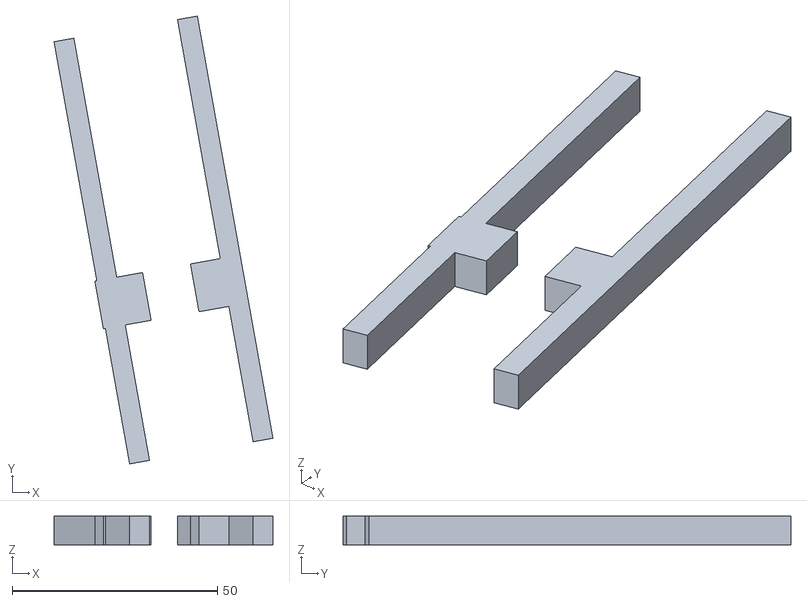
[picture p95: CAD file, 2026-10-10]
stl_hand/ring_p1_fork.stl
53.3 x 109.0 x 7.00
