zhaoxiaofeng44/robot_arm/stl_hand/ring_motor1_collar.stl

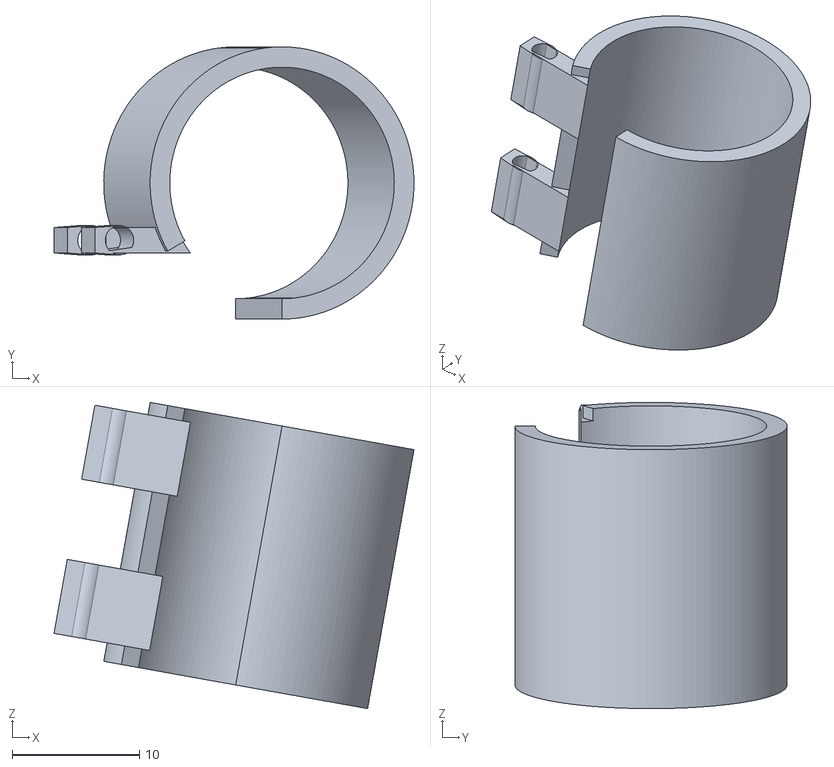
[picture p96: CAD file, 2026-10-10]
stl_hand/ring_motor1_collar.stl
28.3 x 21.4 x 24.1
