zhaoxiaofeng44/robot_arm/stl_hand/ring_p1_proximal.stl

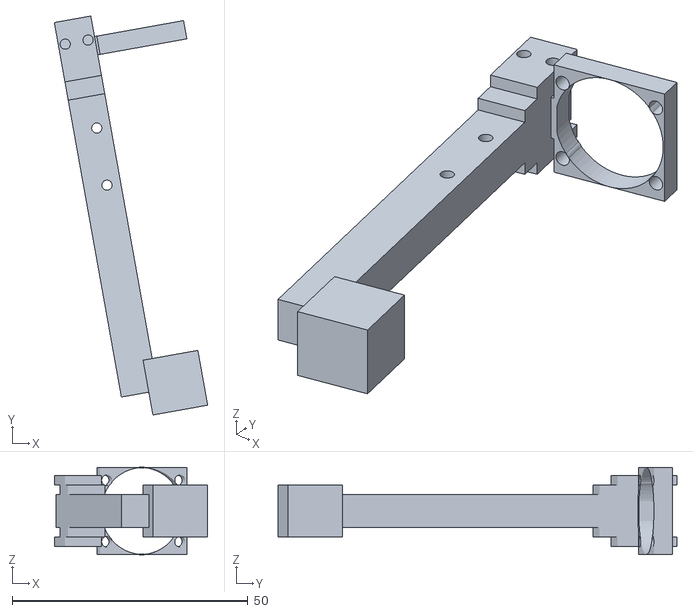
[picture p97: CAD file, 2026-10-10]
stl_hand/ring_p1_proximal.stl
32.6 x 84.7 x 18.5
