zhaoxiaofeng44/robot_arm/stl_hand/thumb_link_1.stl

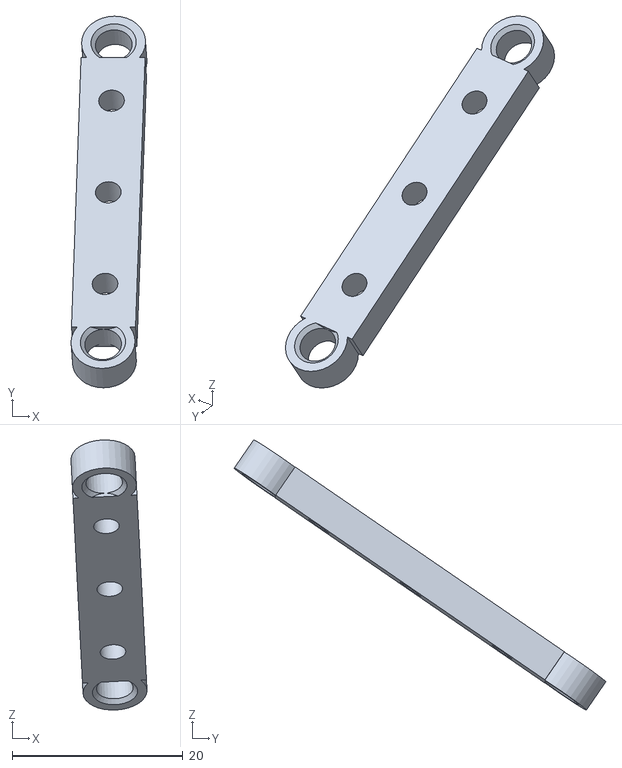
[picture p98: CAD file, 2026-10-10]
stl_hand/thumb_link_1.stl
8.90 x 43.5 x 31.6
