zhaoxiaofeng44/robot_arm/stl_hand/ring_rail.stl

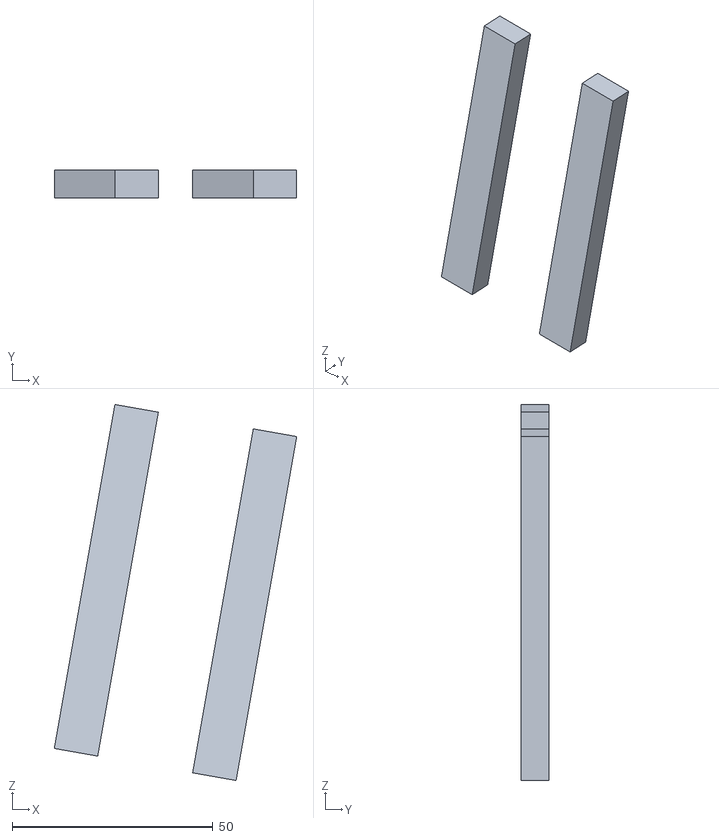
[picture p99: CAD file, 2026-10-10]
stl_hand/ring_rail.stl
60.4 x 7.00 x 93.7
