zhaoxiaofeng44/robot_arm/stl_hand/pinky_p1_fork.stl

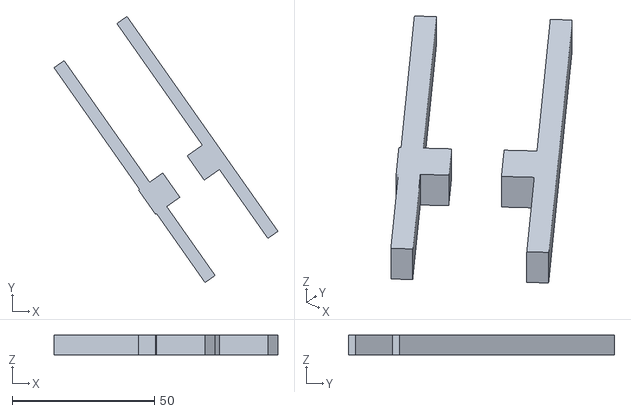
[picture p101: CAD file, 2026-10-10]
stl_hand/pinky_p1_fork.stl
78.6 x 93.4 x 7.00
