zhaoxiaofeng44/robot_arm/stl_hand/ring_grip_pad.stl

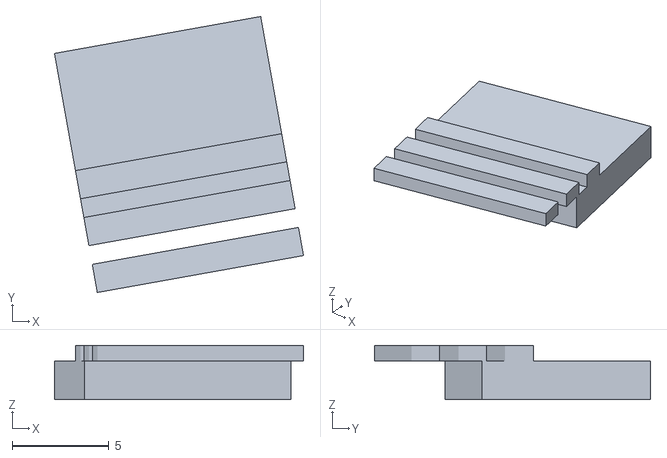
[picture p102: CAD file, 2026-10-10]
stl_hand/ring_grip_pad.stl
12.9 x 14.3 x 2.80
