zhaoxiaofeng44/robot_arm/stl_hand/ring_p2_proximal.stl

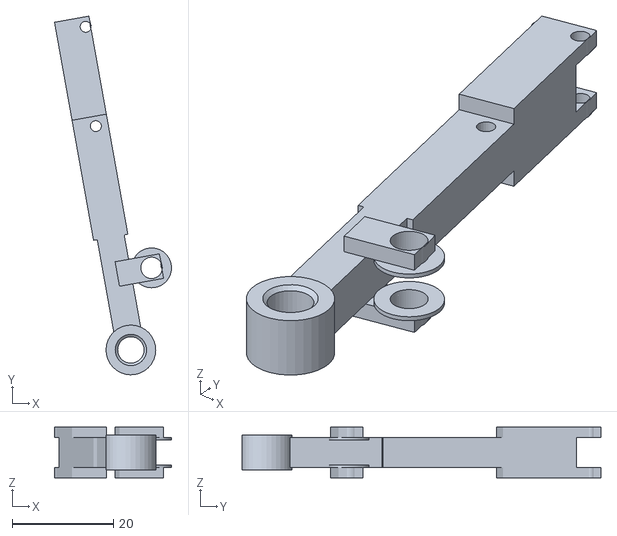
[picture p103: CAD file, 2026-10-10]
stl_hand/ring_p2_proximal.stl
23.1 x 71.0 x 10.0
