zhaoxiaofeng44/robot_arm/stl_hand/pinky_p1_distal.stl

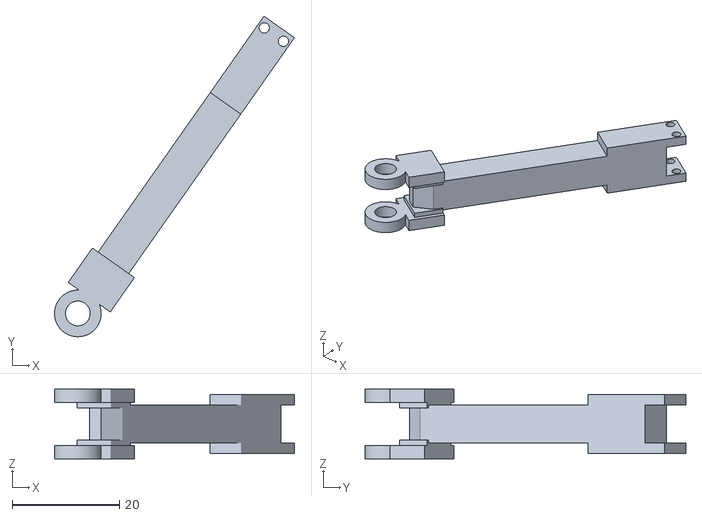
[picture p104: CAD file, 2026-10-10]
stl_hand/pinky_p1_distal.stl
44.7 x 59.7 x 13.0
