zhaoxiaofeng44/robot_arm/stl_hand/middle_p3_distal.stl

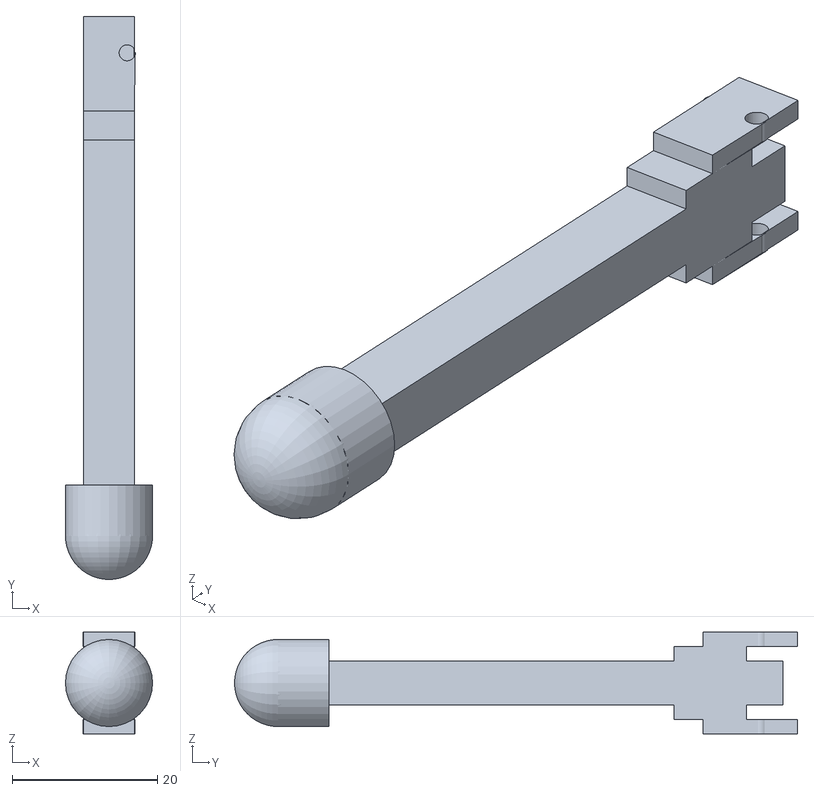
[picture p105: CAD file, 2026-10-10]
stl_hand/middle_p3_distal.stl
12.0 x 77.5 x 14.0
