zhaoxiaofeng44/robot_arm/stl_hand/pinky_grip_pad.stl

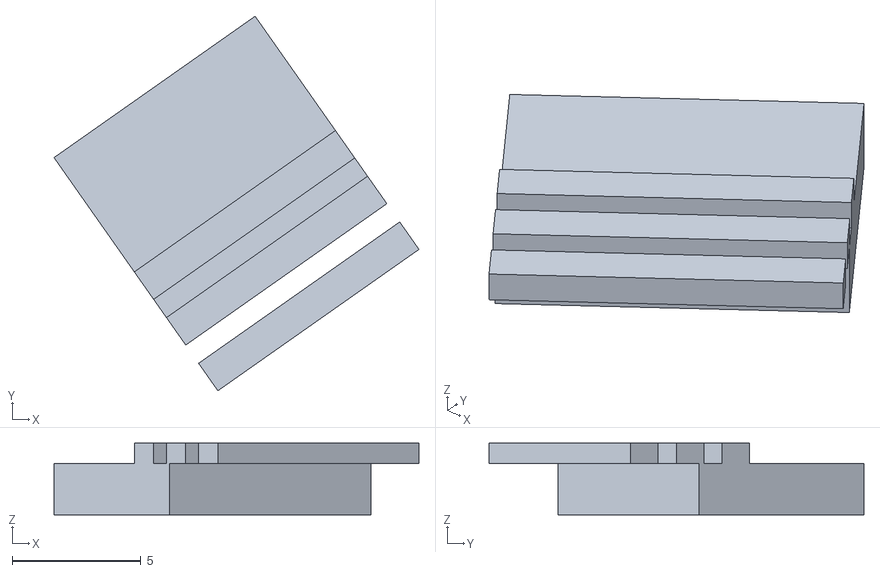
[picture p106: CAD file, 2026-10-10]
stl_hand/pinky_grip_pad.stl
14.2 x 14.6 x 2.80
