zhaoxiaofeng44/robot_arm/stl_hand/middle_p1_fork.stl

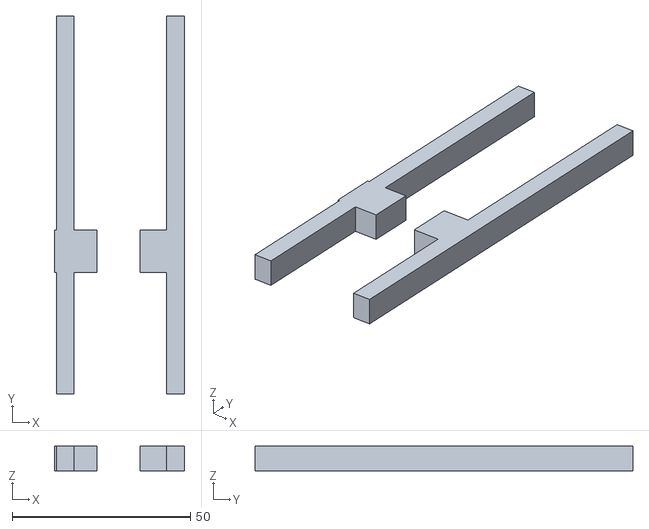
[picture p108: CAD file, 2026-10-10]
stl_hand/middle_p1_fork.stl
36.5 x 106.0 x 7.00
