zhaoxiaofeng44/robot_arm/stl_hand/palm_cross.stl

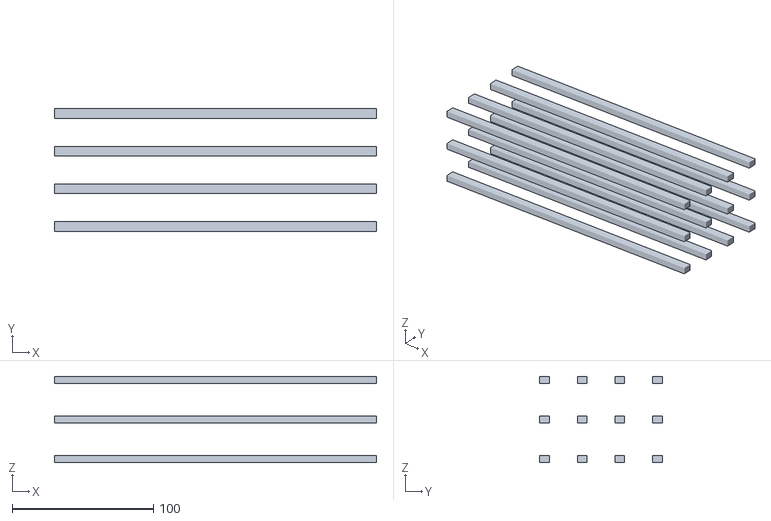
[picture p109: CAD file, 2026-10-10]
stl_hand/palm_cross.stl
228.0 x 87.0 x 61.0
