zhaoxiaofeng44/robot_arm/stl_hand/pinky_rail.stl

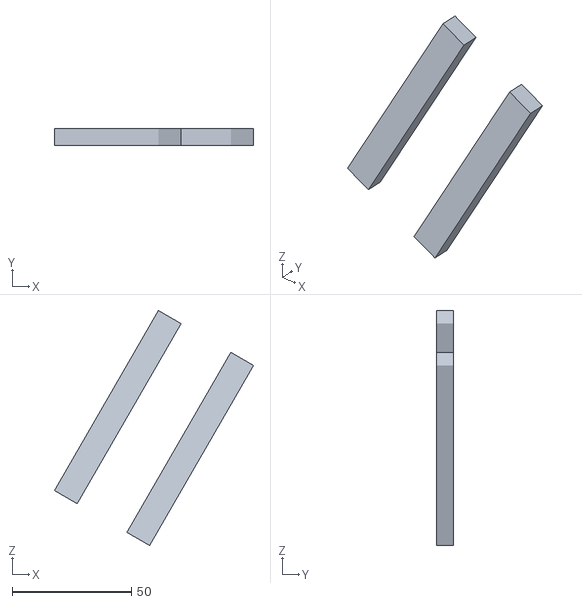
[picture p110: CAD file, 2026-10-10]
stl_hand/pinky_rail.stl
83.3 x 7.00 x 98.3
