zhaoxiaofeng44/robot_arm/stl_hand/ring_p1_distal.stl

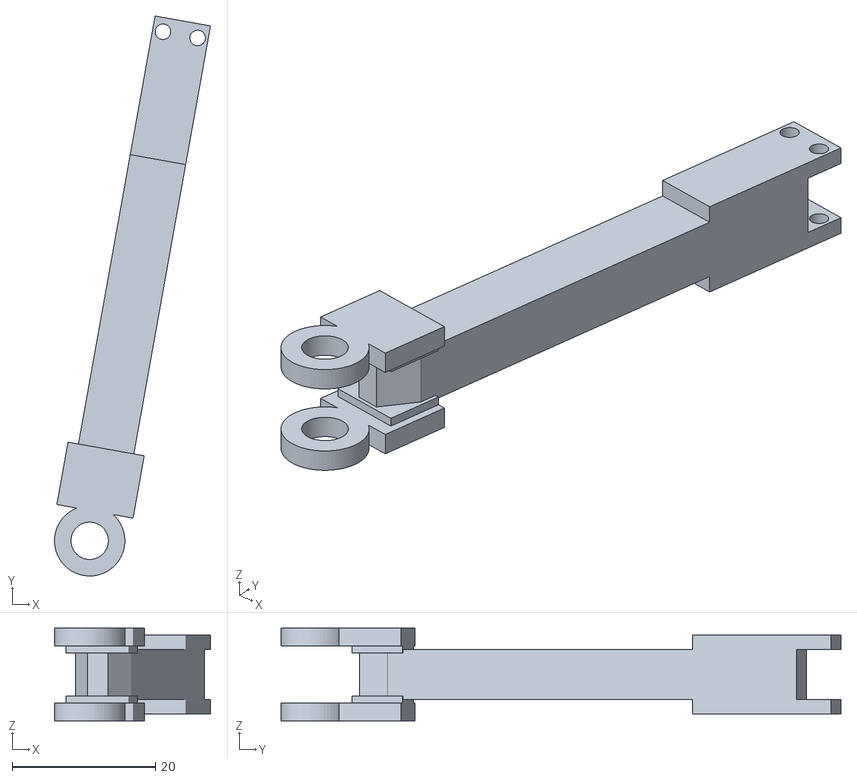
[picture p111: CAD file, 2026-10-10]
stl_hand/ring_p1_distal.stl
21.8 x 78.3 x 13.0
