zhaoxiaofeng44/robot_arm/stl_hand/ring_p2_distal.stl

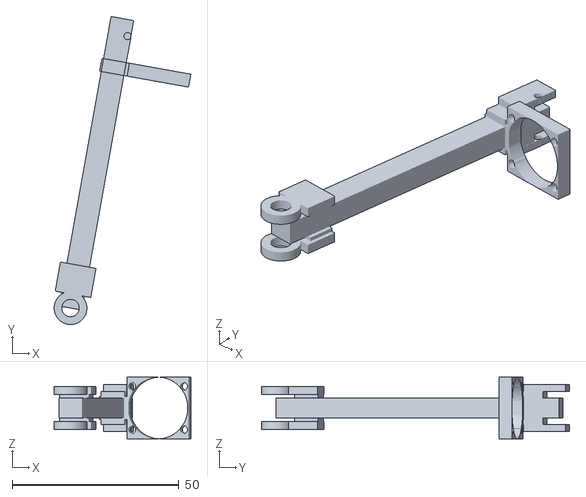
[picture p112: CAD file, 2026-10-10]
stl_hand/ring_p2_distal.stl
41.0 x 92.3 x 18.5
