zhaoxiaofeng44/robot_arm/stl_hand/middle_p1_proximal.stl

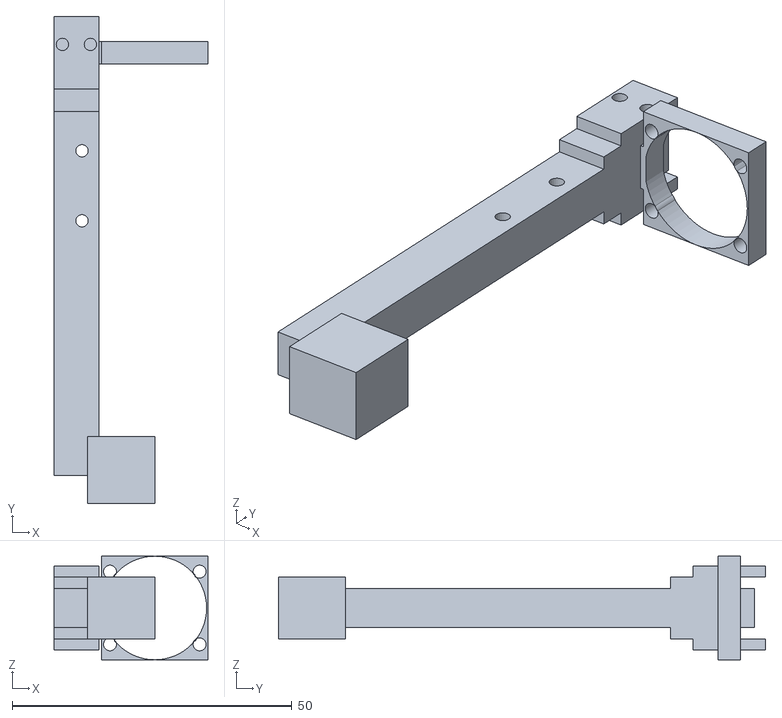
[picture p113: CAD file, 2026-10-10]
stl_hand/middle_p1_proximal.stl
27.5 x 87.0 x 18.5
