zhaoxiaofeng44/robot_arm/stl_hand/thumb_rail.stl

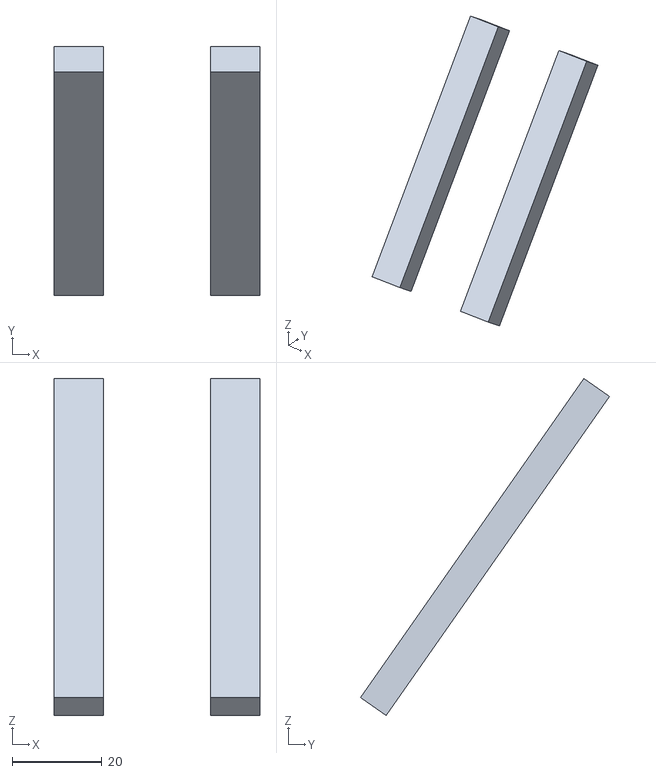
[picture p114: CAD file, 2026-10-10]
stl_hand/thumb_rail.stl
46.0 x 55.6 x 75.3
