zhaoxiaofeng44/robot_arm/stl_hand/middle_p1_distal.stl

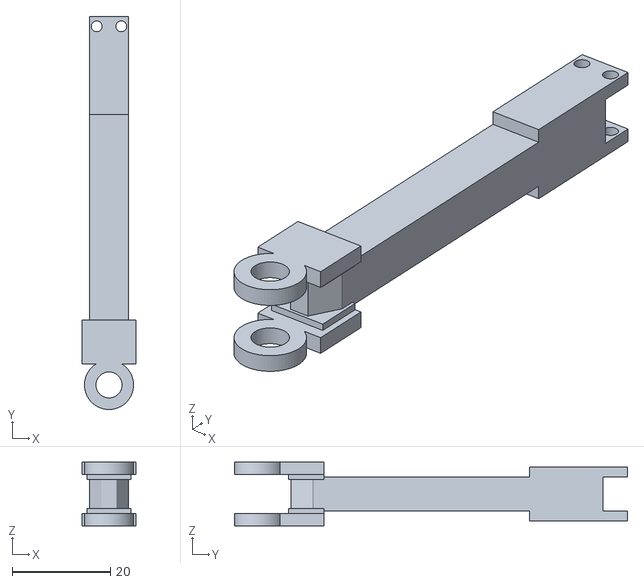
[picture p115: CAD file, 2026-10-10]
stl_hand/middle_p1_distal.stl
11.0 x 80.0 x 13.0
