zhaoxiaofeng44/robot_arm/stl_hand/thumb_b_clevis_1.stl

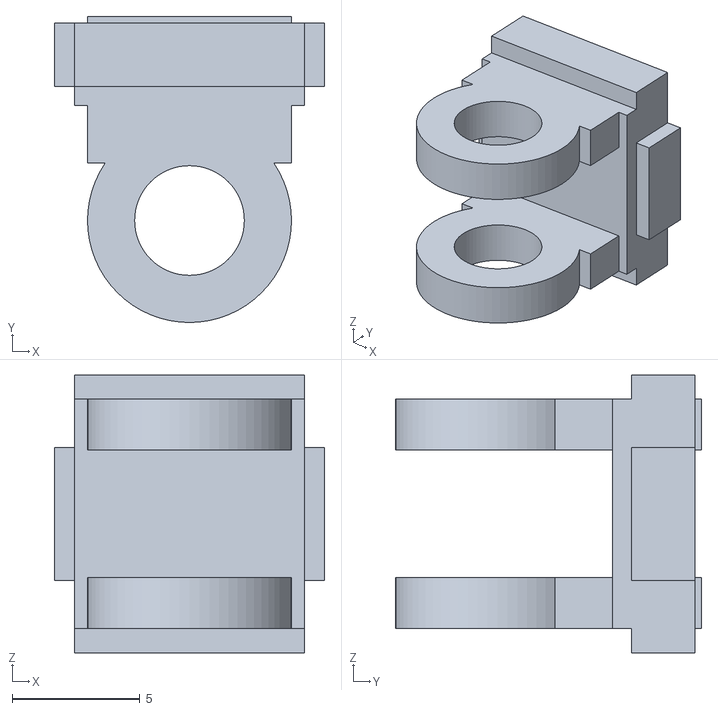
[picture p116: CAD file, 2026-10-10]
stl_hand/thumb_b_clevis_1.stl
10.6 x 12.0 x 10.9
