zhaoxiaofeng44/robot_arm/stl_hand/pinky_motor1_collar.stl

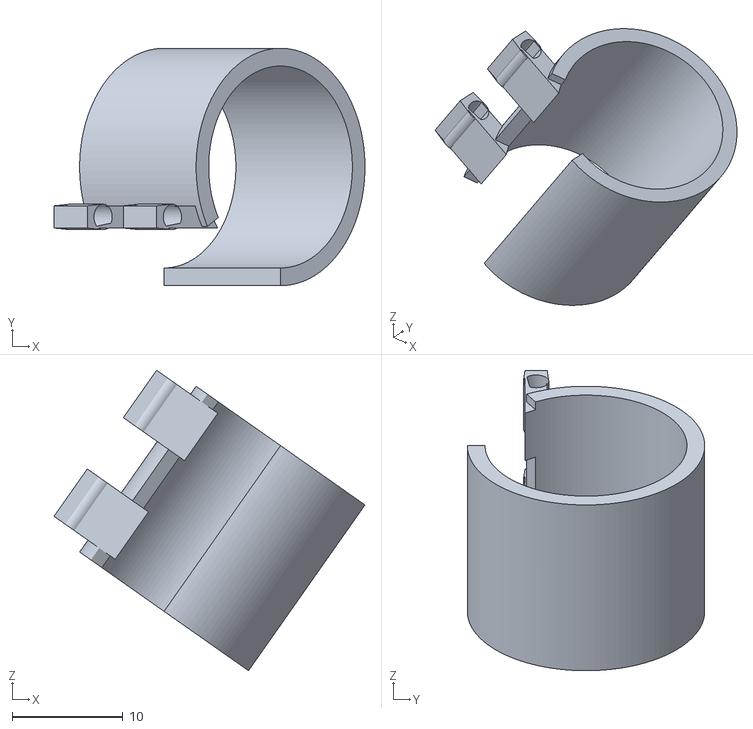
[picture p117: CAD file, 2026-10-10]
stl_hand/pinky_motor1_collar.stl
28.0 x 21.4 x 27.1
