zhaoxiaofeng44/robot_arm/stl_hand/index_p3_proximal.stl

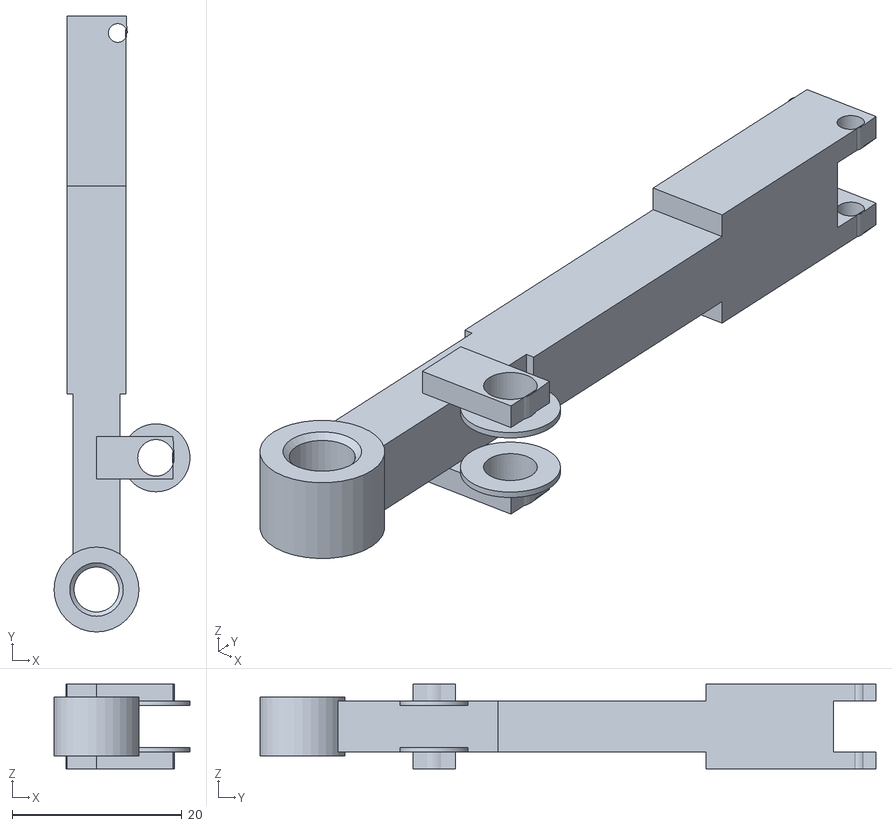
[picture p118: CAD file, 2026-10-10]
stl_hand/index_p3_proximal.stl
16.0 x 72.5 x 10.0
