zhaoxiaofeng44/robot_arm/stl_hand/thumb_p2_proximal.stl

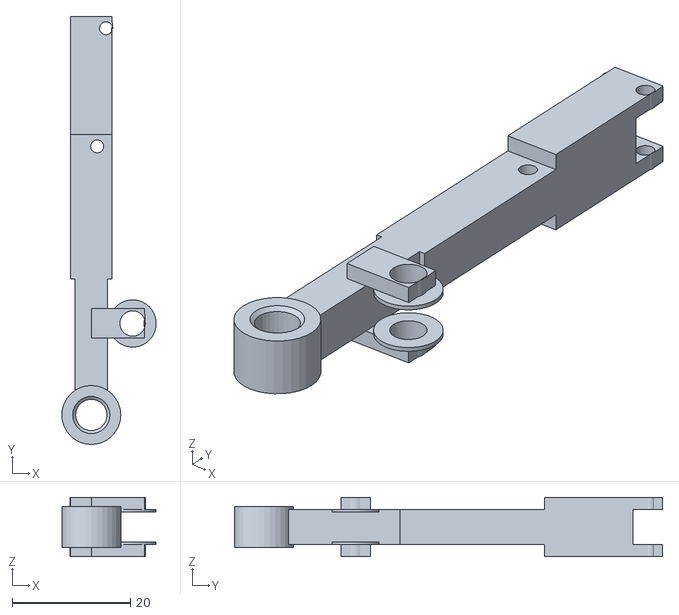
[picture p119: CAD file, 2026-10-10]
stl_hand/thumb_p2_proximal.stl
16.0 x 72.5 x 10.0
