zhaoxiaofeng44/robot_arm/stl_hand/index_rail_tie.stl

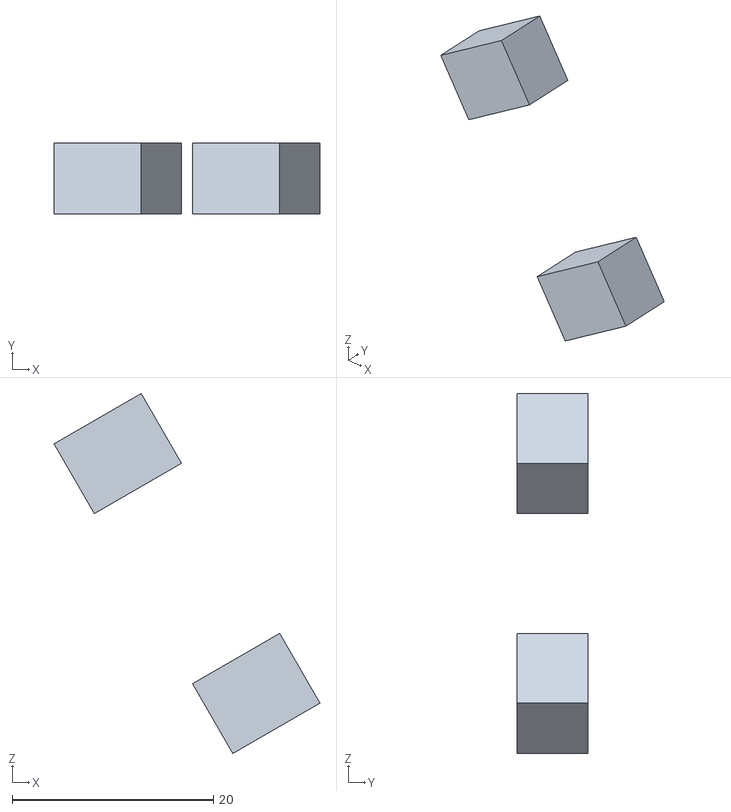
[picture p120: CAD file, 2026-10-10]
stl_hand/index_rail_tie.stl
26.4 x 7.00 x 35.7
