zhaoxiaofeng44/robot_arm/stl_hand/pinky_b_clevis_2.stl

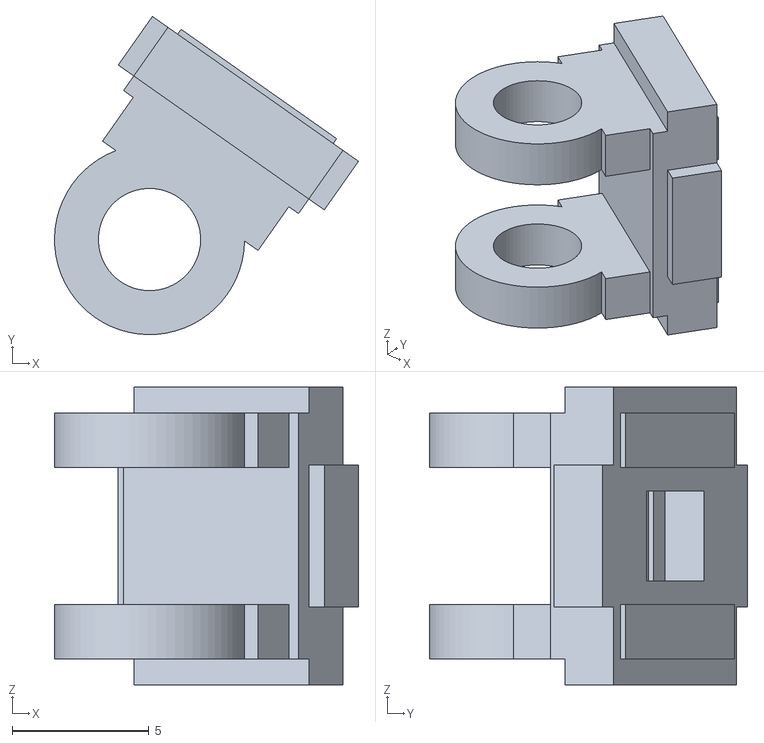
[picture p121: CAD file, 2026-10-10]
stl_hand/pinky_b_clevis_2.stl
11.1 x 11.6 x 10.9
