zhaoxiaofeng44/robot_arm/stl_hand/ring_link_1.stl

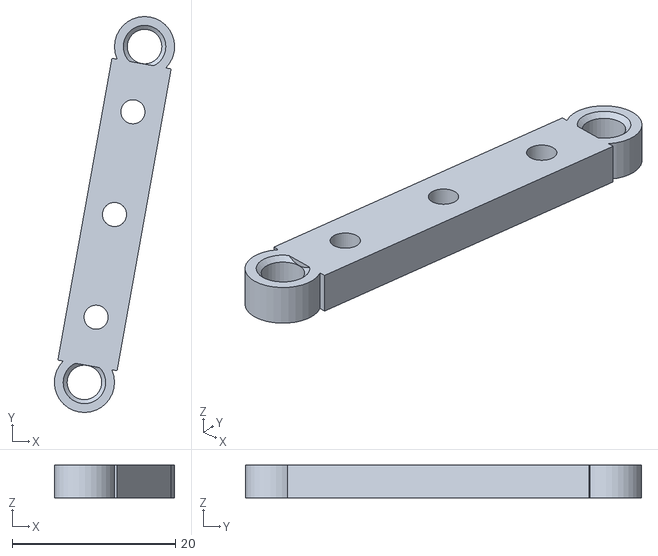
[picture p122: CAD file, 2026-10-10]
stl_hand/ring_link_1.stl
14.8 x 48.6 x 4.00
