zhaoxiaofeng44/robot_arm/stl_hand/index_grip_pad.stl

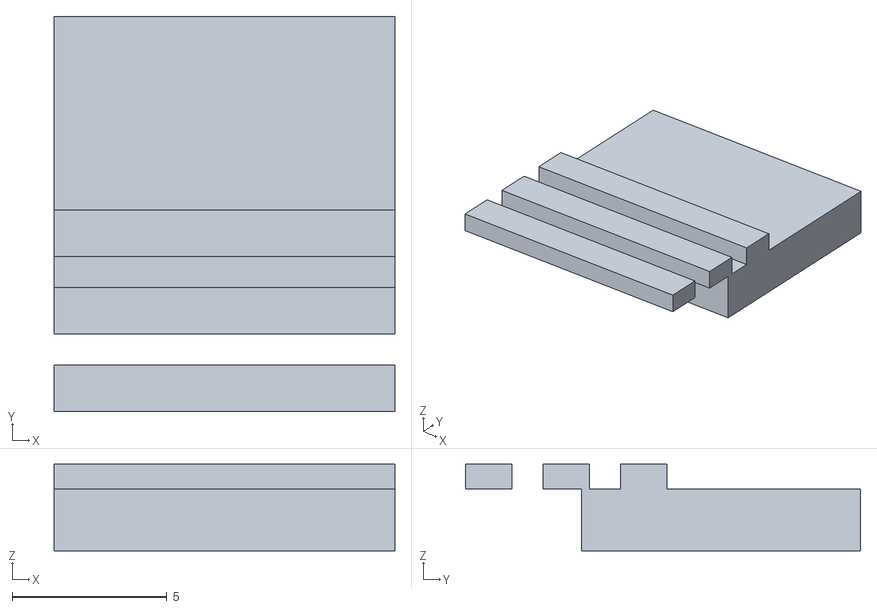
[picture p123: CAD file, 2026-10-10]
stl_hand/index_grip_pad.stl
11.0 x 12.8 x 2.80
