zhaoxiaofeng44/robot_arm/stl_hand/ring_p3_distal.stl

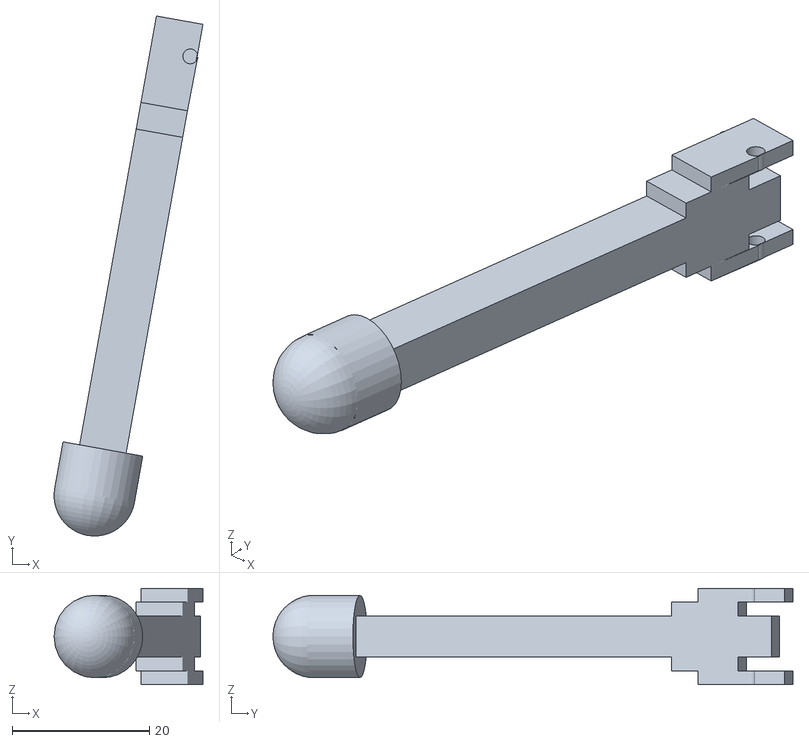
[picture p124: CAD file, 2026-10-10]
stl_hand/ring_p3_distal.stl
21.7 x 75.8 x 14.0
