zhaoxiaofeng44/robot_arm/(list of files, cad)

Other CAD files:
stl_finger/link_2.stl
stl_hand/chassis_thumbFlap.stl
stl_finger/b_clevis_2.stl
stl_hand/finger_palm_distal.stl
stl_hand/finger_palm_mount.stl
stl_finger/p3_proximal.stl
stl_hand/finger_bd_link.stl
stl_hand/finger_b_clevis.stl
stl/rivetB.stl
stl_finger/p3_distal.stl
stl_hand/finger_phalanx_proximal.stl
stl_hand/finger_motor_collar.stl
stl_finger/motor1_collar.stl
stl_hand/finger_terminal_proximal.stl
stl_finger/p2_distal.stl
stl_hand/finger_phalanx_distal.stl
stl_finger/p1_proximal.stl
stl_hand/finger_grip_pad.stl
stl_hand/pinky_knuckle_seat.stl
stl_hand/index_link_2.stl
stl_hand/middle_link_2.stl
stl_hand/index_rail.stl
stl_hand/ring_rail_tie.stl
stl_hand/middle_rail.stl
stl_hand/pinky_rail_tie.stl
stl_hand/index_link_1.stl
stl_hand/middle_knuckle_seat.stl
