zhaoxiaofeng44/robot_arm/hand_assembly_guide.md

# 五指整手 装配与拆解指南

> 模型：`hand_mechanism_3d.html`（唯一几何真源）；本文所有尺寸均从模型实测，单位 mm。
> 尺度：**1:1 与手指版同尺寸**（掌段 300 + 300/300/250），整手为机构级概念模型，非人体尺度。
> 整手 = 五指各 3 屈曲关节 = **15 台屈曲直线电机 + 5 台横向电机**（四指=指根展开/并拢；**拇指=掌fold对掌：掌板A分固定半+转动半，掌侧横向电机折叠转动半带动整个拇指扫向掌心**）。
> 五指机构平面互相平行（指距 70mm）；**反根装配**：每指把「原指尖段 Pn」当作接掌固定段，
> 其远端法兰用 4×M5 螺栓固定在 66×10 掌骨板上；自由端 = 原指根端的掌段（带 Ø24 圆头/防滑垫）= 现在的指尖。

## 零件清单

### 打印件（合计 101 件 = 五指 5×19 + 掌体骨架 6）

| 件号 | 数量 | 说明 |
|---|---|---|
| `finger_palm_proximal` | 5 | 掌段·自由端外段（含电机0法兰安装板 + 反根后的 Ø24 圆头/半球垫，与掌段本体在 y=140 拼接） |
| `finger_palm_distal` | 5 | 掌段·关节0端段（含一体化叉耳；反根后它是可动自由端） |
| `finger_phalanx_proximal` | 10 | 近节/中节·关节端段（含袖套/毂 + D 侧板叉耳，拼接 y=−170）；**P1≡P2 同件** |
| `finger_phalanx_distal` | 10 | 近节/中节·远端段（含一体化叉耳 + 电机法兰安装板）；**P1≡P2 同件** |
| `finger_terminal_proximal` | 5 | 末节·关节端段（拼接 y=−125）；**五指 P3 同件**；反根后本段是接掌固定段 |
| `finger_terminal_distal` | 5 | 末节远端段（无电机；**含指根方块**，掌骨法兰挂其端面） |
| `finger_motor_collar` | 15 | 电机后抱箍（开口 300°，2×M4 贯穿所在段） |
| `finger_b_clevis` | 15 | B 推杆叉头（双耳 + M6 螺母沉龛夹持桥） |
| `finger_bd_link` | 15 | BD 等宽长条连杆 100×15×8 |
| `finger_palm_mount` | 5 | 掌骨安装法兰 56×56 R8（内圈 4×Ø4.4 + 外圈 4×Ø5.5 + Ø9 走线） |
| `finger_grip_pad` | 5 | 指尖防滑抓握垫（TPU95A 更佳） |
| `chassis_palmPlateA` | 1 | 掌骨板A·固定半 66×10（z∈[−150,−55]）：食指指根接口；分缝 z=−150 装 Ø10 掌fold铰链 |
| `chassis_thumbFlap` | 1 | 拇指掌板·转动半 66×10（z∈[−253,−150]）：拇指指根接口；掌侧横向电机折叠带动整个拇指对掌 |
| `chassis_palmPlateB` | 1 | 掌骨板B 66×10（z∈[−55,153]）：中指 + 无名指 + 小指 |
| `chassis_palmSpliceTop` | 1 | 顶部拼接条 6mm（跨分缝，4×M5 自下而上把板A/板B 拉成一体） |
| `chassis_wristBlock` | 1 | 腕拼接块（含 4×Ø14×6 凸台一体打印） |
| `chassis_thumbBridge` | 1 | 拇指桥（含 4×Ø14×10 凸台一体打印） |

同规格件几何**逐件完全相同**（`verify_hand.cjs` 的可互换性检查逐件比对局部顶点集），因此同一 STL 打印 N 份即可。

### 外购标准件（13 项）

| 件号 | 规格 | 数量 | 用处 |
|---|---|---|---|
| shoulderBoltO10x26 | 肩螺栓（塞打螺丝）Ø10 h9×26，端部 M8 | 15 | 15 个单元的 O 转动副 |
| shoulderBoltB8x18 | 肩螺栓 Ø8 h9×18，端部 M6 | 15 | B 推杆叉头销轴 |
| shoulderBoltD8x20 | 肩螺栓 Ø8 h9×20，端部 M6 | 15 | D 连杆销轴 |
| rodNutM6 | M6 六角螺母 | 15 | 推杆端部夹持（沉入 B 叉头沉龛） |
| washerO | 平垫 Ø10.5/Ø16×1.6 | 15 | O 关节螺母侧 |
| washerBD | 平垫 Ø8.4/Ø12×1.6 | 30 | B/D 关节螺母侧 |
| nylocNutM8 | M8 尼龙自锁螺母 AF13 | 15 | O 肩螺栓 |
| nylocNutM6 | M6 尼龙自锁螺母 AF10 | 30 | B/D 肩螺栓 |
| boltM4x22 | M4×22 + 平垫 + M4 自锁螺母 | 30 | 电机后抱箍贯穿所在段（每台 2 组） |
| boltM4x16 | M4×16 内六角 | 60 | 电机前法兰旋入安装板（每台 4 根） |
| boltM4x36 | M4×36 + 平垫 + M4 自锁螺母 | 40 | 各段一体化拼接凸台（每处 2 根，共 20 处 = 五指 × 4 段） |
| boltM5x20 | M5×20 内六角 | 20 | 指根法兰外圈 4×Ø5.5 → 掌骨板 M5 螺孔（每指 4 根） |
| boltM5x16 | M5×16 内六角 | 10 | 顶部拼接条 4 + 拇指桥 2 + 腕块 4 |

## 装配顺序

### 第 0 步：掌体骨架（整手的定位基准）
1. 掌骨板A、板B 平放，**顶面朝上**（顶面 = y=336 面，指根接口孔在板厚内）；在 z=−55 分缝处对拼接条 `palmSpliceTop`。
2. 4×M5×16 **自下而上**穿过掌骨板（Ø5.5 过孔，位于 z=−58/−52 的无指根法兰空档），旋入拼接条 Ø4.2 攻丝孔 → A/B 拉成一体。
3. 放 4 个 Ø14×6 凸台（已随腕块一体打印）对准板上 (±20,−135)/(±20,15) 的 M5 孔，盖上腕拼接块，4×M5×16 自腕块顶面旋入掌骨板。
4. 拇指桥（含 4×Ø14×10 凸台）压在掌骨板A 上，2×M5×16 自桥面旋入板A 的 (±20,−165) 攻丝孔。
> 骨架完成后应是一个刚性平板：所有指根接口的 Ø9 让位孔朝上、M5 螺孔朝下（朝向指根法兰）。
> 反根装配下这些接口由**每指末端段 Pn 的远端**从下方对接，孔位与旧版逐孔相同。

### 第 1 步（每指 ×5）：先把指骨链拼成整体
每条指骨段 = 关节端段 + 远端段，用 2×M4×36 穿过两段的一体化拼接凸台（+平垫+自锁螺母）夹紧：
- 掌段拼接 y=140，近节/中节拼接 y=−170，末节拼接 y=−125；
- 装配时保证段两端 Ø10.6/Ø8.6 销轴孔同轴（先穿一根 Ø8 光杆定位再拧紧）。

### 第 2 步（每指）：关节装配（与手指版逐项相同）
每个关节单元：把上一段的叉耳套住下一段的袖套/毂（O 关节）与 D 侧板（D 关节），插入肩螺栓：
- O：Ø10 肩螺栓 + 平垫 + M8 自锁螺母（耳内档 16 − 袖套 14 = 1mm/侧浮动）；
- D：Ø8×20 肩螺栓（含 1mm 凸台）+ 平垫 + M6 自锁螺母（耳内档 10 − 连杆 8 = 1mm/侧浮动）；
- B：Ø8×18 肩螺栓穿过 B 叉头双耳与连杆 B 端孔，M6 自锁螺母 + 平垫；
- 电机推杆端部：M6 螺母沉入 B 叉头沉龛后与推杆螺纹咬合（先手动推到行程中位再锁）。
电机（Ø36×80）用后抱箍（2×M4×22 贯穿所在段）+ 前法兰（4×M4×16 旋入该段安装板）固定，抱箍内径 = Ø36+0.2 夹持间隙。

### 第 3 步：手指上掌
- 四指：把每指的掌骨安装法兰外圈 4×Ø5.5 对准掌骨板的 M5 螺孔，4×M5×20 **自法兰下方**（指根方块侧面空档）向上旋入掌骨板；
  指根方块顶面的 4×M4×16 螺栓头正好落进掌骨板的 4×Ø9 让位孔（孔与螺孔同心）。
- 拇指：4×M5×20 自拇指法兰下方穿过法兰 Ø5.5 → Ø14×10 凸台 → 旋入拇指桥的攻丝孔。
- 紧固顺序：先中间（中指/无名指）后两侧，最后拇指；不要一次锁死，逐指交替拧紧以防板件翘曲。
- **反根提示**：法兰与指根方块挂在接掌固定的末端段 Pn 远端，自由端是掌段。每指的电机 k 与连杆 k
  都随**本段**安装（电机 k 绕本段远端关节 Ok 带动本段自身），所以装完接掌端后，再沿链条向自由端
  逐段装 P(n−1) … P1、掌段；掌段是最后一节，其外端即带圆头/防滑垫的指尖。

### 第 4 步：限位与调试
- 网页滑杆上限即安全包络：**五指 90°/90°/70°**；控制器下位机必须写入同样的软限位。
- 上电前手动把每指推到 0 位（各段共线）并确认推杆处于 `s_extended=136.7` 的伸出位。
- 逐关节单独动作，确认配合区内（销轴孔半径 +0.6mm）无干涉；再按等比抓握 u=0→1 走一遍。

## 拆解顺序（与装配互逆，任一零件均可单独更换）
1. 整指取下：旋下该指掌骨法兰的 4×M5，整指连同末端一起抽出（其余手指不动）。
2. 关节拆开：旋下自锁螺母 → 抽出肩螺栓 → 连杆/指节沿 Z 滑出（无需拆电机）。
3. 电机更换：松开前法兰 4×M4 + 抱箍 2×M4，电机整体上抽（推杆仍连着连杆时先拆 B 销）。
4. 末节/指尖垫：拆末节拼接 2×M4×36 或直接更换抓握垫。
5. 掌体骨架：取下全部手指后，旋下拇指桥 2×M5、腕块 4×M5，最后旋下拼接条 4×M5 分成板A/板B。

## 力矩与防松
| 紧固点 | 建议力矩（PETG/PLA+ 塑料件，钢制螺钉） | 防松 |
|---|---|---|
| M4×16 电机前法兰（旋入塑料安装板） | 1.2–1.5 N·m（勿超，建议配 M4 热熔螺母） | 中强度螺纹胶 |
| M4×22 抱箍贯穿 | 1.5 N·m | 尼龙自锁螺母 |
| M4×36 分段拼接 | 1.5 N·m | 平垫 + 尼龙自锁螺母 |
| M5×16 / M5×20 骨架与指根 | 2.5–3.0 N·m | 中强度螺纹胶 |
| O 肩螺栓 M8 自锁螺母 | 4–6 N·m（调整到关节可自由摆动无轴向窜动） | 尼龙自锁螺母 |
| B/D 肩螺栓 M6 自锁螺母 | 2–3 N·m | 尼龙自锁螺母 |
> **重要**：M8/M6 自锁螺母只锁到「消除轴向间隙但关节仍能自由摆动」，过度拧紧会压弯叉耳（耳片壁厚 5mm）。

## 打印注意
- 全部零件按模型内姿态出档（销轴孔轴 = Z 竖直，落地 z=0），**免支撑**；
- 材料：指节/叉头/抱箍/骨架 PETG 或 PLA+（层高 0.2、壁厚 4 层、填充 30–40%）；连杆 PETG/PA-CF（受力件，建议 4 层壁）；指尖垫 TPU95A；
- 销轴孔（Ø10.6 / Ø8.6）与电机抱箍内孔打印后需用铰刀或钻头手动过一遍，保证 1mm/侧的轴向浮动不被毛刺吃掉；
- 掌骨板A/B 与拼接条为 198/208/50mm 长件，需 220mm 以上打印床；若床面不足，可沿 z 再分一件（接口沿用 Ø5.5+M5 螺孔布置）。
- 装配前把所有 M5 螺孔用丝锥过一遍（打印孔收缩会明显变紧）。

## 已知装配干涉提示
- 指根法兰 4×M5 的螺栓头位于法兰**下方**（y≈316–320），空间只容一个薄壁套筒；相邻手指机构平面间距 70mm，扳手需从斜下方伸入；
- 中指/无名指之间、无名指/小指之间同理；建议先装两侧再装中间；
- 顶部拼接条 4×M5 从掌骨板**下方**穿入（该处 z 空档无指根法兰，正好留给套筒）；
- 拇指桥 4×M5 自拇指法兰下方穿入，需先放 4 个凸台再压桥；拇指在掌骨板最外端（z=−220），扳手从 −z 侧伸入最方便，建议拇指最后装。

## 与手指版的关系
关节单元、分段拼接、电机抱箍/法兰、指尖几何与 `finger_mechanism_3d.html` **逐件相同**（仅多出掌体骨架与五指布局），
因此手指版的装配步骤 1–2、力矩表、打印注意可原样复用；整手增加的只有第 0、3 步。

**第 6 步（新增）· 横向摆/掌fold对掌副装配**：四指为指根展开/并拢副（±5°）；**拇指为掌fold对掌副**——掌骨板A 已在 z=−150 分成固定半（食指侧）与转动半 `thumbPalmFlap`（载拇指桥与整个拇指）：
先装固定侧 —— Ø10 肩螺栓穿过两片叉耳（x=±24，与固定半掌板一体）+ 电机吊柱 + Ø36 横向直线电机（机构平面 x=+40）；
再装转动侧 —— 毂（Ø10 孔）套进叉耳、推入 Ø10 锁上自锁螺母，毂上曲柄臂 + D 双耳（Ø8 销）；85mm BD 连杆一端接电机推杆 B 叉头（Ø8 B 销），另一端接转动侧 D 双耳。
**对掌行程**：负角（−12°，配合屈指握姿）把整个拇指横向扫向掌心/食指侧；四指伸直单独折叠限 −3°（拇指杆会从食指侧面扫过）。
