zhaoxiaofeng44/robot_arm/finger_assembly_guide.md

# 掌 + 三节手指 装配与拆解指南

工具：**2.5 / 3 / 4 / 5 / 6mm 内六角扳手 + 13 / 10 / 7mm 叉扳手（或套筒）**。
紧固件全部外购 304 不锈钢（清单见 `stl_finger/index.json` → `purchased_parts_bom`）。
**三个关节单元用同一套关节方案；P1 与 P2 段逐件同几何、零件可互换**（袖套/叉耳板/连杆/抱箍/耳座/D 侧板/段体/安装板 已用几何签名校验一致）。

## 零件清单

**打印件（19）**
| 件 | 数量 | 说明 |
|---|---|---|
| palm_proximal | 1 | 掌·法兰端段（指根方块 + 电机0法兰安装板） |
| palm_distal | 1 | 掌·关节0段（一体化叉耳） |
| p1_proximal | 1 | 近节·关节0端段（袖套/毂 + D侧板叉耳） |
| p1_distal | 1 | 近节·关节1端段（叉耳 + 电机1法兰安装板） |
| p2_proximal | 1 | 中节·关节1端段（与 p1_proximal 同件，可互换） |
| p2_distal | 1 | 中节·关节2端段（与 p1_distal 同件，可互换） |
| p3_proximal | 1 | 远节·关节2端段（袖套/毂 + D侧板叉耳） |
| p3_distal | 1 | 远节·指尖段（末端法兰 + 指尖圆头） |
| motor0/1/2_collar | 各1 | 电机后抱箍（300° 开口，三个同规格） |
| b_clevis_0/1/2 | 各1 | B 推杆叉头（含 M6 螺母沉龛，三个同规格） |
| link_0/1/2 | 各1 | BD 等宽长条连杆 15×100×8（腹板 3×Ø6 减重孔，三个同规格） |
| palm_mount | 1 | 掌骨安装法兰（56×56×6 圆角方板，底面坐指根方块顶面 y=320） |
| grip_pad | 1 | 指尖防滑抓握垫（垫板 + 3 条横向防滑棱） |

**外购件（三个单元合计）**：Ø10×26 肩螺栓 ×3（O0/O1/O2）、Ø8×18 ×3（B0/B1/B2）、Ø8×20 ×3（D0/D1/D2）、M6 沉龛螺母 ×3、M8 自锁螺母 ×3、M6 自锁螺母 ×6、平垫（Ø16 ×3 / Ø12 ×6）、M4×22+自锁 ×6（抱箍）、M4×16 ×16（三处电机法兰 ×12 + 掌骨法兰板 ×4，建议配 M4 热熔螺母）、M4×36+自锁 ×6（掌/P1/P2 三处拼接，每处 2 根）、M5×16 沉头 ×4（掌骨法兰外圈→手掌球窝）。

## 装配顺序

0. **掌部预装（可选）**：`palm_mount` 的 4 个内圈孔对准指根方块 4 个 Ø3.4 底孔，4×M4×16 自上而下拧入（穿板 6 + 入方块 10），板底与方块顶面 y=320 贴合；外圈 4×Ø5.5 留给手掌球窝的 M5×16 沉头，Ø9 中心孔走线。

1. **三段拼装成骨**（每段都是一个完整单元的一半）
   - 掌段：`palm_distal` + `palm_proximal` 沿搭接凸台对接（拼接线 y=140），2×M4×36 竖向（孔轴沿 Z）穿过，平垫+自锁螺母紧固；
   - P1：`p1_proximal` + `p1_distal` 在 **y=−170** 拼接，同法 2×M4×36；
   - P2：`p2_proximal` + `p2_distal` 同法（与 P1 同件同工）；
   - P3：`p3_proximal` + `p3_distal` 在 **y=−125** 拼接，同法 2×M4×36。

2. **装电机 0（在掌段上）** — 此时关节0 尚未合拢，空间最宽裕
   - 缸体从掌段指根方向轴向穿入后抱箍（抱箍开口朝臂侧，不影响轴向装入）；
   - 前端法兰落到安装板下平面，4×M4×16 自下向上旋入（先装 M4 热熔螺母更稳）；
   - 2×M4×22 贯穿抱箍双侧耳板与掌段侧面，平垫+自锁螺母锁紧。

3. **装 B 叉头 0 + 推杆连接**
   - M6 螺母旋上推杆端部螺纹（≈5mm），螺母要**坐在夹持桥底板上**、被四周围壁包住（六角面防转）；推杆端面停在底板上方 0.5mm。此连接靠螺纹副+螺母防转承受**拉力**（屈指工况），靠底板承受压力（伸指工况）。
   - 叉头自上而下套入，推杆螺纹穿过沉龛底孔、螺母落入六角沉龛（六角面朝 ±z，天然防转）。

4. **合关节0（沿 Z 装配）**
   - P1 的 `p1SleeveBody`（Ø20×14 袖套）插入掌段叉耳内档；
   - `link_0` 竖直（z 向）就位：B 端对入 B 叉头双耳、D 端对入 P1 的 D 侧板双耳（两处内档均 10mm，连杆 8mm，直落）；
   - **O0**：Ø10×26 肩螺栓穿入 → 平垫 + M8 自锁螺母；
   - **B0**：Ø8×18 → 平垫 + M6 自锁螺母；**D0**：Ø8×20 → 同法（两侧 1mm 凸台自动定浮动）。

5. **装电机 1（在 P1 上）+ 合关节1** — 与第 2/3/4 步完全同法：电机1 装在 P1 的关节1端段（P1 此时已能整体摆动，可先摆到方便操作的姿态），B 叉头 1 接推杆，P2 袖套插入 P1 叉耳，`link_1` 沿 Z 落入，锁 O1（Ø10×26）、B1（Ø8×18）、D1（Ø8×20）。

6. **装电机 2（在 P2 上）+ 合关节2** — 同法：P3 的袖套插入 P2 叉耳，`link_2` 沿 Z 落入，锁 O2 / B2 / D2。

7. **自检**：手动摆动 θ0/θ1/θ2 各自 0→上限（**90°/90°/70°**，见 `finger_design_spec.md` 安全行程包络）全程无卡滞；三处销轴轴向窜动约 1mm/侧属设计浮动；包络内指尖不应与掌段/电机发生接触（`verify_finger.cjs` 已在 76176 姿态上校验）。

## 拆解顺序（与装配互逆，均可单独更换部件）

1. **换连杆**：对应关节旋下 B/D 自锁螺母 → 抽出肩螺栓 → 连杆沿 Z 滑出。
2. **换指节**：旋下该关节 O 螺栓 → 指节沿 Z 抽出（P3 可整段取下；P2 需先断开电机2 抱箍的 2×M4 与法兰 4×M4，掌段上的 P1 同理需先断电机1）。
3. **换电机**：卸 4×M4 法兰螺栓 → 轴向抽出缸体（穿过抱箍）；再卸 2×M4 取下抱箍。
4. **换 B 叉头**：旋退沉龛内 M6 螺母，叉头即脱离推杆螺纹。
5. **分段**：卸拼接凸台 M4×36。

> 沉龛内 M6 螺母旋离推杆后可能留在龛内（六角防转），倒出即可，不会掉进机构内部。

## 力矩与防松

| 部位 | 紧固件 | 建议力矩 | 防松 |
|---|---|---|---|
| O0 / O1 / O2 | Ø10×26（M8） | 15–20 N·m（以压平垫、不陷胶为准） | 尼龙自锁螺母 |
| B / D | Ø8×18 / Ø8×20（M6） | 8–10 N·m | 尼龙自锁螺母 |
| 抱箍 | M4×22 | 2.5–3 N·m | 尼龙自锁螺母 |
| 电机法兰 | M4×16 | 2.5–3 N·m | 热熔螺母 / 螺纹胶 |
| 拼接 | M4×36 | 2.5–3 N·m | 尼龙自锁螺母 |

尼龙自锁螺母反复拆装 ≥10 次后锁紧力衰减，建议更换。

## 打印注意

- `palm_proximal`、`p1_proximal`、`p2_proximal`、`p3_proximal` 建议**绕 X 翻转 180°** 打印（D 侧板/耳片朝下落床，免支撑）；
- 抱箍 STL 已按**孔轴竖直**姿态导出，直接打印；
- 连杆 STL 长轴已摆正（15×100×8），平躺打印；
- 安装板 Ø36.4 导向孔为水平孔，切片时开支撑或用泪滴形手修；
- B 叉头沉龛顶面为 10mm 桥接（切片器默认可桥）；
- `palm_mount` 已按**板面落床、止口朝上**姿态导出（rotX90），直接打印免支撑；
- `grip_pad` 绕 X 翻转 180° 平躺打印；柔性材料（TPU95A）防滑更佳，PLA+/PETG 亦可。

> 预览图（`preview/finger_*.png`，13 张）已按三关节版本重新生成，见 `finger_design_spec.md` 末节。
