zhaoxiaofeng44/robot_arm/3d_print_optimization.md

# 3D打印优化说明 v5 — 连接可拆化重构

本文件记录针对**每个连接处**的 3D 打印（FDM）适配改造与 v4→v5 变更。运动学参数（上臂/前臂长度、电机安装点 A、BD 中心距 85mm、D 点位置）全部保持不变，0～120° 运动关系与工作行程 59.393mm 不受影响。

**v5 主题：关键连接容易拆解、逻辑成组件。** 代价是打印件从 7 件增加到 **7 件打印 + 11 项外购标准件**（v4 为 7 打印 + 3 铆钉 + 6 M4），但整机可用一套内六角扳手反复拆解为独立组件。

| | v4（一体化铆接版） | v5（可拆肩螺栓版） |
|---|---|---|
| 关节紧固 | 3 根单件肩铆钉（现场镦尾，**永久**） | **3 套外购肩螺栓+平垫+尼龙自锁螺母**（全可拆） |
| BD 连杆 | 狗骨形（8×8 杆身+Ø17 环眼） | **等宽长条 100×15×8**（用户要求） |
| B 叉头 | 桥板穿过连杆扫掠圆（实体干涉） | 开放双耳+螺母沉龛夹持桥（零干涉） |
| D 叉耳 | 桥板+悬臂，桥板与连杆眼干涉 | 贴臂身侧板×2（连杆 z 带之外） |
| 电机安装 | 320° C 形环鞍座（Ø36 径向卡入不可行）+ 脊板与臂身干涉 | **前法兰承推（安装板一体）+ 300° 开口抱箍（轴向装入）** |
| 电机缸体 | Ø36×90 | **Ø36×80**（行程/力不变；给 B 叉头让出装拆空间） |
| 轴向浮动 | 0.5mm/侧 | **1.0mm/侧**（便于拆装） |
| 打印件 | 7 件 | **7 件**（+外购 11 项） |

## 一、统一制造原则（v5）

| 原则 | 取值 | 理由 |
|---|---|---|
| 销孔配合间隙 | 单边 **0.3mm**（Ø10→Ø10.6，Ø8→Ø8.6） | FDM 竖直孔可转动配合经验值 |
| 孔口导入倒角 | **45°×1.0mm**（轴套/连杆端环旋转成型自带） | 免刮蹭、免手工铰孔 |
| 孔轴方向 | 全部 **沿 Z（=打印方向）** | 竖直孔免支撑；**销轴沿打印方向插拔=装配方向** |
| 最小壁厚 | **≥3.0mm**；孔壁实测 O 耳 4.7 / 轴套 4.7 / B/D 3.7 / 连杆端 3.2mm | 0.4mm 喷嘴 ≥3 圈 |
| 轴向浮动 | 每侧 **1.0mm** | 耳内档/定位凸台保证，不夹死中置件，且便于滑入滑出 |
| 层高 / 填充 | 0.2mm / 关节与连杆 100%，臂身 25–40% | 层间不受剪（连杆平躺） |

## 二、逐项连接处改造（v5）

### O 肘
- 轴套 Ø22×15 → **Ø20×14**：给等宽长条连杆让出回转间隙（θ=0 处 1.4mm）；内档 16=14+2×1.0。
- 前臂顶端开 **R5.4 半圆缺口**，销轴贴臂通过（消除 v4 销轴嵌入臂身 5mm 的隐性干涉）。
- 新增 Ø19 内毂连接轴套与臂身；轴套整体可沿 Z 更换。

### B 推杆叉头（独立打印件 rodClevis）
- 双耳板 z=±5..9（连杆 z 带 |z|≤4 之外）+ 夹持桥 y=9..16（连杆端部扫掠圆外 1.5mm）。
- 沉龛内档 **10.8×12.4×6mm**（M6 螺母对边 10 / 对角 11.55，四周留 0.4/0.43 间隙）内嵌 M6 螺母；螺母**坐底板顶面**、围壁完整包住螺母六角面（防转），拉力靠螺纹副+防转传递、压力由底板承担；龛顶 10mm 桥接打印。
- 推杆端面停在底板顶面上方 0.5mm、螺母坐在底板顶面，因此**底板不必开孔**（原"底孔 Ø6.2"已取消）。

### D 前臂叉耳（与前臂上段一体）
- 双侧板 z=±6..10 贴臂身侧面熔合；内侧 Ø16×1mm 凸台定 1.0mm 浮动。
- 前臂杆身 y=0..−46 收窄 ±5.5（连杆扫掠圆外 1.0mm），跟部恢复 ±7；矩形分段外形使**凸包投影核验真实**（`verify_near_joint` 收紧到孔半径+0.6mm 后仍 0 碰撞）。

### 电机安装
- 安装板（上臂近端一体）：颈部 x=−8..10、z=±7（贴臂、避开拼接凸台）+ 宽板 x=9..47、z=±18.5，含 Ø36.4 导向孔与 4×M4；板占 y[141,149]，**底面 y=141 与电机法兰顶面共面**（中心 =(141+T/2)）。
- 后抱箍：300° 包角/60° 开口朝臂/内径 Ø36.4/壁 3mm/y=175..217；耳板 z=±7..11、2×M4 贯穿臂身（y=184/209）。
- 抱箍 STL 已绕 X 转 90° 导出（内孔轴竖直，直接打印免支撑）。

### 拼接
沿用 v4 一体化搭接凸台 + 2×M4 竖向贯穿；螺母改尼龙自锁。

## 三、打印姿态与支撑

| 零件 | 姿态 | 支撑 |
|---|---|---|
| 上臂近端（含安装板） | 平躺，孔轴竖直 | 安装板 Ø36.4 导向孔为水平孔——建议切片器开支撑或改泪滴顶 |
| 上臂远端 / 前臂远端 | 平躺 | 无 |
| 前臂近端 | **绕 X 翻转 180°**（D 侧板朝下落床） | 侧板悬伸面全部落床，免支撑 |
| rodClevis | 平躺 | 沉龛顶 10mm 桥接（默认可桥） |
| motorCollar | **绕 X 转 90°（STL 已摆好）** | 内孔竖直免支撑；耳板 M4 孔为 4mm 浅横孔 |
| linkBD | 平躺 | 无 |

## 四、校验记录（全绿）

| 校验 | 结果 |
|---|---|
| `verify_near_joint.cjs`（0.05°，2401 姿态，102 网格 3390 对） | **0 碰撞**；非配合连续下限 **0.59mm**（最紧：电机前端面 vs 上臂，1.0mm 名义）；配合区=孔半径+0.6mm |
| `verify_serviceability.cjs` | **50/50**：三关节×3 姿态工具/抽销通道、轴向浮动 1.0mm/侧、电机抽出与法兰/抱箍工具通道、连杆等宽 15.00mm、无铆接、紧固件齐套 |
| `verify_print_geometry.cjs` | **28/28**：孔径/通孔/倒角/壁厚/7 部件连通/220mm 幅面（最差 170.4mm） |
| `check_stl.cjs` | 0 问题文件 |
| STL | 7 打印件（`stl/`，按打印姿态落地）+ 11 项外购 BOM（`stl/index.json`） |
