zhaoxiaofeng44/robot_arm/assembly_guide.md

# 装配与拆解指南（v5 可拆肩螺栓版）

工具：**2.5/3/4/5/6mm 内六角扳手 + 13/10/7mm 叉扳手（或套筒）**。紧固件全部外购 304 不锈钢（清单见 `stl/index.json` → `purchased_parts_bom`）。

## 零件清单

**打印件（7）**：上臂近端段（含电机法兰安装板）、上臂远端段（含肘叉耳）、前臂近端段（含肘轴套+毂+D 侧板叉耳）、前臂远端段（含末端法兰）、电机后抱箍、B 推杆叉头、BD 长条连杆。

**外购件**：Ø10×26 肩螺栓 ×1（O）、Ø8×18 ×1（B）、Ø8×20 ×1（D）、M6 螺母 ×1（B 沉龛，坐底板/围壁防转）、平垫若干、M8/M6 尼龙自锁螺母 ×3、M4×36 ×6（拼接，臂身已开 Ø4.4 通孔）、M4×22+自锁 ×4（抱箍双侧耳板）、M4×16 ×4（电机法兰，配 4 只 M4 热熔螺母更佳）。

## 装配顺序

1. **拼接臂身**：上臂近端+远端沿搭接凸台对接，2×M4×36 竖向（孔轴沿 Z）穿过凸台，平垫+尼龙自锁螺母紧固；前臂两段同理。
2. **装 B 叉头（在电机自由位，θ≈0，外露推杆最长 ≈84mm）**：
   - M6 螺母旋上推杆端部螺纹（≈旋入 5mm）；
   - 叉头自上而下套入：螺母落入沉龛并**坐在底板上**、被四周围壁包住（六角面防转）；推杆端面停在底板上方 0.5mm（底板不开孔）；
   - 叉头耳板内档对准连杆安装平面。
3. **装 BD 连杆（沿 Z）**：连杆保持竖直（z 向），B 端先对入叉头双耳之间，D 端同时对入前臂双侧板之间——两处内档均 10mm、连杆 8mm，沿 Z 直落即可（不要斜着硬塞；若卡滞检查两孔位是否同在 z=0 平面）。
4. **锁三处销轴（均沿 Z）**：
   - O：Ø10×26 肩螺栓头上侧穿入（头贴耳片外面）→ 出轴套 → 平垫 + M8 尼龙自锁螺母，扳手锁至螺母尼龙圈咬合（约再 1/4 圈），确认轴套转动顺滑、轴向窜动 ≈1mm；
   - B：Ø8×18 同法；D：Ø8×20 同法（两侧 1mm 凸台自动定浮动）。
5. **装电机**：缸体自上而下穿过抱箍（开口朝臂侧不影响轴向插入），前端法兰**顶面贴住安装板底 y=141**；4×M4×16 自下向上旋入安装板（先装热熔螺母则拧入更稳）；最后 2×M4×22 贯穿抱箍耳板与上臂侧面，平垫+自锁螺母锁紧。
6. **自检**：手动屈臂 0→120° 全程无卡滞；三销轴处连杆/轴套轴向窜动约 1mm/侧为正常（设计浮动）。

## 拆解顺序（与装配互逆，无需拆臂身即可换连杆/轴套/电机）

1. 卸电机：4×M4 法兰螺栓 → 上抽缸体（穿过抱箍）；如需分离抱箍再卸 2×M4。
2. 卸连杆：O/B/D 三处旋下自锁螺母 → 抽出肩螺栓 → BD 连杆**沿 Z** 滑出双耳。
3. 卸 B 叉头：旋退沉龛内 M6 螺母（叉头随螺母一起脱离推杆螺纹）。
4. 卸前臂：O 抽销后轴套沿 Z 滑出上臂叉耳。
5. 分段臂身：卸拼接凸台 6×M4。

> 注意：沉龛内 M6 螺母旋离推杆后可能留在龛内（六角防转、开口朝电机侧），倒出即可，不会丢失在机构内部。

## 力矩与防松

| 部位 | 紧固件 | 建议力矩 | 防松 |
|---|---|---|---|
| O 销轴 | Ø10×26 肩螺栓 M8 | 15–20 N·m（金属螺母入塑料耳，以压平垫不陷胶为准） | 尼龙自锁螺母 |
| B/D 销轴 | Ø8×18/20 肩螺栓 M6 | 8–10 N·m | 尼龙自锁螺母 |
| 抱箍 | M4×22 | 2.5–3 N·m | 尼龙自锁螺母 |
| 电机法兰 | M4×16 | 2.5–3 N·m | 热熔螺母/螺纹胶 |
| 拼接 | M4×36 | 2.5–3 N·m | 尼龙自锁螺母 |

尼龙自锁螺母反复拆装 ≥10 次后锁紧力衰减，建议更换。

## 间隙与磨合

- 转动配合单边 0.3mm；新机可能有轻微阻力，往返数次即顺滑。
- 轴向浮动设计值 1.0mm/侧，专为大浮动免卡死与易拆装；如需更高回转精度，可在孔内加薄壁轴承套（扩孔 Ø11/Ø13 压入）。
- 孔壁磨损后：O/B/D 孔可统一扩孔压入标准 bronze 衬套（内径恢复 Ø10/Ø8）。

## 已知打印注意项

- 安装板 Ø36.4 导向孔为水平孔：切片时开支撑，或按泪滴形手工扩顶（模型按圆孔交付）。
- B 叉头沉龛顶面 10mm 桥接：0.2mm 层高直接桥接即可；M6 丝攻清根后使用更顺。
- 前臂近端段**翻转 180°** 打印（D 侧板朝下）；抱箍 STL 已按孔轴竖直姿态导出。
