zhaoxiaofeng44/robot_arm/preview/print_assembly_iso.png

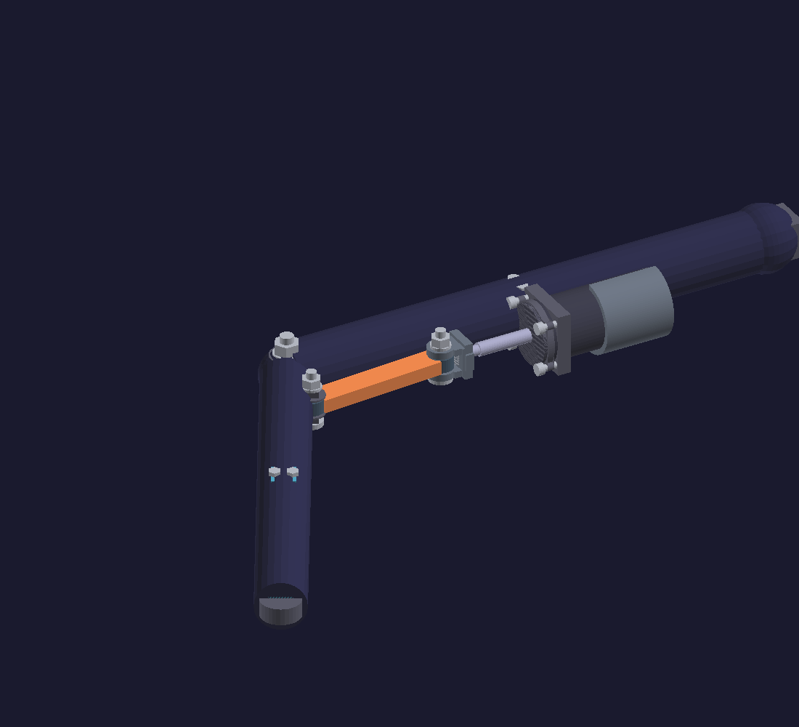
preview/print_assembly_iso.png
