zhaoxiaofeng44/robot_arm/preview/print_elbow_closeup.png

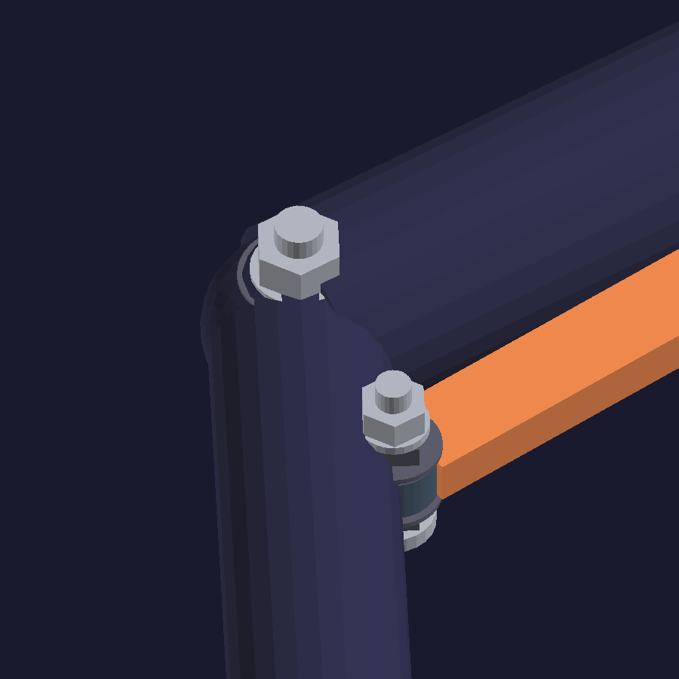
preview/print_elbow_closeup.png
