zhaoxiaofeng44/robot_arm/preview/print_joints_alongZ.png

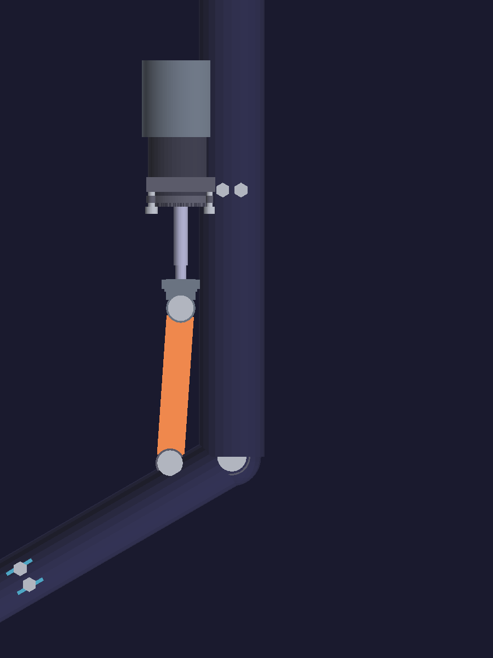
preview/print_joints_alongZ.png
