zhaoxiaofeng44/robot_arm/preview/print_linkB_closeup.png

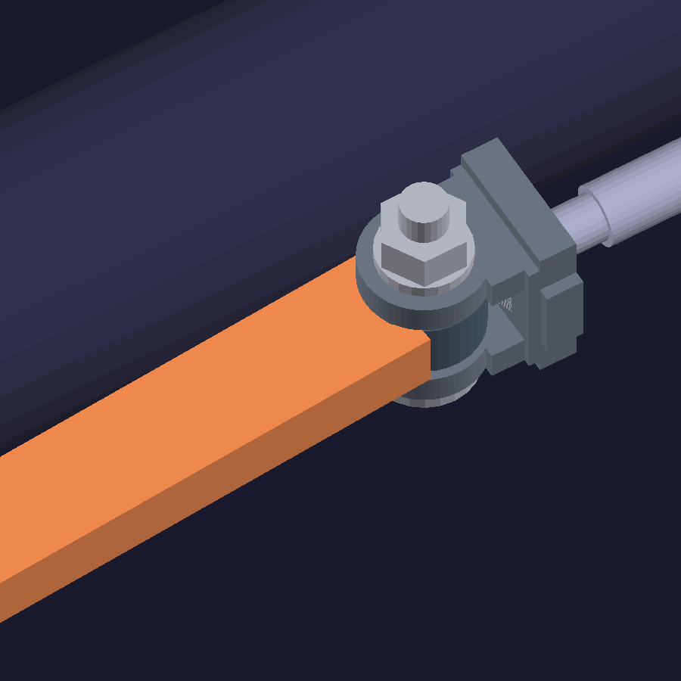
preview/print_linkB_closeup.png
