zhaoxiaofeng44/robot_arm/connections_verify_report_spread.txt

=== 展开/并拢副连接物理性审计（verify_spread.cjs） ===

  PASS  食指 展开副零件齐套（19 类）
  PASS  食指 Ø10 铰链销轴线沿 x（指根摆动轴）   [长26.00 截面10.00×10.00]
  PASS  食指 Ø10 销穿过叉耳孔 L（同轴 ≤0.5mm）   [Δ=0.00mm]
  PASS  食指 Ø10 销穿过叉耳孔 R（同轴 ≤0.5mm）   [Δ=0.00mm]
  PASS  食指 Ø10 销穿过毂孔（同轴 ≤0.5mm）   [Δ=0.00mm]
  PASS  食指 Ø8 D 销穿过D 双耳 L（同轴 ≤0.5mm）   [Δ=0.00mm]
  PASS  食指 Ø8 D 销穿过D 双耳 R（同轴 ≤0.5mm）   [Δ=0.00mm]
  PASS  食指 Ø8 D 销穿过连杆 D 端环（同轴 ≤0.5mm）   [Δ=0.00mm]
  PASS  食指 B 销穿过连杆 B 端环（同轴 ≤0.5mm）   [Δ=0.00mm]
  PASS  食指 C 形吊架上下都咬住（安装板 ↔ 掌骨方块）   [下 -16.00mm / 上 3.00mm]
  PASS  食指 展开全程 |BD| ≡ 85mm（φ=±12°）   [最大偏差 0.00e-6mm]
  PASS  食指 推杆露出段长度为正（不顶死不脱出）   [露出 74.00mm（B 局部 y=-85.00，前端面 -11）]
  PASS  中指 展开副零件齐套（19 类）
  PASS  中指 Ø10 铰链销轴线沿 x（指根摆动轴）   [长26.00 截面10.00×10.00]
  PASS  中指 Ø10 销穿过叉耳孔 L（同轴 ≤0.5mm）   [Δ=0.00mm]
  PASS  中指 Ø10 销穿过叉耳孔 R（同轴 ≤0.5mm）   [Δ=0.00mm]
  PASS  中指 Ø10 销穿过毂孔（同轴 ≤0.5mm）   [Δ=0.00mm]
  PASS  中指 Ø8 D 销穿过D 双耳 L（同轴 ≤0.5mm）   [Δ=0.00mm]
  PASS  中指 Ø8 D 销穿过D 双耳 R（同轴 ≤0.5mm）   [Δ=0.00mm]
  PASS  中指 Ø8 D 销穿过连杆 D 端环（同轴 ≤0.5mm）   [Δ=0.00mm]
  PASS  中指 B 销穿过连杆 B 端环（同轴 ≤0.5mm）   [Δ=0.00mm]
  PASS  中指 C 形吊架上下都咬住（安装板 ↔ 掌骨方块）   [下 -16.00mm / 上 3.00mm]
  PASS  中指 展开全程 |BD| ≡ 85mm（φ=±12°）   [最大偏差 0.00e-6mm]
  PASS  中指 推杆露出段长度为正（不顶死不脱出）   [露出 74.00mm（B 局部 y=-85.00，前端面 -11）]
  PASS  无名指 展开副零件齐套（19 类）
  PASS  无名指 Ø10 铰链销轴线沿 x（指根摆动轴）   [长26.00 截面10.00×10.00]
  PASS  无名指 Ø10 销穿过叉耳孔 L（同轴 ≤0.5mm）   [Δ=0.00mm]
  PASS  无名指 Ø10 销穿过叉耳孔 R（同轴 ≤0.5mm）   [Δ=0.00mm]
  PASS  无名指 Ø10 销穿过毂孔（同轴 ≤0.5mm）   [Δ=0.00mm]
  PASS  无名指 Ø8 D 销穿过D 双耳 L（同轴 ≤0.5mm）   [Δ=0.00mm]
  PASS  无名指 Ø8 D 销穿过D 双耳 R（同轴 ≤0.5mm）   [Δ=0.00mm]
  PASS  无名指 Ø8 D 销穿过连杆 D 端环（同轴 ≤0.5mm）   [Δ=0.00mm]
  PASS  无名指 B 销穿过连杆 B 端环（同轴 ≤0.5mm）   [Δ=0.00mm]
  PASS  无名指 C 形吊架上下都咬住（安装板 ↔ 掌骨方块）   [下 -16.00mm / 上 3.00mm]
  PASS  无名指 展开全程 |BD| ≡ 85mm（φ=±12°）   [最大偏差 0.00e-6mm]
  PASS  无名指 推杆露出段长度为正（不顶死不脱出）   [露出 74.00mm（B 局部 y=-85.00，前端面 -11）]
  PASS  小指 展开副零件齐套（19 类）
  PASS  小指 Ø10 铰链销轴线沿 x（指根摆动轴）   [长26.00 截面10.00×10.00]
  PASS  小指 Ø10 销穿过叉耳孔 L（同轴 ≤0.5mm）   [Δ=0.00mm]
  PASS  小指 Ø10 销穿过叉耳孔 R（同轴 ≤0.5mm）   [Δ=0.00mm]
  PASS  小指 Ø10 销穿过毂孔（同轴 ≤0.5mm）   [Δ=0.00mm]
  PASS  小指 Ø8 D 销穿过D 双耳 L（同轴 ≤0.5mm）   [Δ=0.00mm]
  PASS  小指 Ø8 D 销穿过D 双耳 R（同轴 ≤0.5mm）   [Δ=0.00mm]
  PASS  小指 Ø8 D 销穿过连杆 D 端环（同轴 ≤0.5mm）   [Δ=0.00mm]
  PASS  小指 B 销穿过连杆 B 端环（同轴 ≤0.5mm）   [Δ=0.00mm]
  PASS  小指 C 形吊架上下都咬住（安装板 ↔ 掌骨方块）   [下 -16.00mm / 上 3.00mm]
  PASS  小指 展开全程 |BD| ≡ 85mm（φ=±12°）   [最大偏差 0.00e-6mm]
  PASS  小指 推杆露出段长度为正（不顶死不脱出）   [露出 74.00mm（B 局部 y=-85.00，前端面 -11）]
  PASS  拇指 展开副零件齐套（19 类）
  PASS  拇指 Ø10 铰链销轴线沿 x（指根摆动轴）   [长26.00 截面10.00×10.00]
  PASS  拇指 Ø10 销穿过叉耳孔 L（同轴 ≤0.5mm）   [Δ=0.00mm]
  PASS  拇指 Ø10 销穿过叉耳孔 R（同轴 ≤0.5mm）   [Δ=0.00mm]
  PASS  拇指 Ø10 销穿过毂孔（同轴 ≤0.5mm）   [Δ=0.00mm]
  PASS  拇指 Ø8 D 销穿过D 双耳 L（同轴 ≤0.5mm）   [Δ=0.00mm]
  PASS  拇指 Ø8 D 销穿过D 双耳 R（同轴 ≤0.5mm）   [Δ=0.00mm]
  PASS  拇指 Ø8 D 销穿过连杆 D 端环（同轴 ≤0.5mm）   [Δ=0.00mm]
  PASS  拇指 B 销穿过连杆 B 端环（同轴 ≤0.5mm）   [Δ=0.00mm]
  PASS  拇指 C 形吊架上下都咬住（安装板 ↔ 掌骨方块）   [下 -16.00mm / 上 3.00mm]
  PASS  拇指 展开全程 |BD| ≡ 85mm（φ=±12°）   [最大偏差 0.00e-6mm]
  PASS  拇指 推杆露出段长度为正（不顶死不脱出）   [露出 74.00mm（B 局部 y=-85.00，前端面 -11）]

结果: 60/60 全部成立 ✓
