zhaoxiaofeng44/robot_arm/connections_verify_report_finger.txt

######################################################################
# 连接物理性审计  target=finger  (finger_mechanism_3d.html)   网格数=294
######################################################################

== 0. 基准参数 ==
   电机 Ø36x80  A=(28,213)  前端面 y=137  后端面 y=217
   连杆 BD=85  D0=(14,-31)  O销Ø10  B/D销Ø8
   安装板 y0=141 厚8  抱箍 y=175..217  拼接孔Ø4.4@x=±4.5  y偏移6

== 1. 电机安装：前法兰 <-> 安装板（承推面）==
   m0MotorFlange  y=[137.000,141.000]  外径Ø38.000
   palmFlangePlate  y=[141.000,149.000]
   -> 法兰与安装板相对面共面：接触 OK
   m0FlangeBolt1Head y=[133.000,137.000] 顶住法兰 OK
   安装板导出孔(x=28,z=0) 射线命中 0  -> 通孔 OK
   安装板 M4 孔(x=12,z=13) 射线命中 0  -> 通孔 OK
   安装板 M4 孔(x=44,z=13) 射线命中 0  -> 通孔 OK
   m1MotorFlange  y=[-163.000,-159.000]  外径Ø38.000
   p1FlangePlate  y=[-159.000,-151.000]
   -> 法兰与安装板相对面共面：接触 OK
   m1FlangeBolt1Head y=[-167.000,-163.000] 顶住法兰 OK
   安装板导出孔(x=28,z=0) 射线命中 0  -> 通孔 OK
   安装板 M4 孔(x=12,z=13) 射线命中 0  -> 通孔 OK
   安装板 M4 孔(x=44,z=13) 射线命中 0  -> 通孔 OK
   m2MotorFlange  y=[-463.000,-459.000]  外径Ø38.000
   p2FlangePlate  y=[-459.000,-451.000]
   -> 法兰与安装板相对面共面：接触 OK
   m2FlangeBolt1Head y=[-467.000,-463.000] 顶住法兰 OK
   安装板导出孔(x=28,z=0) 射线命中 0  -> 通孔 OK
   安装板 M4 孔(x=12,z=13) 射线命中 0  -> 通孔 OK
   安装板 M4 孔(x=44,z=13) 射线命中 0  -> 通孔 OK

== 2. 后抱箍 <-> 段身（2xM4 贯穿 + 双侧耳板）==
   抱箍耳板网格 (12 片): m1CollarTabA, m1CollarTabAN, m1CollarTabB, m1CollarTabBN, m2CollarTabA, m2CollarTabAN, m2CollarTabB, m2CollarTabBN, m0CollarTabA, m0CollarTabAN, m0CollarTabB, m0CollarTabBN
   螺栓A：耳板 6 片  z>0:true  z<0:true  -> 双侧夹持 OK
   螺栓B：耳板 6 片  z>0:true  z<0:true  -> 双侧夹持 OK
   palmBodyProximal z=[-7.000,7.000]  抱箍螺栓孔位 y=184/209
   m0CollarBoltShankA 光杆 z=[-11.000,11.000] 长 22.000mm；双侧夹持所需 = 段身14.000+2x4 = 22.000mm
   p1BodyHeel z=[-6.000,6.000]  抱箍螺栓孔位 y=184/209
   m1CollarBoltShankA 光杆 z=[-11.000,11.000] 长 22.000mm；双侧夹持所需 = 段身12.000+2x4 = 20.000mm
   p2BodyHeel z=[-6.000,6.000]  抱箍螺栓孔位 y=184/209
   m2CollarBoltShankA 光杆 z=[-11.000,11.000] 长 22.000mm；双侧夹持所需 = 段身12.000+2x4 = 20.000mm

== 3. 分段拼接：M4 竖向贯穿（垫板有孔；本体也必须开孔）==
   palmPSpliceBoltL @(x=-4.500,y=146.000) 穿过本体 palmBodyProximal  z向实体命中 0  -> 有通孔 OK
   palmPSpliceBoltR @(x=4.500,y=146.000) 穿过本体 palmBodyProximal  z向实体命中 0  -> 有通孔 OK
   p1DSpliceBoltL @(x=-4.500,y=-176.000) 穿过本体 p1BodyDistal  z向实体命中 0  -> 有通孔 OK
   p1DSpliceBoltR @(x=4.500,y=-176.000) 穿过本体 p1BodyDistal  z向实体命中 0  -> 有通孔 OK
   p2DSpliceBoltL @(x=-4.500,y=-476.000) 穿过本体 p2BodyDistal  z向实体命中 0  -> 有通孔 OK
   p2DSpliceBoltR @(x=4.500,y=-476.000) 穿过本体 p2BodyDistal  z向实体命中 0  -> 有通孔 OK
   p3DSpliceBoltL @(x=-4.500,y=-731.000) 穿过本体 p3BodyDistal  z向实体命中 0  -> 有通孔 OK
   p3DSpliceBoltR @(x=4.500,y=-731.000) 穿过本体 p3BodyDistal  z向实体命中 0  -> 有通孔 OK

== 4. B 推杆叉头：底板通孔 / 螺母落位 ==
   [m0] m0BridgeFloor y=[61.839,63.839] （底板 18x2x18）
        m0RodNut y=[63.839,68.839] 高5.000 对边10
        螺母<->底板 y 重叠 = -0.000mm -> 螺母坐在底板顶面 OK
        底板中心 实体命中 4 -> 实心
        杆端面高于底板顶面 0.500mm、螺母坐在底板顶面 → 底板无需开孔 ✓
        杆端螺纹段 y=[64.339,76.339]  与螺母啮合长度 = 4.500mm（≥2mm 可用）
        防转围壁 y=[63.339,69.339] 相对螺母[ 63.839,68.839] 完整包住 OK（拉力靠螺纹副+防转传递）
   [m1] m1BridgeFloor y=[-238.161,-236.161] （底板 18x2x18）
        m1RodNut y=[-236.161,-231.161] 高5.000 对边10
        螺母<->底板 y 重叠 = -0.000mm -> 螺母坐在底板顶面 OK
        底板中心 实体命中 4 -> 实心
        杆端面高于底板顶面 0.500mm、螺母坐在底板顶面 → 底板无需开孔 ✓
        杆端螺纹段 y=[-235.661,-223.661]  与螺母啮合长度 = 4.500mm（≥2mm 可用）
        防转围壁 y=[-236.661,-230.661] 相对螺母[ -236.161,-231.161] 完整包住 OK（拉力靠螺纹副+防转传递）
   [m2] m2BridgeFloor y=[-538.161,-536.161] （底板 18x2x18）
        m2RodNut y=[-536.161,-531.161] 高5.000 对边10
        螺母<->底板 y 重叠 = -0.000mm -> 螺母坐在底板顶面 OK
        底板中心 实体命中 2 -> 实心
        杆端面高于底板顶面 0.500mm、螺母坐在底板顶面 → 底板无需开孔 ✓
        杆端螺纹段 y=[-535.661,-523.661]  与螺母啮合长度 = 4.500mm（≥2mm 可用）
        防转围壁 y=[-536.661,-530.661] 相对螺母[ -536.161,-531.161] 完整包住 OK（拉力靠螺纹副+防转传递）

== 5. 手掌侧接口：palm_mount <-> 掌段指根方块 ==
   palmBase(指根方块)     y=[300.000,320.000]  x±12.000 z±11.000
   palmFlangeBase(法兰板) y=[320.000,326.000]  x±28.000 z±28.000
   法兰板底面 vs 方块顶面 间隙 = 0.000mm -> 面接触 OK
   内圈 M4 @(x=8,z=7)：法兰过孔命中0 通孔OK；方块底孔命中0 通孔OK
   内圈 M4 @(x=8,z=-7)：法兰过孔命中0 通孔OK；方块底孔命中0 通孔OK
   内圈 M4 @(x=-8,z=7)：法兰过孔命中0 通孔OK；方块底孔命中0 通孔OK
   内圈 M4 @(x=-8,z=-7)：法兰过孔命中0 通孔OK；方块底孔命中0 通孔OK
   M4×16 螺栓杆 y=[310.000,326.000]（穿法兰板6 + 旋入方块10）
   外圈 Ø5.5 掌侧孔: (22,22) (22,-22) (-22,22) (-22,-22)  命中=0/0/0/0

== 6. 销轴副堆叠（孔 / 浮动 / 销杆）==
   O0  palmForkL z=[-13.000,-8.000]   p1SleeveBody z=[-7.000,7.000]
      o0BoltShank z=[-13.000,13.000] 长26.000 需覆盖[-13.000,7.000] OK
   D0  p1DClevisBossL z=[5.000,6.000]   p1DClevisBossR z=[-6.000,-5.000]
      p1dBoltShank z=[-10.000,10.000] 长20.000 需覆盖[-6.000,6.000] OK
   B0  m0ClevisPlateL z=[5.000,9.000]   m0ClevisPlateR z=[-9.000,-5.000]
      m0bBoltShank z=[-9.000,9.000] 长18.000 需覆盖[-9.000,9.000] OK
   O1  p1ForkL z=[-13.000,-8.000]   p2SleeveBody z=[-7.000,7.000]
      o1BoltShank z=[-13.000,13.000] 长26.000 需覆盖[-13.000,7.000] OK
   D1  p2DClevisBossL z=[5.000,6.000]   p2DClevisBossR z=[-6.000,-5.000]
      p2dBoltShank z=[-10.000,10.000] 长20.000 需覆盖[-6.000,6.000] OK
   B1  m1ClevisPlateL z=[5.000,9.000]   m1ClevisPlateR z=[-9.000,-5.000]
      m1bBoltShank z=[-9.000,9.000] 长18.000 需覆盖[-9.000,9.000] OK
   O2  p2ForkL z=[-13.000,-8.000]   p3SleeveBody z=[-7.000,7.000]
      o2BoltShank z=[-13.000,13.000] 长26.000 需覆盖[-13.000,7.000] OK
   D2  p3DClevisBossL z=[5.000,6.000]   p3DClevisBossR z=[-6.000,-5.000]
      p3dBoltShank z=[-10.000,10.000] 长20.000 需覆盖[-6.000,6.000] OK
   B2  m2ClevisPlateL z=[5.000,9.000]   m2ClevisPlateR z=[-9.000,-5.000]
      m2bBoltShank z=[-9.000,9.000] 长18.000 需覆盖[-9.000,9.000] OK

== 7. 运动学 / 连杆错位 ==
   连杆孔心<->销心 最大偏差 = 2.34e-13 mm  (应 0)
   闭环 |BD|-85 最大误差 = 1.99e-13 mm
   连杆两端锚点(B叉头<->D销)距 最大偏差 = 0.000 mm  (刚杆应恒 0)
   传动角范围 = 33.78 .. 89.99 deg
   推杆外露(前端面->叉头桥顶) = 22.05 .. 68.16 mm ；行程需求 46.11 mm
   s(theta) 单调（无死点）：是 OK
   [参考] theta=60 理想静载杆力 315.9 N（5kg@250mm）
