zhaoxiaofeng44/robot_arm/(commit log)

2026-09-29 Add validated robot arm mechanism
    Model the clevis-pin joints and body-mounted cylindrical actuator with reproducible kinematic and clearance verification.
2026-09-30 v4 零件一体化精简：24打印件→7打印件，关节改单件肩铆钉
    - 关节：销+销头+内六角+锁紧螺母(4件/关节) → 单件肩铆钉(1件)，O/B/D 共3根，B/D同规格
    - 衬套：取消全部4件压入衬套，Ø10.6/Ø8.6 孔直接打印（单边0.3mm间隙，孔轴沿Z）
    - 电机固定：双抱箍+双桥板(4件) → 一体化鞍座(双C形环+脊板+加强肋，1件)
    - 拼接：4块独立搭接法兰 → 一体化搭接凸台（长在臂身上，L形截面贴身熔合，每处2×M4）
    - 叉耳：上臂叉耳/前臂D叉耳与臂身一体打印，yoke web桥接消除1mm悬浮缝
    - 修复：v3外层拼接凸台为打印孤岛（连通性校验器实测发现），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
    [forearmDistal.stl, forearmProximal.stl, linkBD.stl, motorSaddle.stl, rivetB.stl, rivetD.stl, rivetElbow.stl, rodClevis.stl]
2026-10-01 v5 可拆化重构：等宽长条连杆 + 全可拆肩螺栓关节 + 电机法兰/抱箍安装
    - BD连杆改为100x15x8等宽长条（R7.5圆弧端，孔壁3.2mm）
    - O/B/D销轴全部改为外购可拆肩螺栓+平垫+尼龙自锁螺母（取消镦铆）
    - B叉头：独立打印件，开放双耳+M6螺母沉龛夹持桥（推杆端部螺纹连接）
    - D叉耳：贴前臂侧面双板（连杆z带之外），取消跨连杆桥板（消除干涉）
    - 电机：前法兰承推（安装板与上臂一体，4xM4）+ 后部300°开口抱箍（2xM4）；缸体90->80mm（行程/力不变）
    - 轴向浮动0.5->1.0mm/侧；前臂O位开R5.4销轴让位缺口
    - verify_near_joint收紧配合区至孔半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
2026-10-01 三节手指机构：两个v5肘关节单元拼接（双电机独立驱动两关节）
    - 新增finger_mechanism_3d.html：P1近节(300,基节,电机1) + P2中节(300,拼接件=单元1前臂+单元2上臂,电机2) + P3远节(250+指尖)
    - 机构几何与已验证肘版完全一致（叉耳/袖套/长条连杆/电机安装/紧固件，零件可互换），运动学零改动
    - 电机安装臂逐级向指尖一侧前移：电机1随P1驱动关节1，电机2随P2驱动关节2
    - P2拼接线移至y=-170，让开电机2抱箍与关节2耳片；关节衔接堆叠与浮动(1mm/侧)与肘版相同
    - getJoints输出双单元关节中心；两单元闭合误差<4.3e-14mm
    - 新增verify_finger.cjs：θ1/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
2026-10-01 手指模型多视角预览：10个角度（整体/主视/特写/极限位）+ 自动取景渲染器
    - 新增render_finger_preview.cjs：复用软件渲染管线，按部件包围盒/关节邻域自动取景
    - preview/finger_01..10：卷曲态整体等轴/主视/另一侧、关节1、关节2+指尖、连杆、电机1/2安装特写、伸直态、全屈极限
    - finger_design_spec.md 补充预览图索引
2026-10-01 清理首轮命名的冗余预览图（统一为 finger_01..10 编号）
2026-10-01 手指STL出档 + 打印/拆装综合校验
    - 新增export_finger_stl.cjs：12个打印件按姿态导出至stl_finger/（连杆长轴自动摆正为15x100x8）
    + 11项外购BOM（肩螺栓/自锁螺母/平垫/M4，两单元合计）
    - 新增verify_finger_print.cjs：94/94通过
    -> 幅面与落地、两单元关键孔(通孔/孔径/倒角/壁厚)、等宽长条、两单元零件可互换签名
    -> 0/60/120度x两单元共18项螺母侧工具通道、两电机抽出通道、无永久连接、紧固件齐套
    - finger_design_spec.md 补充打印件清单与校验结论
2026-10-02 收尾：一键全量校验 + 手指装配指南 + 项目README
    - 新增verify_all.cjs：顺序执行肘版/手指版全部6项校验并输出总表（--quick快速自查）
    - 新增finger_assembly_guide.md：三段拼装、双电机装配、关节沿Z合拢、拆解顺序、力矩表
    - 新增README.md：两个模型的构型/核心设计/校验结果/文件索引/打印选型
    - 完整模式全绿：肘版下限0.59mm、手指闭合4.3e-14mm、拆装50/50与94/94
2026-10-02 v6 手指完善：掌骨安装法兰+指尖防滑垫+连杆减重孔+交互修复，校验96/96，新增12视角预览
2026-10-10 v7 连接物理性修正：单指反根整手 + 真碰撞扫描 + 校验器可信度
    几何
    - 电机前法兰：Ø38 圆盘 + 4×M4 孔落在盘外（earcut 自交三角、幽灵面挡工具通道）
    → 统一改为 38×37×4 方板（孔全部在板内 + 中心 Ø10 导向孔）：arm/finger/hand 三件一致，
    肘版可拆装性恢复 50/50
    - 手指 P2 远端躯体止于 -300+13，消除与 P3 袖套/毂的 127mm² 实体重叠（与手版对称）
    - 手版反根链修正：删掉 P3 上重复的 O2 叉耳；P3 袖套留在 P3（不再搬去 P1 的 O1）；
    t2 连杆组挂世界系（原先被搬进 p2Body 后仍按世界坐标摆位，D 眼环漂移 ~1.5mm 扫入 P3 腰身）
    校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
2026-10-11 手指：新增第三个关节（掌指关节），三个同构关节单元串联
    - 链条改为 掌(固定,载电机0) ─O0─ P1(载电机1) ─O1─ P2(载电机2) ─O2─ P3，关节方式与原有两节逐项相同
    - 原 P1 变掌段（仅去掉近端被驱动接口，本体/方块/法兰/电机/叉耳逐件原样）、原 P2 变 P1；新增 P2 中节与原 P2 逐件同几何 → 三单元零件可互换
    - 抽出 buildDrivenPhalanx() 统一生成被驱动段；getJoints(a0,a1,a2) 三级复合到世界系；UI 改三滑杆 + 直/半/全屈预设 + 同比联动演示
    - 新增安全行程包络 90/90/70（5° 全网格扫出碰撞边界：再卷指尖会回到掌段）
    - verify_finger：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
2026-10-11 整手 v9：五指（四指 3 关节 + 拇指 2 关节）= 14 个同构关节单元
    - 模型：hand_mechanism_3d.html 重建为五指整手（1395 网格 / 名称唯一 / 0 坏盒）。五指 MCP 共线 y=0、
    机构平面互相平行（指距 70mm），拇指 2 关节置于掌骨板另一端 z=-220；1:1 与手指版同尺寸，
    整手伸直 1250mm。
    - 掌体骨架（5 打印件）：掌骨板A/B（66x10，分缝 z=-55 落在无指根法兰空档内）+ 顶部拼接条 +
    腕拼接块（含 4xØ14 凸台与 Ø40 走线孔）+ 拇指桥；骨架紧固件全部布置在无极根法兰的 z 空档内，
    与指根 M5 不打架；指根接口 = 4xØ4.2（M5）+ 4xØ9（M4 头让位，与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
2026-10-11 修复整手预览取景：指尖/指根不再上下颠倒（机构本身未改动）
    - 根因：render_hand_preview.cjs 沿用了打印/肘版的相机基（up=+z），hand_02 又用「沿 +y 俯视指根」、
    hand_03 用「沿 +x」，画面里手指轴线被判成水平/纵深 → 看起来像指尖与指根颠倒。
    - 先核对机构：新增 _hand_parts/cmp_finger.cjs 把整手食指与 finger_mechanism_3d.html 逐件对比——
    294 个网格逐件同名同位，电机 0/1/2 相对 MCP 分别为 +177 / -123 / -423 mm（即都在各自节的
    靠近指尖一端、推杆朝该节远端关节驱动），与单指版完全一致，未做任何改动。
    - 取景修复：相机基统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
2026-10-11 整手五指改为反根装配：指尖端接掌、原指根端成为指尖
    按要求把每个指头“指尖那一端”接到手掌：末端段 Pn 成为接掌固定段（其远端面外
    26mm 挂指根方块 + 56×56 掌骨安装法兰，孔位/让位孔与改前逐点相同），自由端变
    成原指根端的掌段，外端带 Ø24 圆头 + 半球垫 + 3 条防滑棱，即现在的指尖
    （指尖 y=−864mm 四指 / −564mm 拇指，与改前同位）。掌体骨架、五指指距、14 台
    电机/连杆/42 组肩螺栓等“其他地方”全部不动。
    实现
    - 整链绕 Z 镜像 180°（chainRoot：rotation.z=π + position.y=2M，M=(掌段−ΣP−末节)/2）
    落到掌面另一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
2026-10-19 整手交互页依赖离线化：three.js/OrbitControls 改走本地 vendor/
    现象：页面原走 CDN（three.js 在 cdnjs、OrbitControls 在 jsdelivr），实测 jsdelivr
    连接被重置 → OrbitControls 加载失败 → initScene 抛错 → 模型整页不显示。
    改动
    - 新增 vendor/three.min.js（r128，603KB）与 vendor/OrbitControls.js（同版本，26KB）；
    - splice.cjs 增加两条 patch，把两处 CDN src 改写为 vendor/ 相对路径，
    重新生成 hand_mechanism_3d.html（几何代码一行未改，仍是 1395 网格 / 1327 行）；
    - 页面现已无任何外部 https 引用，可完全离线打开（file:// 或本地静态服务均可）。
    测试（node 无头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
2026-10-19 整手：每指接掌段侧面加装一台直线电机，经 R26 曲柄 + 85mm 连杆拉动指根绕 x 展开/并拢
    - 新增第 6 自由度×5 指：铰链枢轴 y=289（= 掌骨安装件底面），毂 R11 顶面 300，指根方块 20→17（底面 303）→ 3.00mm 让位
    - 掌部安装件（方块 + 56×56 法兰 + 4×M4/4×M5）整组搬到固定侧（矩阵分解保持世界位姿，孔组一字未动）
    - Ø36×80 电机侧挂于 (x=40, z=+26)、机身 y∈[60,140]（避开拼接垫/关节螺栓），C 形吊架 + 4×M4 安装板 + 后抱箍 2×M4
    - 闭合解析恒等 |BD| ≡ 85.000mm（φ=−12…12° 恒等），推杆仅用 ±5.4mm 行程（59mm 的 9%）
    - verify_hand：0 碰撞 /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
2026-10-19 展开/并拢副：补连接物理性审计（verify_spread 60/60）+ 重渲预览
    - 真 bug 修正：Ø10 铰链销/Ø8 D 销原用 rotation.z（销体原生沿 z，转了等于没转），改 rotation.y=π/2 → 轴线正确落到 x；
    审计实测轴向 26mm 沿 x、截面 10×10，与叉耳孔 L/R、毂孔、曲柄 D 双耳、连杆 D 端环三心同轴 Δ=0.00mm
    - 新增 verify_spread.cjs：逐指 12 项（件齐套 / 销轴轴向 / 三处同轴 / 吊架上下咬合 / φ=±12° 闭合恒等 85.000 / 推杆不顶死）
    - verify_all.cjs 扩到 11 项；render_hand_preview.cjs 重渲（取景朝向自检通过）
    - verify_all --quick：11/11 PASS；verify_hand 0 碰撞 / 1745 网格 / 80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
2026-10-20 预览：新增展开/并拢副特写 hand_11，修正 hand_08 掌指关节特写取景
    - hand_08：原先先下发屈曲姿态再取景，场景矩阵未刷新 → nearPoints 取空（WARN no parts near）；改为零位姿态 + 固定 mm 中心 (0,0,-20)/半径 200，正常出图
    - 新增 hand_11_spread_hinge.png（1200×1000，center≈(9,261,-29)）：叉耳+Ø10 铰链+毂+曲柄+D 双耳+85mm 连杆+侧挂电机+C 形吊架
    - 取景朝向自检仍全绿（接掌固定端在上、指尖在下）
2026-10-20 完整模式校验跑通（45584 姿态）+ README 数字刷新
    - verify_hand.cjs 完整模式（0.05° 细扫 + 每指 5° 三维网格 + 整手姿态）：姿态 45584 / 候选对 16760 / 网格 1745
    碰撞 0、非配合最小间隙 1.000mm、连续下限 +0.444mm（允差 0.556mm，r_max 637mm）、闭合 8.5e-14mm、行程误差 2.535mm、传动角 33.8–89.7°、可拆装互换 95/95
    - README 该行数字由旧基线（+0.192mm / 14679 对 / 85/85）刷新为本版实测值
2026-10-20 展开/并拢电机改到手指侧面：z=+30 侧挂（原误装在掌背侧 x=40），曲柄 R26→R30
    - 原方案的电机轴线偏在 x=+40，即掌背/掌心那一面 —— 是背面，不是侧面；现全部件回到指中面（outX=0），电机横向偏到 z=+30（朝相邻手指那一侧）
    - 机身 z∈[12,48]：避开拼接垫脚（局部 z 6–10）与外指（≥56）；机身 y∈[198,278]，正好是拼接垫螺栓带之上、铰链毂之下的净空带（第一版落到 y198–278 会被 p3 拼接垫脚咬到，靠 z 分离解决）
    - 曲柄半径 R 26→30（力矩臂更大，闭合仍是解析恒等），C 形吊架改 L 形：立柱 z∈[40,52] 站在曲柄眼(≤30)与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
2026-11-07 掌心双电机重构（进行中）：掌板分两半 + Ø10铰链 + 手心侧直线电机拉拇指半
    - 修复 buildChassis 双重定义（旧掌弓方案覆盖新方案导致回归）
    - 掌骨板在拇指/食指之间(z=-150)分成四指半+拇指半，Ø10肩螺栓铰链（与手指关节同规格）
    - 拇指半载拇指桥+整个拇指，绕铰链向掌心折（0..20°滑杆）；电机装四指半手心面
    - UI：折叠角滑杆 + 掌心驱动实时信息；抓握动画同步对折
    - verify_hand.cjs 分类器支持两半掌（PALMDRIVE/CHASSIS）
    - 已知问题：掌心电机与食指/拇指电机仍干涉，--quick 校验未通过（下一步收敛几何）
    - 整理：探索性调试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
